Lonelyrockroll/qiansai/hardware/pcb/32键扩展说明.md

# Nos Pico 32 键 PCB 扩展说明

当前修正版：`ProPrj_nos_pico_32key_repaired_2026-09-24.epro2`，已在嘉立创 EDA 专业版 V4.1.60 中实际导入验证。

原交付路径 `ProPrj_nos_pico_32key_2026-09-24.epro2` 也已替换为相同的修正版内容。EDA 中的修正版工程名为 `nos_pico_32key_repaired`；此前打开的旧工程副本不会自动更新。

## 原理图修复

此前版本在生成工程包时混用了版本元数据和原理图坐标约定，导入后出现符号上下方向异常、引脚线段向元件外侧延伸，与元件边框之间产生间隙。先前仅报告 PCB DRC 通过，没有充分验证原理图显示。

修正版恢复了原 28 键工程的全部符号定义，以及原有 198 个原理图对象的位置和方向。新增四键重新使用原版符号、连续电源/地母线和电源符号绘制，并整理网络标签位置。

此次额外验证包括：

- 放大检查 EDA 中原有与新增灯光的 VDD/GND 引脚与元件边框连续相接。
- 对新增器件的 60 个引脚进行导线坐标相交检查，预期悬空的灯链末端除外。
- 从 EDA 实际导出原理图 `.enet`，验证全部 32 个霍尔的电源、地、信号网络和新增四路 ADG732 通道。
- 验证 64 颗琴键灯的数据串联关系，以及独立的 6 颗 Logo 灯链。
- 将实际原理图网表与交付 PCB 的 656 个焊盘网络逐项比较，0 项不一致。
- 在最终修正版工程中运行 PCB DRC，141 项检查，0 项错误。

## 已完成

- 在右侧增加 H29～H32 四颗 SS49E 霍尔传感器，保持原有 12.5 mm 键距。
- 板框向右延长 50 mm，EDA 显示外形尺寸为 412 × 64 mm。
- 原有 165 个 PCB 元件的位置和旋转角度均保持不变，扩展后共 185 个元件。
- 增加 D64～D71 共八颗琴键灯，接在原琴键灯 D56 之后；原 D57～D62 Logo 灯链保持原连接。
- 增加 C61～C64 四颗霍尔去耦电容、C65～C68 四颗灯光去耦电容，沿用原单元 0.1 µF 规格。
- 完成新增信号、供电、接地布线及双面铺铜重建。
- 新增独立原理图页 `32-key extension - H29-H32`；主原理图接出多路复用器剩余四路，并取消对应未连接标记。
- 原有 R3、R4 的原理图定义恢复为原 28 键版本，未再通过翻转符号规避坐标问题。

## 新增通道

| 琴键 | 网络 | ADG732 物理脚号 | 扫描地址（十进制） | A4～A0 |
| --- | --- | --- | --- | --- |
| H29 | S29 | 37 | 28 | 11100 |
| H30 | S30 | 38 | 29 | 11101 |
| H31 | S31 | 39 | 30 | 11110 |
| H32 | S32 | 40 | 31 | 11111 |

原 28 键的网络映射保持原样；原固件的扫描映射为 0～15、27～16，新增四键应在其后追加 28、29、30、31。

## 验证结果

- 嘉立创 EDA 实际完成 PCB DRC，检查项 141，结果 0 项错误。
- 原理图与 PCB 网表一致。
- 导出包 ZIP 完整性检查通过。
- 对导出文件独立核对：32 颗霍尔、8 颗新增 LED、8 颗新增电容、四路多路复用器脚号及网络、12.5 mm 键距、原有元件几何位置，均通过。
- 本次未制造 PCB，未进行实板电气或演奏测试。
- 原理图继承了原工程的离网格等警告；PCB DRC 的 0 错误不表示所有原理图警告均已消除。

## 后续配套修改

- FPGA 扫描、按键状态数组、校准数据应扩展为 32 键。
- 琴键灯数据长度由 56 颗扩展至 64 颗，Logo 灯仍为 6 颗。
- 若继续使用原 Pico 固件作测试，其 HID 报告中原先 28 琴键加 4 辅助键恰好占用 32 位；扩展后不能继续使用同一 32 位布局，需要同步修改报告结构和描述符。
- 外壳、支撑、转轴与键帽结构需适配新增四键和增加的 50 mm 板长。
- 本次工作范围为 28 键扩展至 32 键；此前讨论的 FPGA ADC 前端、电源跳线和标准 I2S 音频接口方案仍需另行落实。

## 备份与打开方式

扩展前当前 EDA 工程已备份为 `nos_pico_28key_before_expansion_20260924.epro2`，原始 `ProPrj_nos_pico_mini_2026-09-22.epro2` 未覆盖。

使用嘉立创 EDA 专业版的“文件 → 导入 → 嘉立创EDA（专业版）”导入交付文件即可。

`tmp/assessment/drafts` 中仅保存过程文件，不是交付版本。
