Lonelyrockroll/qiansai/MIDI-INPUT.md

# Keystation 61 MK3 五针 MIDI 输入

v33 在分级菜单版工程上增加 BMV51M001 输入。MIDI 数据由 FPGA 内的串口接收器、消息解析器、事件队列和声部分配逻辑处理，进入现有实时音源、效果器和 Loop。演奏输入在电脑、自制琴板和 MIDI 键盘之间切换，J18 的十二个打击垫可同时演奏。

本次交付码流为 `0x0000FAE1`，已于 2026 年 11 月 3 日临时下载到 Tang 并完成 JTAG 回读。本次实物 TX 丝印脚接 J8-5 的接法，已完成模块回环和 Keystation 独立供电的五针实板试弹。Keystation 的 USB 接充电器，演奏数据通过五针线进入模块及 FPGA；用户确认“能发声，松开也正常”。

## 接线与上电

使用 Tang Mega 60K、NEO Dock 31004 和明确包含 `midi_rx / AA19` 输入约束的 v33 码流。先在断电时接好模块供电、地和五针线，将模块实物 TX 数据线暂留空。上电后临时下载并核对 v33，保持该程序运行，再接这根 TX 数据线到 J8-5。

| 本次 BMV51M001 实物丝印 | Tang NEO 31004 |
| --- | --- |
| VDD | J8-1，3.3 V |
| GND | J8-3，GND |
| TX（模块逻辑输出） | J8-5，AA19 / PMOD1_IO6，FPGA 输入 |
| RX、NC | 演奏时留空 |

本次模块照片中，从 NC 起的丝印顺序为 **NC、RX、TX、VDD、GND**，与厂家接口表的 RX/TX 顺序相反。上表按这块实物的丝印和成功回环测量填写。正常演奏只接上述三根线；**只有独立模块回环诊断才把实物 RX 接 J8-6**，恢复演奏时将这根诊断线拔下。

J8 位于 KEY.0 与 POWER 之间，靠 HDMI 一侧。按板上 1 脚标记核对针号，插口正面与焊盘侧的方向互为镜像。J8-7/8 与蓝牙网络相连，J8-9～12 已承担音频和观测信号。

板子元件面朝上、正对 J8 插孔时，离 PCB 板面较高的一排是奇数排。沿插座从 POWER 端向 KEY.0 端依次是 1、3、5、7、9、11，较低的一排依次为 2、4、6、8、10、12。因此模块实物 TX 接较高排从 POWER 端数的第三个孔。官方 PCB 上的方形焊盘标记对应 1 脚。Tang 采用 DC 口供电时，引脚编号和模块使用的 3.3 V 接法相同。

五针线从 Keystation 的 MIDI OUT 接 BMV51M001 的 MIDI IN。Keystation 用自身 USB 供电。厂商资料将光耦后的逻辑输出称为 BMCOM RX，本次实物对应的是 **TX 丝印脚**。6N138 的输出上拉至模块 VDD，本接法使用 3.3 V。[BMV51M001 产品页](https://www.bestmodulescorp.com/tc/bmv51m001.html) · [原厂线路图](https://www.bestmodulescorp.com/en/amfile/file/download/file/2107/product/1316/)

Keystation 开机后，按 **Advanced**，再按琴键上方标有 **MIDI OUT** 的黑键。编辑模式退出后，琴键数据从五针口发送。该步骤见原厂手册的 MIDI Out 小节。[Keystation 61 MKIII 手册第 14 页](https://cdn.inmusicbrands.com/m-audio/maudio_documentation/Keystation%2061%20MKIII%20-%20User%20Guide%20-%20v1.6.pdf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)

实物照片确认 MIDI OUT 位于该区域两颗一组黑键的左颗，ENTER 为它左邻的白键。本机操作反馈为按过这颗黑键后仍须按 ENTER 才退出 Advanced，与上述手册的自动退出步骤不同。不要把 ENTER 灯灭单独作为五针输出已启用的证据，也不要连续盲目切换。

重新上电后的默认五针路由尚未单独验证，当次输出状态通过接收计数和实际发声确认。

SRAM 临时下载在断电后失效。下一次重新上电前先断开接 J8-5 的模块数据线（本次实物 TX），开机重载这份 v33 程序后，再恢复这根数据连接。历史 `control_pmod` 固件曾将 AA19 配成输出，其接线用途与本版不同。

## 使用

1. 在屏幕进入「设置」，选第一项输入来源，短按 B 在 PC、扫描、MIDI 之间轮换。切换会静音。已有 Loop 正在播放、录制或等待录制时，先结束该操作。
2. 选择「输入 MIDI」后，短按 A 回首页，短按 B 开始演奏并等待功放预热。
3. 按键发声，松键进入该音色的释放阶段。默认延音关闭，使用现有键盘即可测试。
4. 按住 B 并旋转调琴键音量。短按 A 或上位机「全部静音」停止演奏。音色、效果、鼓组和 Loop 的入口沿用分级菜单。

MIDI 模式下，音符在没有后续 MIDI 消息时继续保持。上位机断开或关闭页面后，FPGA 可独立演奏。切回 PC 输入时，电脑控制的心跳保护恢复生效。

屏幕设置页显示接收字节、支持的消息事件、异常累计和延音状态，三个数字显示各自计数器的低 16 位。上位机 MIDI 面板显示完整字节／事件计数、帧错误、队列溢出、按住音数、最近音符、力度、通道和满复音替换次数，并提供清计数按钮。

MIDI 按真实音高发声，包含黑键和 0～127 的音符编号。屏幕上方的 32 白键继续显示 C2～F6 范围内的白键反馈，最近音符编号可在上位机查看。

## 消息与声部

串口为 31,250 baud、8N1，输入经过两级同步。16 项事件 FIFO 缓冲音源背压。解析支持 Running Status、Note On 力度 0 作为 Note Off，以及穿插的实时消息。系统公共消息和 SysEx 会清除 Running Status。

| 消息 | 行为 |
| --- | --- |
| Note On / Note Off | 按通道和音符匹配，最多 32 个旋律声部。相同音符重弹会重新触发包络 |
| 力度 1～127 | 按当前琴键音量缩放，127 对应当前设定幅度 |
| CC64 | 每通道独立延音状态，值 ≥64 保持释放的音，值 <64 释放延音 |
| CC123～127 | 对应通道的 All Notes Off，遵循当前延音状态 |
| CC120 | 立即停止对应通道的音源声部，覆盖已进入释放段的声部 |
| CC121 | 复位该通道延音状态，并释放已经松开的延音声部 |
| System Reset | 清除 MIDI 声部与延音状态 |

所有通道使用屏幕当前选定音色。满复音时循环替换一个逻辑声部，原音符后到的 Note Off 会被识别为过期，避免关闭替换后的新音。FIFO 溢出或串口帧错误会请求明确静音并清理 MIDI 声部，随后可重新开始演奏。

Loop 记录已解析的演奏事件，包括力度与实际释放时刻。MIDI 的输入音高不套用自制琴板的白键交换表。共享效果器由现有效果设置控制，A 全部静音会同时结束效果尾音。

## 工程接口

- `fpga/midi_decoder.v` 负责消息边界和 Running Status。
- `fpga/midi_input.v` 负责接收、FIFO、通道／音符所有权、延音和统计。
- `fpga/performance_router.v` 为 MIDI 松键读取发声时保存的包络参数，立即停止事件使用零幅度。
- `fpga/display.cst` 将 AA19 固定为上拉的 3.3 V 输入。
- 输入模式 0 为 PC、1 为原单通道 ADC 测试、2 为自制 32 键扫描、3 为 MIDI。

冻结的 `display.cst` 注释与 `tests/midi/results/pin_audit.json` 仍保留当时引用的厂家信号名 `BMV51M001 RX`。FPGA 接点始终是 J8-5 / AA19；本次实物的接线以本页丝印表为准，码流和构建时源码哈希保持不变。

二进制 UART 命令 37 使用现有 28 字节帧。请求 payload 的首字节 0 查询，第二字节 0／1 选择普通／扩展统计。首字节 1 设置输入模式，第二字节为 0～3。首字节 2 清统计，首字节 3 全部静音。普通回应包含模式、RX 高低、会话、功放就绪、延音、异常、保持数、队列深度、字节数、事件数、帧错误、溢出和最近音符。扩展回应的 payload[1] 最高位为 1，包含力度、通道、延音通道掩码、过期松键、替换次数和 MIDI 持有声部数。固件版本为 33。

## 验证入口

```powershell
python tests/midi/run.py
python tests/midi/run.py --physical-baud
python tests/midi/run_controller.py
python tests/midi/run_audio.py
python tests/navigation/run.py
python tests/navigation/run_integration.py
```

真实键盘验收应观察收包计数增加，试听单音、黑键、和弦、轻重触键、重复击键和全部松开。验收时记录实际码流与下载结果，串口仿真结果和真实琴键验证分别保存。

本版完成 63 项串行／分配检查，分别使用缩短的串口分频和实际 50 MHz／31,250 baud 配置。完整音频仿真解码了 553 个 I²S 样本，普通松键与踏板释放均能归零。控制器回归验证 MIDI 不随 PC 看门狗超时停止，实板进一步验证了 3.5 秒无电脑消息时 MIDI 会话继续保持、PC 模式按时关闭。板上还复测了菜单与 32／31 峰数字音频。

布局使用 51,113 / 59,904 Logic、25,820 / 60,780 寄存器、117 / 118 BSRAM 和 60 / 118 DSP。主时钟 Fmax 为 50.001 MHz，像素时钟为 49.743 MHz，USB 为 69.255 MHz。四个时钟域的建立、保持违例均为零。主时钟接近 50 MHz 目标，后续改动应重新执行布局与时序核对。

## 2026-11-03 直连诊断记录

- 按用户提供的[倍创中国站资料](https://www.bestmodulescorp.com.cn/zh/bmv51m001.html)核对：BMCOM RX 接主控接收输入，供电 3.3 V 可用，UART 为 31,250 bps。Tang 官方 31004 原理图第 19、7 页确认 J8-5 → PMOD1_IO6 → AA19。
- 运行中的 MIDI 字节计数独立于演奏会话和静音开关。静音不导致接收统计被关闭。
- 同源独立 Gowin 布局后仿真验证 MIDI 与 PC 两个串口分频：19 个 MIDI 字节、4 个 PC 字节、6 个解析事件通过，包括 ±1% 位宽与坏停止位恢复。该结果来自独立测试工程，整机加密网表未作该项门级仿真。
- 临时被动诊断码流 `0xEFEB` 将 J8 的 8 个信号脚全部设为输入，连续统计双边沿、低电平周期、UART 字节和帧错误，另观察 AA19 的反相解码。诊断时关闭功放。
- 分别向 Keystation 两个 USB 输出端口发送 1,779 与 1,783 条 Note Off，八路输入均为高电平，边沿、字节、正常极性帧错误增量均为 0。
- 用户完成两组各三次实体按键，中间操作 Advanced / MIDI OUT / ENTER。记录的 625 个快照中，八路输入仍为高电平、累计边沿和正常极性接收字节均为 0。反相通道在持续低电平下的一次帧错误是预期，不能当作 MIDI 数据。
- 目前记录说明这些输入上没有检测到数字跳变，尚不足以区分键盘路由设置、实际接点或模块输入链路。未据此判定线缆或设备损坏。

后续将 Keystation 改用 USB 充电器独立供电，在初始状态及一次 MIDI OUT 切换后分别试弹，Tang 均未收到字节。电脑 USB 对标准设备身份查询能够回包，但本轮两颗指定琴键未在 USB 监听中出现；不能用身份查询代替演奏数据验证。

为进一步分离接收软件、插孔与模块路径，构建独立有界回环码流 `0x5A64`（SHA256 `910a56ad424488ac146d11a29c3e315911a92a631d99e835c4b9740627526947`）。J8-6 / AB20 平时高阻，仅收到显式测试命令后发送 64 个 `0x55` 字节，发送结束自动恢复高阻，另有 100 ms 关断计时器。J8-5 / AA19 及其他输入均被动观察，功放关闭。

| 实板连接 | AB20 发送脚回读 | AA19 接收脚 | 结论 |
| --- | --- | --- | --- |
| 首次按实物丝印：AB20 → 模块 TX；模块 MIDI OUT 经五针线接自身 MIDI IN；模块 RX → AA19 | 64 字节、640 边沿、0 错误 | 0 字节、0 边沿 | 此接法未返回数据 |
| 移开模块数据线，用杜邦线直接连接 J8-5 与 J8-6 | 64 字节、640 边沿、0 错误 | 64 字节、640 边沿、0 错误，全部为 `0x55` | 实际插孔、FPGA 输入及 31,250 baud 收发通过 |
| 按实物丝印交换：AB20 → 模块 RX；模块 MIDI OUT 经五针线接自身 MIDI IN；模块 TX → AA19；已拆除 J8-5/6 直连跳线 | 64 字节、640 边沿、0 错误 | 64 字节、640 边沿、0 错误，全部为 `0x55` | 模块收发及五针线回环通过 |

前两轮证据分别保存在 `module_loopback_session/physical_loopback_01.json` 与 `direct_j8_loopback_01.json`。直接跳线回环先确认了 FPGA 引脚与串口通路；随后对照模块照片，发现实物 RX/TX 丝印顺序与厂家接口表相反。

用户明确拆除了 J8-5/6 的直连跳线，再按实物 **TX→J8-5、RX→J8-6** 接入模块，五针线仅连接模块自身 MIDI OUT 与 MIDI IN。`module_loopback_session/physical_loopback_swapped_02.json` 记录了成功的完整模块回环：AA19 与 AB20 都为 64 字节、640 边沿，最近字节 `0x55`，帧错误与异常字节标志均为零，发送结束后恢复高阻。AA19 的低电平累计为 505,697 个时钟，AB20 为 512,000 个时钟。此结果确认模块及五针线的数据通路。

随后恢复演奏主程序 `0xFAE1`，拔除 J8-6 的模块 RX 诊断线。Keystation USB 保持连接充电器，五针 MIDI OUT 接模块 MIDI IN，模块只接实物 TX→J8-5、VDD→J8-1、GND→J8-3。电脑没有运行 MIDI 转发进程，只查询 Tang 的接收和音频状态。用户试弹后确认“能发声，松开也正常”。

`din_acceptance_summary.json` 汇总 1,185 个状态快照：累计 162 字节、54 个事件，帧错误和队列溢出均为 0；采样到非零 PCM，绝对值最大 879。用户松键、尚未执行软件静音时，held、gated、active 和 PCM 已全部归零；随后显式静音，功放静音状态为真。完整采集记录为 `din_acceptance.jsonl`，下载包收录汇总和操作者试听确认说明。此次实板验证范围为独立供电五针链路的试弹发声与正常松键。

复现资料位于工作目录 `tmp/midi_keystation_diag_20261103/`：`gate_audit/`、`j8_probe/`、`j8_probe_session/`、`module_loopback/`、`module_loopback_session/`。所有本轮下载均为 SRAM 临时下载，未改写 Flash。
