Lonelyrockroll/qiansai/VOLUME-RANGE.md

# 琴键音量 40% 版本

本版将实体琴键的数字幅度上限从 25% 调整为 40%，并将重新下载后的试听设置设为 32%。在峰值保护尚未介入时，同一音符由 25% 调到 32% 的幅度比例为 1.28，约增加 2.14 dB。40% 相对 25% 的幅度比例为 1.6，约增加 4.08 dB。

已临时下载的码流为 `0x00000239`，在 v32 FX2 基础上扩展音量范围。实板 1 kHz 单音在 25%、32%、40% 的峰值分别为 4096、5243、6554 码，32% 与 25% 的 RMS 比例为 1.280036。40% 下四音和弦，以及普通、高增益两档的 32 声部组合效果均通过检查，效果器削波和超时标志为零。多声部压力测试中峰值保护参与了输出调节。静音后抓取的 2048 点 PCM 全零，记录保存在 `tests/volume40/board/results.json`。

布局布线及引脚核验通过，物理 BSRAM 占用 117/118，DSP 占用 57/118。源码与时序报告在 `firmware/volume40-build.json`。

旋钮 B 按住并旋转、板载菜单、蓝牙加减命令和上位机使用相同琴键上限。鼓组的上限为 25%。音量值作用于随后触发的琴键，重新弹奏即可听到变化。

上位机从输出状态包读取 `keyboard_limit_percent` 和 `keyboard_limit`，据此配置实体琴键并处理音量加减。旧固件未报告上限时沿用 25%。琴键引擎和原有峰值保护继续负责多声部混合后的动态范围，实际压峰计数可以从上位机读取。

源码修改位于 `fpga/uart_control_display.v`、`fpga/native_usb_bridge.v` 和上位机的 `protocol.py`、`server.py`、`index.html`、`keypad.html`。`tests/volume40/test_volume.py` 检查协议兼容、琴键与鼓组边界以及原生旋钮逻辑，`tests/volume40/board_check.py` 通过实板验证参数范围和 PCM 幅度。
