Lonelyrockroll/qiansai/EFFECTS-ENHANCED.md

# v32 FX2 数字效果增强

本版统一板载第 9 项「切换效果」、手机 F 命令和上位机的预设。各入口依次选择原声、混响、延时、合唱、组合效果。旋钮 B 选到「开始演奏」并执行后，可用相同琴键与音量比较声音。

已临时下载的码流为 **0x000079A5**，UART 版本号 32，效果配置标记 `effect_profile=2`。实板通过两种预设入口的逐项回读。源文件、引脚、四个时钟域的 setup/hold 和码流散列均通过校验，详见 `firmware/effects-v32p2-build.json`。

| 预设 | 生效参数 |
|---|---|
| 混响 | 混合系数 128/256（50%），长尾空间；四路梳状反馈系数 248/256（96.875%） |
| 延时 | 混合系数 128/256（50%），约 320.02 ms，回声反馈 112/256（43.75%） |
| 合唱 | 混合系数 128/256（50%），约 0.8 Hz，中心延迟 10.49 ms，调制深度约 ±3.9 ms |
| 组合 | 混响和延时系数各 64/256（25%），合唱 112/256（43.75%），其余采用上述参数 |
| 钢琴轻空间 | 混响系数 64/256（25%），中等空间，反馈 240/256（93.75%），可在上位机单独选择 |

回声缓存沿用 8192×16 位，双样本平均后半速写入，湿声返回采用线性插值。四档回声间隔约为 80、160、240、320 ms。混响的三个空间档位对应 224/256、240/256、248/256 的梳状反馈。合唱中心延迟保持稳定，调制深度的四档约为 ±1.3、±2.6、±3.9、±5.2 ms。

切换预设时，当前湿声淡出，历史缓存失效，新参数生效。相应延迟历史建立后，湿声逐步淡入。这一处理覆盖持续按键时切入合唱的场景。全部静音通过原有淡出、功放关断和缓存清除流程停止效果尾音。

## 参数入口

在上位机选择「混响」「延迟」「合唱」可直接应用预设，也可调整各自滑条。混响与延时的系数之和上限为 128/256。效果状态包的保留位标记 FX2，上位机据此显示 320 ms 档位和扩大的混合量范围，并保留对旧固件的预设支持。核心音频仍为 48,828.125 帧/秒。

## 同一乐句对比

`output/effects-v32p2/` 中的文件由同一个 HDL 音源乐句生成，先演奏钢琴单音与和弦，再保持风琴和弦，最后保留尾音。效果输出采用与 RTL 逐样本对照的整数参考模型。所有文件使用同一试听增益 2.8598734453，WAV 文件头采样率为 48,828 Hz。

- `new_off.wav`、`new_reverb.wav`、`new_delay.wav`、`new_chorus.wav` 是本版的四种声音。
- `previous_*.wav` 使用旧版上位机预设和旧版效果算法。

统一乐句在 4.7 秒后的混响尾段 RMS 比旧版约增加 14.5 dB，延时尾段 RMS 约增加 13.6 dB。完整的峰值、原始采样数和文件散列在 `audition.json` 中。旧板载混响预设的混合量为 18.75%，旧上位机混响预设为 31.25%，本次对比采用后者。

## 复核入口

`tests/effects_enhanced/verify_fx.py` 对照整数参考与 RTL，覆盖旁路、回声、混响、合唱、组合效果和缓存清除。`transitions.v` 覆盖持续激励、同步清除与配置、反馈尾音归零和禁音。`switching.v` 用持续 333 Hz、12000 码正弦检查五次效果切换。`test_presets.py` 检查新旧固件能力标记、参数限制及静音保持。

已完成 227,051 个采样的逐值对照，测试中无数字削波和运算超时。持续正弦切换时，最大相邻样本变化为 649 码。单独的尾音回归覆盖 200,000 个静音输入帧。`board_check.py` 用正常板载菜单动作和上位机配置入口复核参数，并抓取板上最终 PCM。

FPGA 源码在 `fpga/audio_effects.v` 与 `fpga/uart_control_display.v`。上位机预设与能力适配在 `realtime_synth/host/fx_tools.py`、`protocol.py` 和 `index.html`。构建使用仅谱峰显示配置。

## 实板结果

- 回声脉冲的两组中心位于第 15626、31252 个采样点，对应间隔 320.02048 ms。两次峰值为 1687、738 码，第二次按约 43.75% 比例衰减。
- 0.3 秒测试音停止后，在距起音约 0.9 秒处抓取的混响尾段仍有信号，峰值 14 码，RMS 5.64 码。
- 输入同一个 1 kHz 正弦时，原声的分窗频率估计约 999.997～1000.006 Hz；合唱的局部相位斜率随调制变化，分窗估计约 995.44～1009.34 Hz。
- 组合效果下 32 声部持续发声通过。原有峰值保护参与了该压力测试，效果器和音源的削波、超时标志均为零。全部静音后的 4096 点最终 PCM 全零。

本轮实板采集点是最终数字 PCM，模拟监听在自动测试时关闭。统一乐句 WAV 用于同源、同增益试听；使用板载耳机或喇叭时，执行「开始演奏」再切换效果。

整机布局占用 46,948 / 59,904 Logic、25,051 / 60,780 寄存器、117 / 118 BSRAM、57 / 118 DSP。系统、像素和 USB 时钟的报告 Fmax 分别为 50.020、49.027、70.031 MHz，目标分别为 50、49、60 MHz。保留的 PR1014 时钟布线提示及完整时序结果在构建报告中。
