Lonelyrockroll/qiansai/延迟测试接线.md

# Tang Mega 60K NEO 演奏延迟测试接线

适用实物是 **NEO 31004 rev1.4 底板、Type-C 独立 5 V 供电的 32 键霍尔琴板**，以及带 `LAST I2S` 和 MARK 的演奏固件。最容易先做的是用一根探头测板内事件到 I²S 的时间；要回答真实琴键电信号到耳机出声用了多久，需要两通道同时采 H15 和 J25。

## 先认准测点

2026-11-02 还完成了固定 H15 的排针实测。CH1 取 U1 的 ADC_OUT，CH2 取喇叭功放一侧对公共地，两个 BNC 红黑夹线均设为 1×。使用敲击钢琴、25% 音量、功放预热。U1 松键／按住的校准读数约为 0.358／0.122 V，结合 ADC 码估计本次按下门限为 0.149914 V（下降）。每次均单独确认 H15 的 ON、OFF 和新计时各一次。声卡、PC 串口时标均未参与延迟相减。

| 有效实测 | U1 越阈 → 功放单端音符超过 10 mV | 同次 FPGA 数字段 |
|---|---:|---:|
| 1 | 1.2744 ms | 78 µs |
| 2 | 0.9112 ms | 73 µs |
| 3 | 1.1664 ms | 84 µs |

三次中位数为 **1.1664 ms**，最大值为 **1.2744 ms**。200,000 个同步样本、每点 0.8 µs；两路各作 51 点因果移动平均，每个交越至少持续 26 点。CH2 以每次记录开头的约 5 ms 作为静音基线。门限改变会改变读数，例如把 CH2 门限从 10 mV 提高到 15 mV，第二次变为 2.3640 ms；把静音基线延长至约 20 ms，第一击的 10 mV 结果变为 0.8064 ms。这些是固定单通道的电气响应。普通 32 键扫描、喇叭两端差分电压和声学起音需各自验证。[真机时间差与判据](output/latency/acquisitions/U1_speaker_20261102104604/speaker_summary.json) · [查看三份波形](http://127.0.0.1:8769/latency-monitor?segment=fixed-adc-speaker-leg)

2026-11-02 在精简版 `0x00005463` 完成了一次 H15 单键实测。TBS2202B 的 CH1 接 J8-10，使用 1.52 V 门限量得 **82.64 µs**，板内同次 LAST I2S 为 **82 µs**（序号 360）。单次按下、松开及有效测量各增加一次。采集 20,000 点，12.5 MS/s，每点 0.08 µs。按相邻采样点给出的门限脉宽区间为 82.56–82.72 µs，这只是采样分辨区间。CH1 高平台碰到量程上沿，因此这次只报告脉宽，不报告 MARK 高电平的真实幅值。该记录未接耳机模拟通道。[原始数据与板内对照](output/latency/acquisitions/20261102_180817_443523/agreement.json)

| 测点 | 探头尖端／信号线 | 参考点 | 该点代表什么 |
|---|---|---|---|
| H15 原始霍尔 | **琴板 H15 的 2 脚 OUT**，网络 `S15` | 琴板 `U1.3` 或 `U5.3` GND | 第 15 个物理白键（从零编号 14，默认 C4）在复用之前的连续模拟电压 |
| MARK | **Tang J8-10**，FPGA `AB22`，3.3 V 逻辑 | J8-3 或 J8-4 GND | LIVE 页一次孤立起音的板内计时标记 |
| 标准 I²S | J8-11 `Y21` 为 BCLK，J8-12 `Y22` 为 LRCLK，J8-9 `AB21` 为 DATA | J8-3 或 J8-4 GND | 数字左／右声道字。静音时两根时钟仍运行 |
| J25 耳机左声道 | **J25 插头 tip（最尖端）**，右声道可用 ring1 | **ring2（靠近套筒的第二个环）**，GNDA | 经过板载 PT8211、模拟放大及耦合后的实际电气输出 |

**H15 焊盘位置已经由 PCB 数据核对。** 这一版工程的 H15 是 `SS49E_SOT23`，1 脚为 +5 V，2 脚为 OUT，3 脚为 GND。元件在顶面。按 H14 → H15 → H16 的实物排列定位，H15 有两脚的那一侧，**靠 H16 的脚是 2 脚**，靠 H14 的脚是 1 脚；另一侧孤脚是 3 脚。导出的网表与 PCB 焊盘均把 `S15` 连到 **U2.46**（ADG732 的 S15 输入）。断电时可以测 H15.2 ↔ U2.46 的连通性，用来确认板型和方向。实测优先用 H15.2，必要时断电焊一根短测量线并固定，避免用探头在密集的 U2 管脚间滑动。[键盘 PCB 工程](hardware/pcb/ProPrj_nos_pico_32key_TypeC5V_1LED_ADC_2026-09-26.epro2)

**固定 H15 记录的黄线从哪里开始计时。** 板内松键校准基线 4508 码，配置的按下偏差 256 码，本次为下降方向，所以目标是 4252 码。同步标定松键和按住两个状态，中位数分别为 4498 码／0.358 V 和 4219 码／0.122 V，由这两点插值得到约 0.150 V。这条黄线位于此次电压变化约 88% 处；电压变化比例不能当作键程比例。判据文件保存时间为 18:51，三份有效波形从 18:58 起采集。记录和 CSV 可在任意电脑上复算，这些时间戳没有第三方签名。[校准原始码](output/latency/acquisitions/U1_speaker_20261102104604/cal_points.json) · [采集前判据](output/latency/acquisitions/U1_speaker_20261102104604/criteria.json)

保持音频 10 mV 门限和分析窗口，若将起点改在此电压摆幅的一半（0.240 V），三次算得 7.8880、4.3464、4.5456 ms；这是判据敏感性复算，不是固件的按下门限。0.140 V 和 0.160 V 的试算也在汇总中保留；首次击键在这两种替代门限上存在多次交越，按正式规则标为无效。前两次尝试没有采到同一次有效按键，各自门控增量均为零，不能用于数值统计。[逐次复算和全部替代门限](output/latency/acquisitions/U1_speaker_20261102104604/speaker_summary.json)

H15 对应扫描地址 14（A4…A0 为 `01110`），U2 的通道名为 S15。键盘 U2.43 是**所有键共用的复用器输出**。再经 R1=10 kΩ、R2=2 kΩ 分压，才到 U1.11/U1.12 和 Tang J11-2。测单键的连续电压应探 H15.2；保留既有 J13/J11 接线，H15.2 不要另接到 Tang 的 ADC 输入，也不要在仍由霍尔驱动的节点并入信号源。若实物版号、封装或丝印与此版本不符，以断电核实的 `S15` 连通关系定位。

J8 是 KEY.0 与 POWER 之间的 PMOD 插座，J9 在 KEY.1 与 KEY.0 之间。按实物 1 脚标志数脚，J8-1/2 是 +3.3 V，地是 J8-3/4。J25 用 CTIA 四极分线器最好辨认，从尖端到套筒依次为 L、R、GND、MIC；本实验让 MIC 空着。31004 图纸第 10 页标明 R213（0 Ω）连接 GNDA 与 GND。断电确认实际装配导通、琴板与底板共地后，普通台式示波器的两通道共用一个已确认的地参考，探头尖端分别接信号。地夹不能接到 J27/J28 桥接扬声器的任一输出。端口映射可复核[工程约束](fpga/display.cst)和 [Sipeed 底板资料](https://dl.sipeed.com/shareURL/TANG/Mega_138K_60K)中 31004 原理图第 7、10、19 页。

## 四种测法

**测喇叭两端。** 31004 Rev 1.4 原理图第 10 页显示，J27 是左声道，1 脚为 VOLN，2 脚为 VOLP。J28 是右声道，1 脚为 VORN，2 脚为 VORP。两脚均为 NS4263 功放输出。用两根普通 10× 探头测 J27 时，两根探头的地夹只接同一板卡 GND（如 J8-3），CH1 尖端接 J27-2，CH2 尖端接 J27-1，设相同倍率、耦合和量程，选数学运算 CH1−CH2。右声道在 J28 同样接。断电接线、保留喇叭负载，J25 拔掉耳机或转接头以启用喇叭。只有一根普通探头时不能取得喇叭两端差分波形。若要同次测 MARK 或霍尔到喇叭端电气起音，可用一只合适的差分探头跨接该声道的 2、1 脚接 CH2，普通 CH1 接触发点。真实空气中的发声起点另由麦克风测量。[底板原理图](https://dl.sipeed.com/shareURL/TANG/Mega_138K_60K) · [泰克普通探头的接地方式](https://www.tek.com/en/support/faqs/does-the-tbs2000b-have-isolated-inputs)

第一次可以只用 CH1。若是原 10× 探头加双头鳄鱼夹延长，仪器和探头保持 10×；若是直接从 BNC 到红黑双夹的无衰减线，通道选 1×，红夹接 J8-10，黑夹接 GND。在 J8 先插两根绝缘杜邦线，再夹分开的线端。示波器 BNC 外壳接保护地，黑夹只夹确认的 GND。[泰克接地说明](https://www.tek.com/en/support/faqs/does-the-tbs2000b-have-isolated-inputs)

| 目标 | 示波器 CH1 | 示波器 CH2 | 读数与边界 |
|---|---|---|---|
| FPGA 数字段 | J8-10 MARK | 可空 | 单次采集的高脉宽。上升沿表示 FPGA 接受孤立 Note On；下降沿是首个非零标准 I²S 左字收完整后，计数逻辑在下一系统时钟采认该字。与真正的字结束点相差约 20 ns |
| 霍尔到扫描确认 | H15.2 | J8-10 MARK | CH1 首次越过**实际按下阈值**到 CH2 上升沿，包含等候轮询、ADC、迟滞识别和事件握手 |
| 扫描确认到模拟输出 | J8-10 MARK | J25 tip 相对 ring2 | CH1 上升沿到 CH2 满足模拟起音判据，包含 FPGA、板载 DAC 和模拟后端 |
| 霍尔到模拟输出 | H15.2 | J25 tip 相对 ring2 | **首选整段电气测试。** 同一次采集内以霍尔跨阈值为起点、耳机口模拟起音为终点；机械键程前段、扬声器和传播距离另计 |

若有四路逻辑分析仪，可在一次采集中接 MARK、BCLK、LRCLK、DATA 和公共地。按 BCLK 上升沿采样，标准 I²S 的 MSB 在 LRCLK 边沿后一位，取首个非零左声道 16 位字的末位。设计 BCLK 约 3.125 MHz、LRCLK 每帧约 20.48 µs。测整帧周期即可复核采样率；核对 MARK 和数据字末端约 20 ns 的差异要有足够快的采样和已知的探头时延。两通道示波器可直接做表中的每一行，无法一次采齐四根数字线。J8 引出的标准 I²S 与板载 PT8211 的串行格式并行输出同一音乐样本；单独测 DAC 自身延迟时，起点应取 PT8211 的实际样本锁存时刻。[串行输出 RTL](fpga/audio_tx.v)

## 实操顺序

**只用排针测 H15 的办法。** U1-11 和 U1-12 均为分压后的 ADC_OUT。维持原有 ADC 连线，CH1 尖端接这两脚中空闲的一脚，地夹接已共地的 U1-13。上位机选“单路 ADC 信号源”，测试键填 14，松开所有键、应用并校准。该模式将复用器地址固定在 H15，不用外接信号源，CH1 可以连续观察 H15 经分压后的变化。按 ADC_OUT 所在节点重新确定触发门限，记录为“固定 H15 单通道 · ADC_OUT 越阈到功放单端起音”。切回“ADG732 · 32 键扫描”后需重新松键校准。正常轮询时 U1-11/12 分时连接各键，其波形不能标定 H15 在任意时刻的原始越阈时间。U5 没有引出霍尔模拟输出。

要用两根普通探头看真实琴键到喇叭功放一侧的电气响应，可将 CH1 接 H15.2、CH2 接当前喇叭的 J27-2（左）或 J28-2（右），两个黑夹同接已确认的公共 GND。先根据 H15 松键和按压时的电压、板内 ADC 码及当前 press 门限确定 CH1 的按下方向和触发电平。两路在同一次单次采样中，以 CH1 越阈为 t₀，以 CH2 预热安静基线后出现并持续超过固定门限的音符为 t₁，电子链路延迟为 t₁−t₀。若单侧波形被开关载波或共模跳变淹没，不将其第一条边沿判为音频起点。导入展示页时选“霍尔越阈 → 喇叭功放单端起音”，在条件里注明具体管脚、音色、音量、预热状态和是否滤波。此段已包含 FPGA 数字处理，不能再加一次 MARK 脉宽。

1. 断电接好地参考、探头与耳机分线器，确认探头倍率与示波器设置一致。使用高阻输入和 DC 耦合，先用宽量程找静态电平，再调小量程分辨变化。不要将 J25 左右声道短接。
2. 上电开启 32 键扫描，全部松开再校准。如果手机交换过键位，恢复默认布局或记下 H15 的当前音高。固定音色、音量和效果，结束 Loop，关闭混响等效果并等待尾音结束。执行“开始演奏”并预热，保持能听见单音且输出未削波。需要测 MARK 时选第 13 项“声谱观察”，短按 B **一次**进入 LIVE，保持此状态。其他页面以及 32/31 音测试状态的 J8-10 会输出采样节拍。
3. 若以 Hall 为起点，先定 CH1 的阈值。对 H15 读取稳定松键的 `baseline` 与 H15.2 电压 V₀，再慢慢按到阈值附近、稳定保持，记录同键的另一组原始码和电压。用相邻两点估计每伏对应的码数，或在按下阈值两侧插值。固件判定 `abs(raw − baseline) ≥ press`，默认 `press=256`，现场以当前配置为准。CH1 的阈值是相对 V₀ 的电压变化，并按这块板的实测极性选上升或下降。不要直接把 256 码写成固定伏数，也不要把 ADC 分压后的电压作为 H15.2 的探头阈值。[扫描与阈值逻辑](fpga/keyboard_input.v)
4. 示波器选单次采集。MARK 可先用 1 V/div、上升触发约 1.65 V；仅量 MARK 时用约 50 µs/div，再按实际脉宽细调。测 Hall 或 J25 时可先用 1 ms/div，并保留约 20%～40% 静止预触发区。模拟两路宜至少 1 MS/s，并在导出时确认实际采样间隔。CH2 从静音噪声测出合适的幅值阈值与连续点数，随后保持同一判据。
5. 每次只按 H15 一个键，保持片刻后松开。看 `LAST I2S` 键号对应 H15，完成次数确实比按下前增加 1，物理 ON/OFF 差值最终各为 1。有和弦、既有尾音或中途取消时，屏上会保留最近成功值；当前这次的高脉冲只有在完成次数更新时才作有效测量。分别记录预热状态和从静音同时启动的状态。[计时 RTL](fpga/onset_meter.v)
6. 各次把两条**同一次采集的波形**导出到同一个 CSV，保留时间列、各通道实际单位、阈值、音色、音量和探测位置。按文件逐次计算最小、中位、最大和峰峰值。不同按键的两次记录、PC 串口时间戳和独立声卡的起始时间不能直接相减。

以下命令是“MARK → J25”示例，假定 CSV 的时间列单位是秒，−2 ms 至 −0.2 ms 是安静基线区。10 mV 只是示例的模拟幅值判据，实际应根据此次空闲噪声选定。换成“Hall → J25”时将 CH1 阈值和方向替换成第 3 步的实测值。

```powershell
python tools/analyze_onset_csv.py take01.csv take02.csv `
  --time-column TIME --trigger-column CH1 --audio-column CH2 --time-unit s `
  --baseline -0.002 -0.0002 --trigger-threshold-v 1.65 --direction rising `
  --audio-threshold-v 0.010 --audio-points 3 --output onset.json
```

## 用 Ampero II Stomp 同时录音

Ampero 这一路适合保存 J25 的实际声音、波形和频谱。使用 **6.35 mm 立体声 TRS** 插进 Ampero 的 **STEREO FX LOOP RETURN**。J25 的 L → RETURN tip，R → ring，GNDA → sleeve。可用 J25 的 CTIA 耳机分线端再接立体声转接线，先用断电导通档确认 L/R/GND 三路一一对应。若只接左声道，使用正确的分线线缆将 L 和 GNDA 送入 RETURN 左路，避免让未用的右声道输出短接到地。

Ampero 用 USB 接电脑，在 GLOBAL → USB Audio 确认 `REC LEVEL (5/6)` 未静音，可先设 0 dB；电脑选择 HOTONE ASIO 录音输入 **5（左）和 6（右）**，实际有信号后调整电平以免削波。RETURN 两路直接送到 USB Input 5/6，不依赖当前预设效果链。[Hotone 官方手册，Panel 与 USB Audio](https://res.hotoneaudio.com/prod/support/Ampero%20II%20Stomp_Online%20Manual_EN_Firmware%20V2.3.1.1742958961280.pdf) · [本项目既有录回记录](OUTPUT-CALIBRATION.md)

要边录音边测延迟，可在分线器上把 J25 左路同时送到 Ampero 和高阻 CH2，CH1 按上表选 MARK 或 Hall。**延迟从示波器 CH1/CH2 算，音频档案从 Ampero 录。** 常规 RETURN 的 5/6 是同一音频的左右声道，没有动作参考。不要把霍尔 5 V 供电节点、未经转换的 MARK 或 I²S 数字线直接接入 RETURN，也不要用 Ampero 波形和另一次示波器记录的电脑时间戳组成延迟。

## 对照第 115 条

在本工作站，可以在网页点“读取板内最近一次”，或将导出的 CSV 导入网页。选择“仅 CH1 · MARK 高脉宽”时，时间列选示波器时间列，电压列选 CH1，逻辑门限可用 1.5 V。CH1 与 CH2 同测时，按实际接点选“霍尔 → 耳机”或“MARK → 耳机”，并记录两个阈值和静止基线区间。[打开延迟测量台](http://127.0.0.1:8769/latency-monitor)

本机还可以在已经校准、预热并进入 LIVE 后，用下列命令采下一次按键。先把 TBS2000B 设成 CH1 上升沿、Normal 触发、1.5 V 门限，约 100 µs/div、20,000 点，探头倍数应与通道设置一致。运行后等单次采集就绪，只按 H15 并松开。脚本会核对琴板 ON/OFF 与新计时都各增加一次，并比较同一次的示波器脉宽与 LAST I2S，符合条件才在网页发布为同次对照。此命令需要本机的 TBS2000B 控制技能、Gowin Programmer 和已经接好的 Tang。

```powershell
python -B -X utf8 tools/measure_live_mark.py --seconds 150
```

答疑优先要求 FPGA 本身满足对应延迟指标，外设和后端目前没有统一确认的计时口径。报告分别填“接受事件 → 标准 I²S”“Hall 越阈值 → J25”“机械动作参考 → 固定距离麦克风”。最后一项需要把动作参考与麦克风放进同一时基采集。将同一端点的结果分别与基础 10 ms、拓展 5 ms 比较，注明采样分辨率和动作相位散布。`LAST I2S` 的单次数字读数只填第一栏。[第 115 条与验收测量说明](赛题二问答与验收测量.md) · [波形分析工具说明](tests/contest_latency/README.md)
