Lonelyrockroll/qiansai/延迟展示包使用说明.md

# Tang 演奏延迟展示包

在 Windows 上把整个 ZIP 解压到可写目录。安装可从命令行执行的 Python 3.10 或更新版本，然后双击 `启动延迟实测.cmd`。默认页面为 `http://127.0.0.1:8769/latency-monitor`。离线浏览、播放包内 WAV 和导入 CSV 只使用 Python 标准库，不需要插开发板、声卡或示波器。网页在当前电脑保存导入的原始 CSV 和结果。

端口 8769 已被占用时，可在解压后的目录打开终端，执行：

```powershell
python -B -X utf8 realtime_synth/host/server.py --port 8770 --latency-page
```

## 包内可以复核的记录

- 板内计时记录来自 FPGA。读数对应按键事件被接受至首个有效 I²S 字，测量端点和单位见页面的记录来源。
- Ampero 的历史 C4 来自 2026 年 10 月 9 日的 v8 实录，保留了原始 WAV、设备元数据和采样表。录音启动前已经发出了音符，没有动作参考。界面提供波形和声音，不会从这段档案算按键延迟。
- 完整示例 CSV 位于 `tests/contest_latency/csv_examples/`。文件名带 `synthetic`，用于在无仪器时熟悉导入步骤，不是开发板的实测成绩。使用 `synthetic_rise.csv` 检查两通道导入时，时间列选 `TIME_US`、单位选 µs，两条信号列选 `HALL_V` 和 `OUT_V`。取基线 −30 至 0 µs，动作阈值 0.15 V、音频阈值 0.10 V、上升沿，结果应为 0.030 ms。导入演示样例时在名称中标注“合成样例”。

## 接上实际设备

测量接线请看[延迟测试接线](延迟测试接线.md)。读取板卡实时计时需要相应固件和 USB 下载器，独立声卡录音需要 Ampero、Hotone ASIO 驱动以及 Python 的 `numpy`、`sounddevice`。具体命令见 [Ampero 触键录音](AMPERO-LATENCY.md)。本包主要用于测量和展示，完整工程含 FPGA 工程和硬件源文件。
