Lonelyrockroll/qiansai/PC-AUDIO.md

# 电脑音频观察

**现场看声卡**时双击 `启动电脑声卡观察.cmd`，用浏览器打开本地页面。启动器只需要 Python 3，不连接板卡串口。完整工程中，也可从已经运行的上位机打开 `/audio-monitor`。

1. 如果要观察 Tang 的模拟输出，把耳机输出通过音频线接到声卡的合适输入，在 Windows 中确认该录音设备有电平。
2. 点“授权并列出输入”。这一步会临时申请系统默认输入以读取设备名称，并随即停止。再明确选择声卡对应的录音设备，点“开始实时观察”。选内置麦克风时会听到环境声音。
3. 页面连续显示最近 4096 点的波形、全带宽频谱、低频细看和单声道延时 XY。点“停止”会释放输入音轨，保留最后一帧。音频在浏览器本地分析，无扬声器返送。
4. 不接声卡时，可展开“用已有录音检查观察器”，选择 32 音、去第 16 音或去第 17 音的已采实板档案，也可选本地 WAV。这时页面标为“文件循环回放”，不会启动输入设备。

实时页标出所选设备、浏览器分析采样率及可读取到的输入轨采样率。WAV 回放还显示文件头采样率和浏览器解码后的采样率。Windows 混音与浏览器解码都可能重采样。频谱采用减均值的 Hann 窗，显示单边峰值幅度 dBFS，FFT 频点间隔为 `浏览器 Fs / 4096`。圆点是超过指定相对阈值和绝对阈值的局部极大值。XY 横轴取当前单声道样本，纵轴取 16 个样本前的同一路信号。例如浏览器以 48,000 Hz 分析时，延时是 0.3333 ms。电脑声卡画面与下面的 FPGA PCM 快照有不同采集来源，两者都是电脑分析，不作为 FPGA 屏幕硬件实时可视化项目计分。

## 核对 FPGA 数字输出

双击 `电脑音频分析.cmd` 可分析已采集的 32 音示范并打开本地 HTML 报告。将 `.pcm` 文件拖到此启动器上可分析自己的抓取。离线生成新图需要 NumPy 和 Pillow，脚本会在工程的 `.pc-analysis-env` 中检查这两个库，缺失时安装。实时页面以及包内已经生成的报告不需要这些库。

在上位机已经连接板卡时，可沿用“准备抓取 → 校验并导出 WAV → 下载分析用 PCM”。导出成功后可“释放已导出的缓存”。若要由命令行直接访问板卡，UART B 要可用。不要为了腾出串口中断正在演奏的会话。命令如下，在工具包或工程根目录运行：

```
电脑音频分析.cmd example off16 --open
电脑音频分析.cmd file "D:\captures\take.pcm" --fs 48828.125 --open
电脑音频分析.cmd status --device com:COM6
电脑音频分析.cmd capture --device com:COM6 --samples 4096 --trigger immediate --open
电脑音频分析.cmd ready --device com:COM6 --open
电脑音频分析.cmd release --device com:COM6 --capture-id 7
```

`capture` 读取当时经过 FPGA 混音和效果器的最终 16 位 PCM，采集点在 PT8211 专用偏置之前。可在演奏或板端测试音已经启动后运行。`immediate` 从当前输出开始，`nonzero` 等待非零样本，默认超时 12 秒。一次最多 32768 点，以板端报告的 48828.125 Hz 计算，最长约 0.671 秒。每次是冻结后校验 CRC32 的单次快照，不是连续直播。

新抓取遇到 PDF 占用、已有冻结结果、抓取正在等待/录入或 Loop 正在录制/待录，会保留现有状态并拒绝覆盖。播放中的 Loop 可被动取样；此入口只读状态和操作工程 PCM 缓存，不发 Loop、蓝牙录音、音量或功放控制命令。手机蓝牙演奏录音有独立缓冲。`capture` 在确认 CRC 且保存原始数据后释放它自己创建的临时抓取；若读取损坏则保留冻结结果。`ready` 仅读回当前已完成的块。要释放已有结果，请先用 `status` 核对编号，再用 `release --capture-id`。

每次输出到 `output/pc-audio/` 下的独立目录，含 `input.pcm`、`analysis.html`、`analysis.png`、`peaks.csv`、`spectrum.csv` 和 `analysis.json`。CSV 给出 FFT bin、频率、PCM 峰值幅度和 dBFS；图上显示下限 −120 dBFS。离线峰检默认查找距最大非直流峰 40 dB 内且幅度至少 1 PCM 码的局部峰。峰数受音色、噪声、窗和阈值影响，独立振荡器数量还须结合硬件声部和选择性关音验证。

## 现成的实板示例

三份原始数据分别为 4096 点，时长 83.886 ms，FFT 间隔 11.9209 Hz，XY 延时 0.32768 ms。按配套板测记录核对 CRC32 和 SHA256 后，电脑检测到 32、31、31 个过阈值局部峰，每个 FFT bin 都与对应的板测记录一致。关闭第 16 音缺失第 124 bin，关闭第 17 音缺失第 132 bin。可直接打开 [32 音报告](tests/pc_analysis/results/all32/analysis.html)、[关闭第 16 音](tests/pc_analysis/results/off16/analysis.html) 或 [关闭第 17 音](tests/pc_analysis/results/off17/analysis.html)。报告的“参数与来源”保留采集编号、首帧和文件路径。

实时软件路径已用 Chromium 的已知 32 音虚拟录音设备及上述三个已采文件验证。未在这项验证中接入实体外部声卡，不将浏览器结果标作 FPGA 数字 PCM 或模拟口实测。
