Lonelyrockroll/qiansai/SCREEN-NAVIGATION.md

# 屏幕界面与分级菜单

v33 在「设置」页将第一项扩展为「输入来源」，可轮换 PC、自制琴板扫描和 MIDI。MIDI 接线、无踏板用法与接收诊断见 [MIDI-INPUT.md](MIDI-INPUT.md)。下方 `0x000090FB` 的验证记录对应最初分级菜单版。

新版保留 1024×600 屏幕上方完整一行 32 个白键（C2–F6），把常用操作分为演奏首页、音色、效果、循环录制、曲目指引、设置六页。指引目标、下一组预告和实际按键反馈持续显示，进入设置时仍可观察演奏状态。

## 旋钮操作

以下为控制小键盘插在 Tang J18、USBA-Switch 拨到 FPGA 时的操作：

| 操作 | 功能 |
| --- | --- |
| 旋转 B | 移动菜单选择 |
| 短按 B | 执行选项或进入子菜单 |
| 子菜单选择“返回”再按 B | 返回首页，保留原来的分类位置 |
| 按住 B 并旋转 | 调整当前音量目标；在设置中选择琴键或打击垫 |
| 短按 A | 静音并回首页 |
| 旋转 A | 滑音，沿用原有音色适用逻辑 |
| 按住 A 并旋转 | 调整颤音 |
| K01–K12 | 固定十二种鼓声，与菜单页无关 |

琴键音量上限仍为 40%，打击垫为 25%。PC 接收窗口的旧快捷键映射独立保留，不等同于 J18 的按住旋钮手势。

## 页面内容

| 页面 | 操作 |
| --- | --- |
| 演奏首页 | 开始／停止演奏，以及五个分类入口 |
| 音色 | 敲击钢琴、纯净正弦、风琴、柔和音色、弦乐，直接选择 |
| 效果 | 干声、混响、延迟、合唱、组合，直接选择，沿用 FX2 参数 |
| 循环录制 | 录制／结束、播放／停止、撤销末层、最长 2／4／8 秒、清空 |
| 曲目指引 | 播放／暂停、返回开头并停止、速度、显示已接收的 PDF 曲谱 |
| 设置 | 琴键扫描、松键校准、音量目标、声谱观察、屏幕检测 |

清空 Loop 需要在同一选项再按一次 B；旋转离开会取消确认。首次录制仍可提前结束，此次实际长度作为后续各层的循环长度。

声谱观察与 PDF 使用全屏显示：声谱页维持 LIVE、32 峰、31 峰及缺口移动操作；PDF 页短按 B 退出。A 静音返回也会退出屏幕检测。未收到曲谱时，界面提示先从手机发送。

## 显示与交互原则

- 顶部键盘始终服务于曲目指引和实际按键反馈；下方左侧显示当前页状态，右侧最多六个选项。
- 深色背景、浅色文字、青绿色选择和琥珀色预告形成固定层级；已采用的音色／效果与光标位置分别表示。
- 音量目标、演奏／静音状态和效果不会因为进入另一页而被隐藏或改写。
- 新触屏转发按当前页点击对应菜单；与实体旋钮交叉操作时，过期的触摸命令会被拒绝，避免覆盖刚发生的静音或选择。

设计参考了 [Ableton Push 的设置与导航](https://www.ableton.com/en/push/manual/)、[Maschine+ 的分类浏览](https://docs.native-instruments.com/ni-tech-manuals/maschine-plus-manual/en/using-the-browser)、[Circuit Tracks 的混音和演奏视图](https://userguides.novationmusic.com/hc/en-gb/articles/26207162799506-Mixing-and-performing-on-your-Circuit-Tracks) 及 [OP-1 的模式组织](https://teenage.engineering/guides/op-1/original/main-modes)。本实现采用适合两只旋钮与 7 英寸屏幕的简短分类，未增加触屏硬件要求。

## 工程与验证入口

- `tools/generate_guide_panel.py`：生成屏幕 RTL、字形和字符串。
- `fpga/uart_control_display.v`：页面、选择、确认和兼容旧协议的控制器。
- `fpga/synth_display_top.v`：在帧边界同步菜单状态与其他显示数据。
- `tests/navigation/run.py`：真实控制器与 UART 输出的导航回归。
- `tests/guide_ui/run.py`：真实 RTL 图像和像素检查。
- `realtime_synth/host/test_navigation.py`：上位机协议、触摸命中与兼容性测试。
- `tools/check_hierarchical_ui.py`：新码流下载后的实板菜单回读；调用时需提供此前配置的原始包络和单通道选择，避免根据不完整状态猜测恢复值。

界面仍以流水线像素逻辑生成，字体使用三块 BSRAM，不使用整屏帧缓冲。构建、时序与实际资源以本版实现报告为准；仿真图像不等同于实屏拍照。

## 已验证版本

2026 年 11 月 3 日，Tang Mega 60K NEO 通过 JTAG 临时加载 `0x000090FB`，下载后读回同一 User Code。仅谱峰配置使用 47,305 / 59,904 Logic、25,075 / 60,780 寄存器、117 / 118 BSRAM 和 58.5 / 118 DSP。布局报告的系统 Fmax 为 50.012 MHz，像素为 51.456 MHz，USB 为 76.379 MHz，四个约束时钟域的建立与保持违例均为零。系统时钟目标为 50 MHz，后续修改需以新布局报告重新核验。

实板回读验证了五个分类的进入和返回、五种音色、五种效果、Loop 清空确认后的取消、四档指引速度、彩条退出以及声谱页进入和返回。上位机也通过真实串口从首页进入音色页，再静音返回。测试结束时，显示时钟锁定，J18 键盘在线，琴键扫描已校准，首页静音，风琴音色，琴键音量 32%。

七种屏幕状态在 RTL 仿真中各比较了 614,400 个像素，合计 4,300,800 像素一致。可查看[首页](tests/guide_ui/results/hierarchical/home.png)、[设置页](tests/guide_ui/results/hierarchical/settings.png)与[清空确认](tests/guide_ui/results/hierarchical/loop_confirm.png)。

原始 UART 的平面菜单命令仍可使用；新客户端通过 opcode 36 查询导航能力与页面，支持带操作序号的选择／执行校验，协议详见 `tests/navigation/README.md`。
