Lonelyrockroll/qiansai/现场验收.md

# v32 台上操作与赛题对照

用 Tang、HDMI 屏、实体琴板和插在 J18 的小键盘即可演示实时合成、表情效果和独立谱峰。手机只参与蓝牙扩展。准备阶段用 Gowin Programmer 对 SRAM 临时下载；板卡断电后需要重载。

## 三分钟脱机演示

以下入口对应当前分级菜单版 `0x000090FB`。旋转 B 选择，短按 B 确认，按住 B 旋转调音量。声谱观察位于「设置」中。[分级菜单说明](SCREEN-NAVIGATION.md)

1. 在「设置」中确认琴键扫描开启，全部松开琴键并选择「松键校准」，返回首页选择「开始演奏」。同音量轻、重弹 C4，再弹 C4/E4/G4 和弦。保持 C4 弹奏风琴，用 A 转动滑音、按住 A 转动调颤音。钢琴保留自然音高。效果菜单可切到混响、延迟或合唱。
2. 用 B 进入「设置 → 声谱观察」，短按进入 LIVE，再弹琴。当前仅谱峰配置保留板上频谱和起音计时，详细波形与 XY 图可在电脑上查看。孤立触键时，`LAST I2S` 显示 FPGA 接受该键事件至 I²S 完整首个非零左字的微秒数。结合物理键号和测量次数判断是否为本次触键的新读数。历史完整版的相图以同一单声道的当前样本和 16 个采样之前的样本为两轴。
3. 在观察页短按 B。若正在录或播放 Loop，屏幕会提示先停止 Loop；普通琴键留下的尾音由板卡淡出并清理，再开始测试。板卡自行配置 32 个独立正弦声部。64 个频点间距约 47.684 Hz，奇数频点发声，间隔的偶数频点留出谷。看屏上的 **PEAKS 32**；再短按 B 关闭一路，看到 **PEAKS 31**。转 B 移动缺峰，旧峰恢复、新位置变空。短按 A 静音退出。板上 KEY.1 可向前选择，KEY.0 可执行，长按 KEY.0 静音。
4. 演示屏幕节奏指引时，用内置短句即可脱离手机。手机扩展可演示 HTTPS 下载 MIDI/PDF、蓝牙上传、白键音高交换和录音回传。默认 H1～H32 仍为 C2～F6；交换的是物理键的两个音高，调好后可以断开手机演奏。

观察页会自动调整显示增益。比较轻重触键的绝对幅度时，使用同一面板音量下的 J9 电平条或固定量程的 PCM／模拟输出。观察页适用于上述 32 音验收和演奏反馈。64 个频点覆盖约 48～3052 Hz，峰高采用相对刻度，普通乐音的谐波和窗泄漏也会形成峰。C4 钢琴高次分量超过这一频段，单音 32 分量应查原先更宽带的逐峰测量。

## 逐项对照

| 赛题项 | 已有与新增 | 如何验收／边界 |
|---|---|---|
| 基础 1，多维交互 | 自研 32 键霍尔扫描采选音、触发和相对击键速度。已修正低音量下的速度过早饱和以及 H15 长按重复发出起音的问题，后者已通过布局后仿真 | 固定 C4 改变击键速度，再改弹不同白键和和弦。长按 H15 时同时检查物理门控计数，见下方复测步骤。力度是相对起音速度 |
| 基础 2，纯硬件合成与 10 ms | HDL 按样本生成音频，标准 I²S 在 J8，板载 PT8211 接收同一音乐样本的另一串行格式。新增板内事件至 I²S 计时与 MARK | 预热数字段、冷功放、机械动作分别记录。模拟与声学全链路仍需同步实测。参见[分段测量方案](赛题二问答与验收测量.md) |
| 基础 3，至少四复音、合规发声 | 32 旋律声部，独立音高、包络和混音；钢琴为实时加法合成，鼓组实时生成，Loop 重放事件 | 现场听四音和弦并查路由、相位、包络和输出 RTL。PCM 采集、蓝牙录音属于由板到手机的输出路径 |
| 拓展 1，并行吞吐 | 可用 32 声部路线，也有钢琴单音 32 分量路线 | 32 音模式逐路关峰。32 × 48,828.125 = 1,562,500 声部采样/秒。实际 LRCLK 可另用仪器测，四子帧不倍增吞吐量 |
| 拓展 2，表情与效果 | 力度、滑音、颤音，五种旋律音色，HDL 混响/延迟/合唱 | 保持音色分别操作三个维度。ADSR 参数在 HDL 可调，已有参数通路；脱机菜单主要使用音色预设，没有四个独立 ADSR 旋钮 |
| 拓展 3，5 ms 与视听反馈 | 本地真实 PCM 波形、窄带频谱、延时相图、音频电平条、ONSET 时间 | 数字段分工况对照 5 ms。异步琴键输入存在扫描相位差，整机零抖动和手指到声学起音 ≤5 ms 未作认定 |
| 拓展 4，手机与脱机指引 | 屏幕 32 白键跟拍；App 支持在线曲谱下载、MIDI、PDF、录音和白键互换 | 已按项目约定使用屏幕琴键，实体 32 颗导引灯未验收。机内缓存一页 PDF，换页仍需连接手机；v31 示例页实测约 46～47 秒 |
| 核心评分，数量与样本率 | 测试音全部经同一真实声部引擎，逐路频率可控，走一个输出；可对比 FPGA 频谱与读回 PCM 的独立 FFT | 峰数不是普通波表的谐波计数，不把结构上限或静音声部计为同时可闻。资料与证据分开标注 RTL、仿真、实板数字读回和现场听感 |

主要证据入口：[延迟与力度](tests/contest_latency/README.md)、[板屏分析器](tests/monitor/README.md)、[键位协议](tests/contest_keys/results/validation.json)、[安卓下载与兼容性](realtime_synth/android_recorder/contest_validation.json)、[钢琴实测 32 分量](realtime_synth/throughput_eval/experiments/modal32/musical/README.md)。

## 整机与实板结果

最终完整版 `0x0000365B` 已通过 SRAM 下载和 JTAG 回读。在预热、其他琴键松开的条件下，实物单按 H15 / C4 并松开一次，物理计数增加 **1 次 ON、1 次 OFF**，测量计数增加 1，恢复清理增加 0 次。`LAST I2S` 保留 **88 µs**。这一次覆盖 FPGA 接受琴键事件到标准 I²S 首个完整非零左声道字；霍尔至 J25、动作至麦克风仍需同步测量。[实板记录](tests/contest_board/onset_board.json)

同一码流以最终 PCM 依次测得 32 峰、31 峰和移动缺口后的 31 峰。在 4,096 点独立 FFT 中，第 16、17 音分别衰减 71.4 dB、81.0 dB，各试验仍保留的目标峰幅度变化小于 0.04%。这三个片段及原始频点表可直接用于现场对照。[实板数字频谱](tests/contest_board/spectrum.json) · [FFT 表](tests/contest_board/fft.csv)

初版 F939 在连续约 5 秒的 74 次读取中，琴键掩码均为零，但路由仍有 3 个现场保持声部。观察页短按 B 受此状态阻挡。旧计时寄存器保存了 107 µs，但有效标志已清，不能归到某次具体的 C4 动作。[初版空闲记录](tests/contest_board/intermediate-F939/idle_probe.json)

中间版 **C69B** 记录了 H15（默认 C4）的一次有效孤立起音。FPGA 接受物理 Note On 到完整首个非零标准 I²S 左字为 **93 µs**，测量次数为 1，读数随后保留。另一个计数器在一次约 0.9 秒的长按及松开过程中累计了 **962 个 ON、1 个 OFF**。前者证明该次 FPGA 数字段延迟，后者揭示长按重复触发，两项应分开报告。[C69B 实板读数与端点](tests/contest_board/intermediate-C69B/onset_board.json) · [门控时间记录](tests/contest_board/intermediate-C69B/local_controls.json)

在同工具、同器件的独立扫描器工程中，给 H15 单次稳定输入并保持 32 轮扫描。原写法在行为 RTL 得到 1 ON / 1 OFF，布局后的 `.vo` 得到 16 ON / 0 OFF，H15 已按位有 16 轮错误清零。修复后按握手更新整个 32 位按键掩码，RTL 和 `.vo` 均为 **1 ON / 1 OFF**，H15 的按下位在 32 轮中均为 1。该结果在独立扫描器门级复现了同类重复触发。上文记录了最终码流在实物 H15 上的单次复测。[H15 门级对照](tests/contest_latency/results/gate_hold/validation.json)

**现场复测 H15。** 进入 LIVE，松键校准并预热，等待无尾音，记下物理 ON/OFF 和 `LAST I2S` 完成次数的起始值。只按住 H15 约一秒，预期 ON 增加 1、OFF 不变；松开后 OFF 增加 1，按键和现场持有声部最终归零。孤立起音应留下物理 H15 和一次新的完成记录。按和弦时保留最近的孤立读数，不把保留值当作和弦的新测量。

恢复机制覆盖两个完整的全松扫描后，在路由可接收时只清理现场残留。仿真注入 3 个残留，只触发 1 次恢复，持续的 Loop 音保留，回放继续处理 154 个事件；696 个实体门控在非恒等音高映射和背压下逐一匹配。切入 32 音可处理已有尾音，仍应先结束正在录制、待录或播放的 Loop。[恢复回归](tests/contest_latency/results/recovery.json)

## 还有哪些值得补

优先补实物证据。用同一时基测霍尔越阈值到 J25 模拟起音，另测动作参考到麦克风，再按相位和力度统计分布。板内时标与 RTL 仿真无法代替这一组实验。需要实际 LRCLK 频率时，在 J8-12 量完整周期。

软件后续可分别扩展观察页的频带、脱机单独设置 ADSR 四个数值，以及给蓝牙 PDF 传页采用更大的数据块。现有窄带观察页适配 32 路现场谱峰试验，原来的 C4 高次分量证据用较宽带 PCM 分析；PDF 换页速度仍是已有验收速度。若要进一步减小扫描与音频帧之间的相位漂移，可试验整帧同步的扫描周期，并同时比较跨阈值的最大等待时间。物理实体键的 LED 指引按之前约定未安排，需要将其与已完成的屏幕指引分开申报。
