Lonelyrockroll/qiansai/资源与电脑分析.md

# 板屏和电脑观察工具怎样选

完整版在 FPGA 屏上同时显示实时波形、64 频点频谱和单声道延时 XY。仅谱峰版把整个屏幕留给真实的频谱柱、峰数和 LAST I2S 计时，详细波形与 XY 可用电脑观察。两种配置均能脱离电脑完成 32 音、关一路、移动缺峰的现场演示。

## 当前整机布局

两份 v32 报告基于同一个修复后的琴键扫描器，67 个实际构建输入只差 `audio_monitor.v`，器件、引脚与时钟约束一致。完整版采用布局选项 2，仅谱峰版采用选项 1。下表比较已经通过完整时序与引脚校验的两个实际码流。

| 布局指标 | v31 基线（0x000063B5） | v32 完整版（0x0000365B） | v32 仅谱峰版（0x00005463） |
|---|---:|---:|---:|
| Logic / 59,904 | 43,538 | 49,259 | 47,038 |
| 寄存器 / 60,780 | 22,669 | 26,014 | 24,986 |
| 物理 BSRAM / 118 | 116 | 118 | 117 |
| DSP / 118 | 54.5 | 57 | 57 |
| 系统 Fmax（目标 50 MHz） | 50.014 MHz | 50.006 MHz | 50.068 MHz |
| 像素 Fmax（目标 49 MHz） | 58.580 MHz | 49.788 MHz | 49.745 MHz |
| USB Fmax（目标 60 MHz） | 80.289 MHz | 60.105 MHz | 74.008 MHz |

仅谱峰版净省 2,221 个物理 Logic、1,028 个寄存器和 1 块物理 BSRAM。全芯片 Logic 用量从 82.23% 变为 78.52%，相差 3.71 个百分点。两份的 DSP 用量均为 57。这个净差额包含不同布局选项的映射结果，各模块自身的综合规模另列在下一表。全部约束时钟域的 setup/hold 均通过。两者仍保留 PR1014 时钟布线提示，系统时钟裕量较小。

希望三种图都在板上展示时，选完整版。确实需要多一块片上 RAM，或现场主要演示 32/31 峰时，可以选仅谱峰版。两版使用相同的音源和采样时钟配置。完整版已实测采样帧计数。把细图移到电脑可以释放显示资源，音源吞吐量保持相同的设计值。

## 模块综合明细

以下是相同整机综合层级的 LUT / FF / 逻辑 BSRAM。观察模块合计包含其 DFT、渲染器和直接逻辑等子项，这些行不能再叠加。综合 LUT 与全机物理 Logic 采用不同统计口径。

| 层级 | 完整版 | 仅谱峰版 |
|---|---:|---:|
| 观察模块合计 | 2,944 / 2,780 / 1 | 1,375 / 1,753 / 0 |
| 子项 · 64 频点 DFT | 408 / 871 / 0 | 393 / 870 / 0 |
| 子项 · 像素与文字渲染 | 1,054 / 159 / 0 | 878 / 148 / 0 |
| 子项 · 采样、量程、图形存储等直接逻辑 | 1,482 / 1,750 / 1 | 101 / 29 / 0 |
| 子项 · 仅谱峰版的帧快照 | 无此层级 | 3 / 706 / 0 |
| 独立 I2S 起音计时器 | 41 / 89 / 0 | 37 / 89 / 0 |
| 32 路测试音调度器 | 111 / 104 / 0 | 111 / 104 / 0 |
| 工程 PCM / PDF 共享采集模块 | 323 / 203 / 32 | 308 / 203 / 32 |

两版 DFT 都使用 56 个分布式 RAM 原语和 1 个 MULT12X12；渲染层另使用 2 个 MULT12X12。64 个频点是对实际 PCM 的测量，不能计入独立发声振荡器数量。完整版观察图使用一段 512×16 位双银行显示 RAM，占观察模块中 1 个逻辑 BSRAM；仅谱峰版通过 350 位状态快照更新，不分配该显示 RAM。

原有 PDF 与工程 PCM 抓取共用 32768×16 位（64 KiB）缓存，两种配置都保留这 32 个逻辑 BSRAM。Bluetooth 演奏录音有独立缓存。仅谱峰版释放的块数不足以再放一页 64 KiB 曲谱。

## 电脑入口

在 `realtime_synth/host` 启动 `python server.py --port 8767`，浏览器打开 `http://127.0.0.1:8767/audio-monitor`。

- **电脑音频输入**需要先选择设备并主动开始。例如用声卡接板卡耳机输出，再在网页选声卡输入。电脑按自己的实际采样率实时显示波形、频谱和延时 XY。
- **文件或板测示例**用于分析已录到的数据。例如 C4 的第 32 分量约 8.37 kHz，超过板上频谱约 3.05 kHz 的上限，可用全带宽 PCM 频谱查看。
- **工程数字 PCM 抓取**在板内截取一段最终样本，读回后可以查峰表、CRC 和全带宽频谱。这些是快照，和连续声卡监听分别标注。

电脑的分析图是独立验证材料。现场要证明 FPGA 自己生成了谱峰或图形，使用对应板上模式和 RTL。LAST I2S 记录 FPGA 接受孤立琴键事件至移出首个非零 I2S 左声道字的时间。要包含传感扫描或模拟输出，请另外做同步测量。频谱窗和电脑声卡缓冲影响图像更新时间。

## 历史与证据

上表 v32 使用修复按住 H15 重复触发后的扫描器。旧的 `0x0000F939` 是双银行观察页首版；`0x0000C69B` 与 `0x00005A96` 是本次扫描修复前的一对完整/仅谱峰候选，不能代替上表当前两份码流的指标。v31 基线来自当时的曲谱整机布局。
观察页的实际 RGB 仿真、分频点测试和 PC 工具复现步骤见工程测试目录。实板试听、谱峰及起音证据应按所运行的具体固件记录。
