Lonelyrockroll/qiansai/赛题二问答与验收测量.md

# 选题二现场验收与测量

核对的是 2026-11-02 更新的 `技术问题.xlsx`，以 Sheet1 的 A 列编号为准。**第 115 条在第 71 行，问题为 B71，回答为 C71。** 赛题截图给出基础 ≤10 ms、拓展 ≤5 ms。答疑要求先做好 FPGA 内部处理，对外设和音频后端尚没有可确认的统一计时口径。答复建议分段测量，没有指定必须使用某一种仪器，也没有承诺外部延迟可以排除在外。

第 115 条引用的 TTP229 约 16 ms、有效按键到 I²S 约 3.4 ms 都是提问者举的例子。本机用霍尔琴键、模拟多路选择器和 ADC，应测自己的数据。第 95、103 条早先也谈到全链路和示波器/高速相机，第 119 条第一问直接指回 115。第 103 条所举往届 384 kHz 测量经历同样不是本机采样率。

## 延迟怎样测

本机的信号顺序如下。标准 I²S 引出与板载 PT8211 收到的是同一音乐样本的两路并行串行输出。

```text
手指/键程 → 霍尔电压越阈值 → 多路扫描与 ADC → FPGA 接受 note-on → 最终 PCM
                                                           ├→ 标准 I²S 排针
                                                           └→ PT8211 → 模拟音频 → 扬声器
```

建议记录以下时刻。每一对端点要在同一时基上采集；没有共同标记的两次实验不能作为同一次触键的精确总延迟。

| 区段 | 起点 → 终点 | 怎么取证 | 它回答什么问题 |
|---|---|---|---|
| 机械动作和前端 | 约定键程位置的光电标记或可见动作 → 指定霍尔键的模拟输出越过校准后的按下阈值 | 示波器同时采两路，或用有明确帧率、同画面带参考灯的慢动作相机 | 传感器前端和机构响应。只拍到手指接触时，要说明接触与磁铁到达触发位置的差异 |
| 采集与识别 | 同一霍尔键越阈值 → FPGA 接受该键 note-on 事件 | 示波器 CH1 探测**该键自身**相对键盘 GND 的霍尔输出，CH2 接事件标记；可另用逻辑分析仪观察地址、转换、事件。轮询后的复用器输出不能直接代替某一键连续的原始电压 | 包括等待轮到该键、转换、阈值判断和事件握手。运动是异步的，扫过该键之前与之后起音会不同 |
| FPGA 数字处理 | 接受有效 note-on → 标准 I²S 首个非零左声道 PCM 字的最后一位被采样 | 板内计数显示；独立核验可用逻辑分析仪采事件标记、BCLK、LRCLK、DATA，按标准 I²S 的一位延迟解码。BCLK 和 LRCLK 在静音时也会跳，不能用“第一次出现时钟”作为起音 | 可与 5/10 ms 分项比较。首个非零字与明显可听的起音是两种端点 |
| 电气输出 | 霍尔越阈值 → DAC/功放的模拟音频开始 | 示波器同一次触发采 CH1 霍尔信号和 CH2 模拟输出。取已确认共地的耳机/线路输出的一侧与地；若测差分/桥接扬声器端，使用合适的差分测量，不将任一扬声器端当作地 | 给出“传感器电信号到模拟输出”的全段结果 |
| 实际发声 | 同一机械参考标记 → 固定位置麦克风信号起音 | 同步采机械标记与麦克风输出，记录麦克风距离及采集设备。慢动作视频可辅助展示手感；240 fps 的单帧已约 4.17 ms，不适合单独证明 5 ms | 包含 DAC、功放、扬声器、声传播及拾音，判读时说明这些因素 |

**建议实验条件。** 固定音色、音量、音高和阈值，从空闲且无尾音状态弹单音。预先“开始演奏”的热机状态与从硬件静音唤醒分开记录。关闭效果先测干声，再按需测演奏预设。给模拟起音规定高于静音噪声的阈值并注明连续满足多久，保持每次标准相同。每种状态建议多次（例如 30 次）记录最小、中位、最大以及最大减最小；这是本项目的实验方法，不是题目规定的次数或合格容差。原始波形、采样率、探头位置和起音阈值一起保存。固定的采样周期不等于任意时刻触键到声音的延迟没有变化。

用信号源阶跃代替琴键时，应记录实际输入电压跨阈值的时刻，并把结果标为“替代电信号至输出”。这项实验不含机械键程和真实霍尔响应，不要把信号源直接并到仍在驱动该节点的传感器输出。

## 这块 NEO 31004 的测点

J8 是 KEY.0 与 POWER 之间的 PMOD 插座；旁边 KEY.1 与 KEY.0 之间的 J9 是八灯板所用插座。以下针号按板上 1 脚方向数，取自 31004 rev1.4 底板原理图第 7 页和第 19 页。探测 J8 时保留 J9 灯板接线。逻辑分析仪按 3.3 V 逻辑采集。

| J8 脚 | FPGA 管脚 | 信号／用途 |
|---|---|---|
| 11 | Y21 | 标准 I²S BCLK |
| 12 | Y22 | 标准 I²S LRCLK，取完整左右帧的周期 |
| 9 | AB21 | 标准 I²S DATA |
| 10 | AB22 | v32 在实时声谱观察页的 LIVE 状态输出 MARK，上升沿是接收孤立琴键事件，下降沿是解码到首个非零左字完成后的下一拍；显示值以微秒取整。只有完成有效测量并更新次数时，才将这个脉冲当作有效样本。其他页面及 32/31 音测试状态仍输出采样节拍 |
| 3 或 4 | GND | 数字测量参考地 |

测 FPGA 段最简方法是在 LIVE 页预热后弹一个单音，用示波器量 J8-10 高脉宽。要独立复核其终点，用逻辑分析仪同时采 J8-10/11/12/9，解码第一个有效非零左字并与标记末沿比较。测从数字事件到真实模拟输出则用 CH1=J8-10 上升沿、CH2=耳机左声道；这一次包括后端输出延迟，但起点仍在 FPGA 内。

若要单独量板载 DAC/功放的延迟，取 PT8211 实际锁存相应样本的时刻和 J25 模拟起音为端点。J8 的标准 I²S 与板载 PT8211 使用不同引脚和帧格式。

底板原理图第 10 页的 J25 是 CTIA 耳机口。用分线器取 tip（左）或 ring1（右），以 ring2（GNDA）为参考。J27/J28 扬声器端是桥接输出，两根线都是功放输出，不能按耳机的接法把其中一根接示波器地。标准 I²S 的采样边沿和一位延迟见 [NXP UM11732](https://www.nxp.com/docs/en/user-manual/UM11732.pdf)。

115 没有确认基础和拓展采用不同的计时边界。本项目用相同端点列出与 10 ms、5 ms 的比较，避免因改变端点得到两个看似矛盾的结论。

## 哪些项目需要仪器

| 验收项目 | 首选现场展示 | 仪器或补充材料 |
|---|---|---|
| 4 路／32 路独立发声、吞吐量 | 板屏看实际输出的谱峰；单独释放一路，确认对应峰消失且其他峰仍在 | 选用频谱仪、示波器 FFT 或多通道声卡作独立复核。谱峰数本身不能区分独立发声与一个波形的谐波，要配合独立相位、频率、包络、单路操作的 RTL 和对照实验 |
| 实际采样率、I²S | 展示标准 I²S 引出和实时生成通路 | 示波器/逻辑分析仪测标准 I²S LRCLK 的完整周期，每周期一个立体声帧；再核对 BCLK 和 DATA。设计值 50 MHz/1024 = 48,828.125 帧/秒。板载 PT8211 走自己的串行格式，两路取相同的音乐样本。PT 四子帧、左右声道、ADC 轮询和频谱窗口数都不叠加计分 |
| 力度、滑音、颤音、多音色、ADSR、混音与效果 | 同音量轻弹/重弹，同一持续音转旋钮，切音色和效果，听并看实测波形/频谱 | 可用 PCM、模拟输出或频谱复核强弱、频率摆幅和衰减。霍尔位移变化估计的是相对触键速度；不把它标成标定过的力值 |
| 脱机节奏指引、蓝牙传谱、键位设置、录音 | 实体键、板屏、手机直接操作 | 无需示波器。按现有产品约定只做屏幕 32 白键指引；明确标作屏幕演示，不能写成实体琴键 LED 灯链已通过 |
| 纯 FPGA 合成、真实并行 | 指认扫描、路由、逐声部相位/包络、混音、I²S 代码，并展示采样期限和有源声部数 | 声音示波图不能单独证明没有预录 PCM。查看源代码和录音回传方向；波表和振荡器系数用于实时计算 |

观察页的频谱窗为 1024 个音乐样本（约 20.97 ms），随后还要等 HDMI 刷新。不能拿“看见谱柱出现的时间”去判定 5/10 ms 音频指标；ONSET 数值来自独立事件计数器。已有声部发声时，混音本来就非零，测某个新音符要另选可区分的内部事件或声部输出。

板屏使用自动显示增益，适合判断频率和形状。力度大小可看 J9 随最终 PCM 变化的电平条，或比较同一量程的输出。数字采集先解码 DATA 得到 PCM 再做频谱分析。

若用独立仪器复核谱峰，可以把示波器 FFT 输入接 J25 的一个耳机声道对 GNDA。保持测试音稳定，取例如 100 ms 的记录（频率栅格约 10 Hz），观察约 0～3.1 kHz。32 路正弦的目标频率为 (2k+1) × 47.6837 Hz，k=0～31。关掉第 16 路时约 1.478 kHz 处应下降，再移到第 17 路时约 1.574 kHz 处应下降。峰位与其他峰的稳定性一起看。

按 32 个实际同时发声的独立正弦声部和设计帧率计算，吞吐量是 **1,562,500 声部采样/秒**。帧率要用 LRCLK 对应实测补证。钢琴单音 32 分量是另一项已有证据，不能据 32×32 的结构上限直接申报 1024 个同时活跃可闻的单元。

## 新增答疑对项目的影响

| 编号（行） | 回答与项目决定 |
|---|---|
| 108、109（64、65） | 108 的回答带“我记得应该”限定，提到振荡器数量或 32 声部；109 与 101、102 一致，认可同一音频采样周期内的时分复用。比赛展示分别报告真实声部、加法分量及采样率。89 的 FM 调制器问题在新版仍空白。 |
| 110、122（66、78） | 一个输出通道可以展示多路频率，不要求多路 I²S。建议板载发声并引出标准 I²S；对引出后接 MAX98357 的问法答复为可以。87、100 也建议保留 I²S。 |
| 111、113、114（67、69、70） | 允许带 HDMI 驱动板的显示屏，138K Pro Dock 可选，拨弦在答复中倾向解释为触发声音。本项目仍使用 Tang Mega 60K NEO。 |
| 115、119（71、75） | 分段记录延迟；119 对 MIDI 键盘自带力度能否作为维度回答“算”。97 亦表示独立可控维度不要求不同传感原理。 |
| 116、117、118（72～74） | 116 建议以实际能否听出音色选外接音响，117 允许外接琴键。118 关于成品采集方案没有填写回答，不能从中推出所有成品工作量都可计分。 |
| 124、126、129、130（80、82、85、86） | 手机通信不限蓝牙；本项目保留已经验收的蓝牙。126 没有提供消除 PR1014 的通用修复办法，仍需核对本机 STA 和实板。129 允许电脑 USB 供电，这与是否依赖电脑参与演奏是两件事。130 对延迟不敏感的配置和切换，答复认为可用触屏或电脑配置。 |

本表整理的是项目实际采用的证据口径。新增答复优先补充旧整理中仍待确认的内容，不把个人建议写成赛事统一认证标准。

## 实物波形的离线整理工具

示波器将同一次动作的两路电压导出到同一 CSV 后，可用 [analyze_onset_csv.py](tools/analyze_onset_csv.py) 批量计算，具体命令见[测量说明](tests/contest_latency/README.md)。明确指定时间单位、预触发基线、霍尔信号的方向和电压阈值、模拟输出阈值及连续确认点数。一份 CSV 对应一次按键，报告逐次起止、采样量化区间和有效组的最小、中位、最大、峰峰值。未触发、缺列或背景音先起等失败会保留原因，不会作为零延迟计入。项目附带 CSV 仅是分析工具的合成自测，不能作为乐器的实测结果。

## 当前工程的数字证据

对正式 RTL 的 18 组预热工况，SAR 的转换以 20 个时钟的行为模型代替。电子信号过按下阈值至完整首个非零 I²S 字最长 0.668730 ms；至首个幅值至少 16 码的完整字最长 0.975930 ms。C4 在不同扫描相位的首字结果为 0.085350～0.562130 ms，重复同相位可再现。另一次校准完成后同时启动功放和 C4 阶跃，首个非零字在 3.049810 ms，达到 16 码在 3.950930 ms。最慢的测试斜坡从“开始移动”计至达到 16 码为 7.127110 ms。起点改变会改变判定，这些数字不能填到“手指到实际扬声器”的实测栏。

v32 显示 LAST I2S，表示最近一次已完成的孤立起音。后续和弦不会擦除这个值；工程读回包含物理键号和测量次数。记录时核对次数确有增加。

19 个仿真工况中，板内 MARK 与独立串行解码器找到同一有效左字，标记末沿晚一个 50 MHz 时钟（20 ns），屏幕取整误差最大 0.940 µs。7% 音量下轻/中/重 C4 正弦的 I²S 峰值分别为 170/334/678 数字码，在 25% 下为 606/1192/2421 数字码。复现方法、输入设定及原始工况见项目的 tests/contest_latency/。

## H15 的门控与计时要分别验收

中间版 C69B 的 `LAST I2S` 在 H15（默认 C4）上记录 **93 µs**，物理键号为 14（从零计），完成次数为 1。这是 FPGA 接受 Note On 到标准 I²S 完整首个非零左字的板内测量。动作到霍尔越阈值、等候扫描，以及 DAC/功放到实际发声的时间需分别测量。同一次约 0.9 秒的长按及松开过程中，物理门控累计 **962 ON / 1 OFF**。完成次数统计能够归属到单一按键的起音，ON/OFF 差值用于检查长按期间有无重复触发。[C69B 历史实板记录](tests/contest_board/intermediate-C69B/onset_board.json) · [逐次读取](tests/contest_board/intermediate-C69B/local_controls.json)

门级对照固定 50 MHz、原扫描参数和完整的 16 轮校准。ADC 行为模型对 H15 只施加一次 4000→4720→4000 码的变化，在 4720 码保持 32 个完整扫描（15.38048 ms）。原 RTL 为 1 ON / 1 OFF；同一原扫描器经 Gowin Education 1.9.11.03 独立布局后的 `.vo` 为 16 ON / 0 OFF。查表可见，在 H15 已按、位移仍为 720 码时，原触发器在判定状态会写入零。修复后的已按掩码只在事件握手时按 one-hot 选择整字置位或清位，感知掩码单独维护迟滞。修复后的 RTL 与 `.vo` 均为 **1 ON / 1 OFF**，持键 32 轮没有错误清位。[独立工程门级记录](tests/contest_latency/results/gate_hold/validation.json)

最终完整版 `0x0000365B` 已通过 SRAM 下载和 JTAG 回读。在预热、其他琴键松开的条件下，实物单按 H15 / C4 并松开一次，物理计数增加 **1 次 ON、1 次 OFF**，测量计数增加 1，恢复清理增加 0 次。`LAST I2S` 保留 **88 µs**。这一次覆盖 FPGA 接受琴键事件到标准 I²S 首个完整非零左声道字；霍尔至 J25、动作至麦克风仍需同步测量。[本次实板起音和计数](tests/contest_board/onset_board.json)

## 原表索引和原答

含直接相关题目以及板卡、通用规则的补充条目。来源工作簿 SHA256 为 `daf7ec76eef2d75ae481c93ebfc9171cf7ee59e106c1f98c03dbd6907b528fbb`。空白回答保持空白状态。

### A1（Sheet1!B28:C28）

只能用对应赛题的推荐板卡吗？

> 推荐板卡只是技术上的推荐， 实际上你可以使用任意的、高云FPGA为主芯片的板卡参赛（sipeed,小梅哥,易思达,嘉立创等都可以）。并且不会影响评分。该条目适用于选题包括选题一的所有选题； 同理，选题三的“边缘计算平台”，佬们也可以自己选择自己的板子， 树莓派、rk3588、3568，jetson，甚至你直接插一块5090说不定都行。

### A2（Sheet1!B29:C29）

关于在作品/成品模块中的MCU、软核

> 1. 使用MCU的部分可能不会计入你的工作量，无论是成品还是自制的部分。
> 2. 只要不是绝大部分功能都采用软核、MCU，就不会导致棋赛。
> 3. 选题二的音频、视觉效果部分根据要求绝对不要用软核/MCU。否则可能不会计入工作量。
> 5. 此处“不能用软核”的软核指的是通用的CPU/MCU软核如M1软核（俗话说是跑C语言的那种。）根据具体算法需求专门设计的状态机或者串行架构的算法加速器不是软核。这体现了FPGA的不可替代性。当然你用那种内置的Risc-V CPU硬核的情况也比较类似于软核。
> 6. “可能不会计入工作量”： ① 不会因为你的某个功能模块MCU了就直接给你整个模块不计入工作量，比如你的某个模块使用MCU进行1%的功能，那么不会影响剩余99%部分的工作量计算。 ②如果评委认为你的这部分MCU/软核应用的比较合理， 可能根据实际情况打折或正常计入你的工作量。 ③ 不计入工作量指的不是从总分扣分，应该理解为对这部分功能的设计和实现的分数造成的间接性影响。
> 7. 考虑对于实时性的影响。今年三道题对于实时性都有比较高的要求。

### 76（Sheet1!B33:C33）

赛题二 音频包络必须为ADSR包络吗

> 命题相对灵活，应该不是定死的

### 80（Sheet1!B34:C34）

如果成功到申请选题2的推荐板卡，是否会包含配套TANG MEGA NEO底板，以及供电和下载调试所需配件，甚至是音频输出与传感器扩展接口。还是就单单一张核心板

> 至少底板肯定会有，音频输出应该有板载的。 外设和传感器得你自己准备了。

### 84（Sheet1!B40:C40）

赛题二我用DDS IP 生成四个通道正弦波算不算独立

> 无法具体断定， 建议详细阅读赛题并且根据自己实际设计确定。最终应该还是比较注重于整体效果；是否合规应该是说得通即可，但是评分肯定得看效果了。

### 86（Sheet1!B42:C42）

mega60k的官方pinout和资料里提供的dock原理图是不是有冲突？dock里面写r17是属于bank8，pinout里写的是bank6，以哪个为准

> （等我回去看看）， 实际上你可以让AI帮你看看高云的资料， 应该按照官方资料为准。

### 87（Sheet1!B43:C43）

Sipeed的Mega底板集成了I2S功放功能，赛题2是否强制要求FPGA向外输出I2S流？如果自制底板，是否允许FPGA以其他协议向外输出音频流？

> 用I2S不好嘛？ 实际上你来问问题的时间你已经把向外输出I2S的功能用AI或手动实现了。 我的建议是最好留一个。

### 89（Sheet1!B45:C45）

赛题2的FM 合成中，调制器是否同时计入同时活跃可闻独立振荡器总数

原表未填写回答。

### 90（Sheet1!B46:C46）

赛题二 使用IP核算不算基于 HDL 实现。哪些可用、哪些不可用。

> 看 “关于在作品/成品模块中的MCU、软核”。此处不能用软核指的是禁止使用软件通用CPU核心进行处理，而不是不让用IP核。

### 91（Sheet1!B47:C47）

选题2 可以通过串口屏进行参数调节和模式选择吗，不在音频和视觉方面使用mcu，会不会算用了mcu扣分

> 我觉得这点理论上是没问题的， 往届国赛也有很多串口屏被应用。佬们可以根据自己的工程设计决定。 当然如果你发现了不使用串口屏而是纯FPGA进行的参数设置和模式调节的方案那就更好了。

### 92（Sheet1!B48:C48）

mega60k 我搞了测试程序有时候同时按下key0 1 2核心板会断电有时候不会断电是为啥是程序问题还是推荐换一下供电方式

> 这种问题可能比较具体、复杂，建议查看大猪蹄子技术博客或者在群里找在线佬实时交流

### 95（Sheet1!B51:C51）

选题2中控制信号到音频输出总延迟小于10ms，这里延迟是否包含除FPGA外的电路，比如电容检测芯片

> 很可能是包含的，理论上应该是全链路的延迟。不过实际执行的时候有可能会有所宽限。 当然如果光是FPGA里面的延迟都比这个大就等着棋赛吧。

### 97（Sheet1!B53:C53）

机械琴键开关负责选音/触发，独立 FSR 压力垫实时控制已发声部的力度，这是否算两个独立可控演奏维度？是否要求两种不同的传感器原理？

> 算的，不要求必须使用不同的传感器原理。

### 98（Sheet1!B54:C54）

赛题二，可不可以一部分功能用stm32实现，一部分功能用fpga的20k板子实现，或者说，信号先经过stm32进行处理，再输入fpga完成后续处理

> 简单的功能也能用FPGA简单的实现，特别是简单的功能你哪怕是让AI给你实现也比用MCU强。 如果是性能不足那最好增加配置。 如果是钱包不允许那就做优化仙人或者按你说的用MCU，到时候印象分不佳或者延迟做不好高云变成高ping战士就棋赛了

### 100（Sheet1!B56:C56）

赛题二最后一步FPGA输出音频直接用60k的板载PT8211模块可以吗？算不算违反标准i²s输出再外接DAC模块这个赛题要求

> 应该是不违规的， 但是最好在用GPIO引出一个I2S可能更安全一些，反正就是一句话交给AI的事

### 101（Sheet1!B57:C57）

选题二，在一个音频采样周期（如48kHz，20.8μs）内，通过高速时钟轮询完成128个算子的计算并累加混音输出，是否算“128个振荡器同时活跃”？还是要求物理电路完全并行？

> 这样是可以的，这体现你的仙人级别优化水平；FPGA的运行频率显然远高于音频的采样率。按照音频的采样率跑FPGA这是把FPGA当红石电路耍。

### 102（Sheet1!B58:C58）

选题二，在Tang Nano 20K/Primer 25K等资源有限的板卡上，全并行无法综合。是否允许采用“分组并行+组内分时复用”方案达成拓展要求？

> 复用！狠狠复用！ 复用是正确的，这体现你的仙人级别优化水平

### 103（Sheet1!B59:C59）

选题2，请问这个时间延迟到时候是有什么具体的测量方法吗，自己如果要验证延迟时间的话有什么方法

> 规则没说就是不明确：我也不知道。 说实话这个标准我也觉得有些迷。最终很可能就会不会测，或者说如果你能够证明出来的话应该分数会更高一些。 比如你可以使用高速相机、示波器+传感器等方式进行证明。
> 我给大家举个例子。 我前年参加高云杯做音频题当时扩展部分要求采样率最高1536K或768K更h好。我使用示波器采集LRCK和模拟输出，通过体现能够处理384K左右的正弦音频证明采样率的指标。 虽然这还是不够直观，但是显然比单纯念指标好得多。 也就是说，低延迟的体现方式甚至也可以是创新的一部分。

### 104（Sheet1!B60:C60）

选题2，题目中评分标准对过采样的定义是什么？对波表实时插值属于过采样吗？

> 这种实时插值的情况可能处于算和不算之间，如果你的算法优化的很精妙可能反而加分；除此之外这个竞赛还是更加倾向于实际效果， 到时候评分还是按照具体效果为准

### 106（Sheet1!B62:C62）

想问一下Tang Mega60K开发板上面的40个排针，除了5V和GND以外的38个，是不是都可以当做一样的普通I/O拓展用，都能用来做SPI通信吗？然后它的那个cst文件上面一堆在板子上找不到的引脚，是因为复用了吗？

> 你自己看原理图啊， 他芯片上有引脚不等于有给你引出到核心板； 你核心板上有引出引脚不等于有引出到排针； 用于SPI通讯的引脚应该注意bank电压匹配即可， 优先选用电压匹配的引脚，否则需要使用驱动/缓冲器或者电平移位器（双向引脚）

### 108（Sheet1!B64:C64）

选题2，基础要求写「支持四路及以上独立声部同时并发发声」，而统计规则写「FM 按调制运算器统计」。 那么：4 个声部 × 每声部 4 算子 = 16 个振荡器，还是算 4 声部？「复音数 ≥32」指的是声部数还是振荡器数？

> 我记得应该是按照振荡器数量是可以的， 或者你做了32个声部也可以，两种都是合规的。

### 109（Sheet1!B65:C65）

选题2，系统吞吐量指标：以「同时活跃可闻独立振荡器总数 × 实际音频输出采样率」为核心评分依据，过采样不叠加加分。 同时是指一个音频采样周期还是说必须并行？

> 你把一套硬件通过时分复用在同一个采样周期里面运行多次，作为多个独立振荡器来使用，这样正常情况下也是能被视作并行的。

### 110（Sheet1!B66:C66）

赛题二，现场验证要求：支持测试模式下输出多路不同频率音频，频谱可观测对应数量独立谱峰。多路是要输出多路iis吗

> 一个输出通道就符合要求。 如果你弄多个输出通道的话这可能属于创新设计。 一般建议直接板载音频输出+一个I2S引出， 其两者输出的是相同的音频通道，相当于只需要把板载DAC的I2S额外引出一份到排针。

### 111（Sheet1!B67:C67）

赛题二 如果要使用可以触屏的HDMI 显示屏 对于显示屏来说 是否带HDMI的驱动板

> 可以的， 这不是安路赛道

### 112（Sheet1!B68:C68）

赛题是否对Verilog语言的具体标准有做要求？比如Verilog-2001或者SystemVerilog之类的？线下测验考察时是否也有类似的要求？

> 赛题没有要求， 理论上上你用VHDL都行。
> 线下测试是很简单的题型，只需要会verilog即可， 不过需要配置仿真环境。 你可以看看1群里面有的前几年的线下综测题。

### 113（Sheet1!B69:C69）

赛题二 开发版可以用tang mega 138k pro dock吗

> 可以的

### 114（Sheet1!B70:C70）

赛题二，拨弦是指动作还是声音呢

> 应该是指声音播放的触发

### 115（Sheet1!B71:C71）

赛题二中，基础要求“控制信号到音频输出总延迟≤10ms”和拓展要求“演奏延迟≤5ms”，请问具体的计时起点和终点如何定义？
例如，我们使用TTP229电容触摸按键，其芯片内部典型响应时间约16ms，但FPGA首次完整接收到有效按键数据后，到I2S输出有效音频数据的实测延迟约3.4ms。
1. 计时起点**是手指实际接触按键、传感器输出有效电信号，还是FPGA读取并确认有效控制事件？
2. 计时终点**是FPGA通过I2S输出有效PCM数据，还是DAC/功放输出模拟音频，或扬声器实际发声？
3. 传感器内部扫描、接口通信、FPGA消抖等时间是否全部计入？基础10ms和拓展5ms是否采用相同测量口径？
4. 是否有官方认可的延迟测量方法或判定标准？
我们希望在最终硬件选型前明确要求，以避免因为传感器内部响应时间而无法满足赛题指标。谢谢！

> 首先，FPGA 本身的信号处理延迟一定要满足赛题对应的要求，这是需要先做好的部分。至于外部传感器的响应、扫描、通信，以及后端音频设备的延迟，目前这里还没有能够确认的统一计时口径，实际评审未必会逐段严格计入，但也不能直接保证这些时间一律不算。
> 我的建议：在 FPGA 延迟满足要求的基础上，优先把整体效果做好。如果一种输入方式虽然交互延迟稍大（如15ms交互+3ms信号）但更方便、更人性化、更有表现力，演奏和展示效果也更好，那么从综合评价来看，这种方案往往分数更高。没必要为了压低几毫秒的延迟削足适履，把原本有意思、好用的交互砍成几个机械按键。低延迟是作品的优点，但不是唯一的评价依据。
> 当然，这也不意味着外部延迟可以随便大。整体操作延迟本身就是“操作手感”的一部分，操作和声音之间的滞后越不明显越好。如果已经明显影响跟手程度和演奏体验，那同样会影响作品的整体效果。
> 具体到 TTP229 的例子，可以明确说明“传感器典型响应约 16ms，FPGA 完整接收到有效按键数据后至 I2S 输出有效音频实测约 3.4ms”。这能够展示 FPGA 部分的处理性能，但单凭后面的 3.4ms，还不能直接认定整条链路已经满足 5ms 或 10ms 的要求。
> 关于自行验证，建议把外设响应、FPGA 处理和最终音频输出分段测量，说明每项测量的起点和终点。有条件可以用示波器、逻辑分析仪、相机慢放等方式记录控制信号与音频输出的时间关系，再结合实际演奏展示操作手感。能够把延迟测清楚、把效果展示出来，比单纯报一个数字更有说服力。
> 我们这个高云杯一直更加注重整体工程设计和效果， 对于绝对的纸面数据指标实际上没那么注重。你想象自己正在设计一个产品而不是应试做题

### 116（Sheet1!B72:C72）

赛题二可以使用有源音箱吗？不确定小喇叭是否能满足需求或者音箱是否能提高音质上限？

> 你的作品如果用小喇叭听不出不同的音色， 用音响可以的话， 那么还是单独弄一台音响， 因为这已经影响你的作品展示效果了；  实际上某宝上的小型有源音响已经就能达到不错的音质

### 117（Sheet1!B73:C73）

赛题二可以使用外接的琴键去采集信息吗

> 可以的

### 118（Sheet1!B74:C74）

赛题二采集的外设必须纯手搓吗可以用成品方案吗

原表未填写回答。

### 119（Sheet1!B75:C75）

赛题二能否给出统一的延迟测量标准和方法？此外，赛题二中使用midi键盘，midi键盘已经自带力度感应是否能算入多维度控制？

> ① 看问115； ② 算

### 122（Sheet1!B78:C78）

赛题二，可以将i2s引出后接max98357模块吗，这算不算违反i2s接口输出音频信号至DAC解码发声

> 可以，我记得这个就是I2S+DAC+功放， 是个好东西， 好用！

### 124（Sheet1!B80:C80）

赛题二和手机的通信必须是蓝牙吗 可以用wifi模块吗

> 这个选题指南只是给你启发， 你可以用wifi模块， 也可以用红外遥控， 也可以用NFC， 也可以用KFC， 也可以用TYPE-C， 总之能连接手机就彳亍

### 126（Sheet1!B82:C82）

赛题二 老师您好，我们使用Tang Mega 60K Console 32001C底板，FPGA为GW5AT-LV60PG484AC1/I0、器件版本B，开发工具是Gowin IDE V1.9.12.04。板载50 MHz时钟从V22输入，通过PLLA生成24.6 MHz音频时钟。目前出现PR1014，提示clk_50m_d将使用通用布线资源，可能导致较大延迟或偏斜；综合阶段还出现两条CK3000，提示无法计算clk_50m与PLLA输出自动生成时钟之间的关系。完整工程可以生成bitstream，最终STA的Setup/Hold违例均为0。缩减为小工程后PR1014仍存在，尝试不同BUFG位置和布线选项也未消除；小工程改成25 MHz整数PLL后CK3000消失，但PR1014仍在。请问在不飞线、不增加晶振、保留V22输入和24.6 MHz音频时钟的情况下，是否有官方推荐的RTL、时钟原语、约束或工具版本能够规范解决？如果属于已知告警，应检查哪些指标来确认可靠性？我们希望解决实际问题，而非仅屏蔽告警，可以提供最小复现工程和完整日志。

> 应该是没有的， 建议在竞赛时间非常有现代情况下还是更关注实际效果， 如果效果影响较大， 再针对性的修改优化

### 128（Sheet1!B84:C84）

我使用的是 Sipeed Tang Mega 60K Dock 开发板，板上有一颗顶标为 BL616C50 的无线 SoC。手机的 BLE 扫描器找不到这块板。请按这款板卡说明：BL616C50 出厂运行什么固件、默认是否开启 BLE 广播？若开启，能不能提供设备名、GATT 服务/特征 UUID 和连接要求并说明它与 FPGA 的 UART 引脚、串口参数及数据透传方式？若需配置或更新固件，请问能不能提供官方支持的方法？

> 这种建议去sipeed的技术文档或者询问sipeed相关客服，或者在群里问问大佬，sipeed如果没能提供某些资料我这也没有诶

### 129（Sheet1!B85:C85）

赛题二最终成品可以连接电脑USB端口进行供电吗？没有独立的电源模块。

> 肯定可以的， 也没让你电源必须独立弄

### 130（Sheet1!B86:C86）

问题：上述效果（混响、延迟、合唱、滑音、颤音、包络等等）是必须实体按键控制，还是可以app/触摸屏/电脑软件控制

> 修改配置、切换模式之类的复杂的、延迟不敏感的操作， 我觉得是可以使用触摸屏控制的， 使用电脑上位机配置应该也可。
