Lonelyrockroll/qiansai/FULLSCREEN-SCORE.md

# v31 · PDF 曲谱全屏显示

手机选择 PDF，Tang 的 7 英寸 HDMI 屏全屏显示所选页。手机负责翻页。当前页传好后，即使断开手机，也可以继续看这一页。

## 验收演示

1. 在手机覆盖安装 `realtime_synth/android_recorder/dist/TangRecorder-1.2.apk`。先断开其他蓝牙串口 App，再在演奏助手中连接 `=BTNU1`，等待“曲谱显示已就绪”。
2. 在 **PDF 曲谱**卡片点 **示例 PDF**，再点 **发送本页并显示**。屏幕应显示《小星星》、`1/2` 和第 1～6 小节。
3. 点 **下一页并发送**。传完后应显示 `2/2` 和第 7～12 小节。点 **上一页并发送**可以翻回去。翻页过程中会暂时看到演奏界面。
4. 正在看谱时短按旋钮 B（或板上 KEY.0），可返回演奏界面。在手机点 **显示已传页面**，可以重新打开刚才的页，无需重传。

只展示曲谱可以保持静音。要边看边弹，先在原菜单执行 **开始演奏**，再全屏显示曲谱。

若要演示从手机选文件，把 `output/pdf/score-demo.pdf` 存进手机下载目录，点 **选择 PDF**，选它后执行同样的步骤。该文件已排成适合横屏的两页大字白键简谱，App 内置示例和提供的 PDF 完全相同。工程也保留了两页的预处理位图、压缩数据和预览，在 `output/pdf/score-demo/`；手机正常演示只需 PDF 或内置按钮。

## 支持范围

- 手机可选择本地或系统文件选择器能访问的 PDF，支持 1～200 页、最多 20 MB。加密 PDF 需先在手机另存为无密码版本。
- 每次传一页。手机保留原文件，切换页时需要保持蓝牙连接。板卡不会存整本 PDF，不做乐谱识别或自动演奏。
- 原页按宽高比例适配 1024×600 全屏，以黑白显示。为节省内存，板内存 1024×512 像素，再扩展到 600 行。竖版整页也可显示，但密集小字在横屏上会偏小。
- 新页会替换上一页的缓存。分包和解压后的整页都校验通过才显示；传输中断时可重新发送当前页。
- 曲谱、MIDI 和录音可以分别使用，手机不会在录音传输中同时上传曲谱。看谱时仍可正常演奏。
- PDF 缓存与工程用 PCM 抓取功能共用同一块 RAM。只返回演奏界面会保留曲谱；需要工程抓取时，在手机点 **清除板上曲谱**释放缓存。原蓝牙演奏录音使用独立缓存。
- SRAM 临时下载不写 Flash。断电后需重新下载 v31，并重发要看的 PDF 页。

## 实现与验证

`fpga/synth_display.gprj` 是整机工程。安卓用系统 [PdfRenderer](https://developer.android.com/reference/android/graphics/pdf/PdfRenderer.Page) 渲染所选页，RLE 压缩后通过经典蓝牙串口传输。FPGA 检查每包 CRC16、解压后 65536 字节和整页 CRC32，再在视频帧边界切换画面。

BRAM 的系统时钟端口用于导入曲谱或进行原来的 PCM 采集，像素时钟端口独立读取图像。缓存让出时会等待屏幕退出整页显示，避免边读旧页边写新页。独立布局已验证这块 32768×16 RAM 使用 32 个物理 BSRAM，与原采集缓存容量相同。

实际临时下载版本为 v31，JTAG 回读 User Code `0x000063B5`。整机使用 116 / 118 块 BSRAM、43,538 / 59,904 个逻辑单元；系统时钟目标 50 MHz，报告 Fmax 50.014 MHz，全部约束时钟 setup/hold 检查通过。保留既有 PR1014 时钟布线警告，系统时序裕量较小。实板 HDMI 已锁定，32 键已校准，静音采集的 128 个 PCM 数据字与板端 CRC 一致。

安卓 1.2 与 Tang 的实物验收通过。手机发来的第一页压缩后 13,492 字节，第二页 13,538 字节，板端分别恢复为 65,536 字节并在 HDMI 上全屏显示。用户确认“两页都能全屏显示，翻页正常”。从首次观测到接收，到板端进入显示状态，分别约 45.6 秒和 46.6 秒；时间主要花在逐包蓝牙确认上，验收时可提前载入第一页。原始记录在 `tests/score_fpga/board_20261102/`。

第二页的 65,536 字节已从实板完整读回，CRC32 为 `B2AA6355`。[实板缓存还原图](tests/score_fpga/board_20261102/phone-page-02.png)上可见 `2/2`、第 7～12 小节与终止线。Android 和离线 PDF 渲染器的字形边缘略有不同；验收使用手机实际传入的数据。曲谱占用期间，PC 工程采集申请被正确拒绝，未改动屏幕页面。

复现入口：

- `python tests/score_fpga/run.py`：真实 Android 上传数据、CRC、重传、序号回绕、RLE 边界、完整 64 KiB 双时钟读回、与原 MIDI 共存。
- `python tests/score_controller/run.py`：PC 状态、工程读回、按键退出、PCM 互斥。
- `tests/score_video/README.md`：整帧像素对照，以及换页与采集交界时的所有权测试。
- `realtime_synth/android_recorder/README.md`：Android 安装、构建和协议测试。
- `tools/score_board.py`：实板状态、PCM 兼容性和曲谱像素读回。
