Lonelyrockroll/qiansai/fpga/ORIGIN.md

USB HID 主机基于 [m1nl/usb_hid_host](https://github.com/m1nl/usb_hid_host)，提交 `5d2bf72472bddc6da71134fa7d29d42a99a02f0a`。修改后的 RTL 及许可证随附。
