Lonelyrockroll/qiansai/output/pdf/score-demo.pdf

小星星 | 32白键 / 大字简谱 | 1 / 2
1 = C 4/4拍 数字一拍，横线延长一拍 | 第 1-6 小节

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
G4 | 延长

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
C4 | 延长

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
D4 | 延长
音名对应：1=C4 2=D4 3=E4 4=F4 5=G4 6=A4 | 手机翻页 · 点按 B 返回
传统旋律《小星星》 / 本项目重新排版，无需黑键。 | 接下一页

小星星 | 32白键 / 大字简谱 | 2 / 2
1 = C 4/4拍 数字一拍，横线延长一拍 | 第 7-12 小节

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
D4 | 延长

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
G4 | 延长

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
C4 | 延长
音名对应：1=C4 2=D4 3=E4 4=F4 5=G4 6=A4 | 手机翻页 · 点按 B 返回
传统旋律《小星星》 / 本项目重新排版，无需黑键。 | 全曲结束
