Lonelyrockroll/qiansai/realtime_synth/throughput_eval/experiments/modal32/board_C4_20261101/c4_spectra.csv

hz | silence | c4 | c4_repeat
0.000000000000000000e+00 | 0.000000000000000000e+00 | 1.282806593803660911e-01 | 1.282806593803660911e-01
1.192092895507812500e+01 | 0.000000000000000000e+00 | 6.000993511844925771e-02 | 6.000993511844925771e-02
2.384185791015625000e+01 | 0.000000000000000000e+00 | 1.121091360632055743e-02 | 1.121091360632055743e-02
3.576278686523437500e+01 | 0.000000000000000000e+00 | 7.744425740333184607e-03 | 7.744425740333184607e-03
4.768371582031250000e+01 | 0.000000000000000000e+00 | 1.455719065555098612e-02 | 1.455719065555098612e-02
5.960464477539062500e+01 | 0.000000000000000000e+00 | 6.449526866375239476e-03 | 6.449526866375239476e-03
7.152557373046875000e+01 | 0.000000000000000000e+00 | 9.799723668235624588e-03 | 9.799723668235624588e-03
8.344650268554687500e+01 | 0.000000000000000000e+00 | 2.136596747305916436e-02 | 2.136596747305916436e-02
9.536743164062500000e+01 | 0.000000000000000000e+00 | 1.984598895803797725e-02 | 1.984598895803797725e-02
1.072883605957031250e+02 | 0.000000000000000000e+00 | 2.229006939885835349e-03 | 2.229006939885835349e-03
1.192092895507812500e+02 | 0.000000000000000000e+00 | 9.410073646526392888e-03 | 9.410073646526392888e-03
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
