Lonelyrockroll/qiansai/realtime_synth/throughput_eval/experiments/modal32/musical/board_C4_20261101/c4_spectra.csv

hz | silence | c4 | c4_repeat
0.000000000000000000e+00 | 0.000000000000000000e+00 | 2.960724107269140593e+00 | 2.960724107269140593e+00
1.192092895507812500e+01 | 0.000000000000000000e+00 | 1.472467816562021969e+00 | 1.472467816562021969e+00
2.384185791015625000e+01 | 0.000000000000000000e+00 | 1.520730415561539345e-02 | 1.520730415561539345e-02
3.576278686523437500e+01 | 0.000000000000000000e+00 | 8.621076027211634074e-03 | 8.621076027211634074e-03
4.768371582031250000e+01 | 0.000000000000000000e+00 | 2.345468604054654418e-02 | 2.345468604054654418e-02
5.960464477539062500e+01 | 0.000000000000000000e+00 | 1.175681389441471034e-02 | 1.175681389441471034e-02
7.152557373046875000e+01 | 0.000000000000000000e+00 | 1.890496091812996979e-02 | 1.890496091812996979e-02
8.344650268554687500e+01 | 0.000000000000000000e+00 | 9.106784819690811467e-03 | 9.106784819690811467e-03
9.536743164062500000e+01 | 0.000000000000000000e+00 | 2.004738244770315134e-02 | 2.004738244770315134e-02
1.072883605957031250e+02 | 0.000000000000000000e+00 | 1.479096497737391117e-02 | 1.479096497737391117e-02
1.192092895507812500e+02 | 0.000000000000000000e+00 | 2.992472387566553690e-02 | 2.992472387566553690e-02
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
