Lonelyrockroll/qiansai/output/pdf/score-demo/page-01-mono-512.png

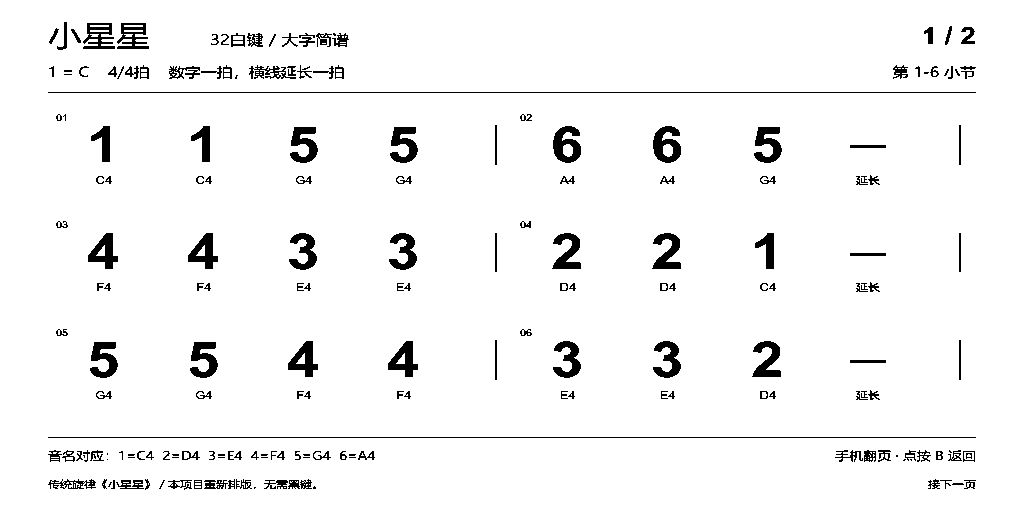
output/pdf/score-demo/page-01-mono-512.png
