Lonelyrockroll/qiansai/output/pdf/score-demo/page-01-storage.png

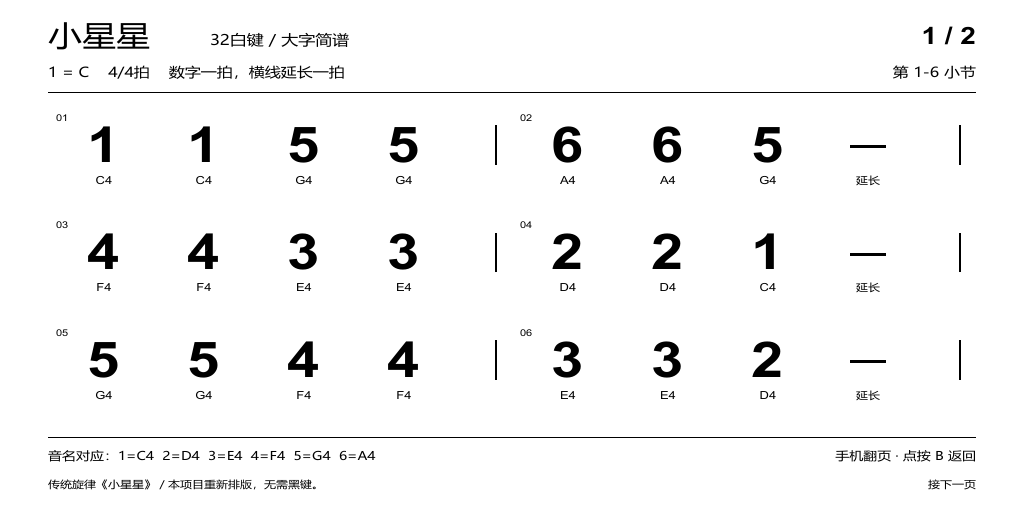
output/pdf/score-demo/page-01-storage.png
