Lonelyrockroll/qiansai/output/pdf/score-demo/page-02-original.png

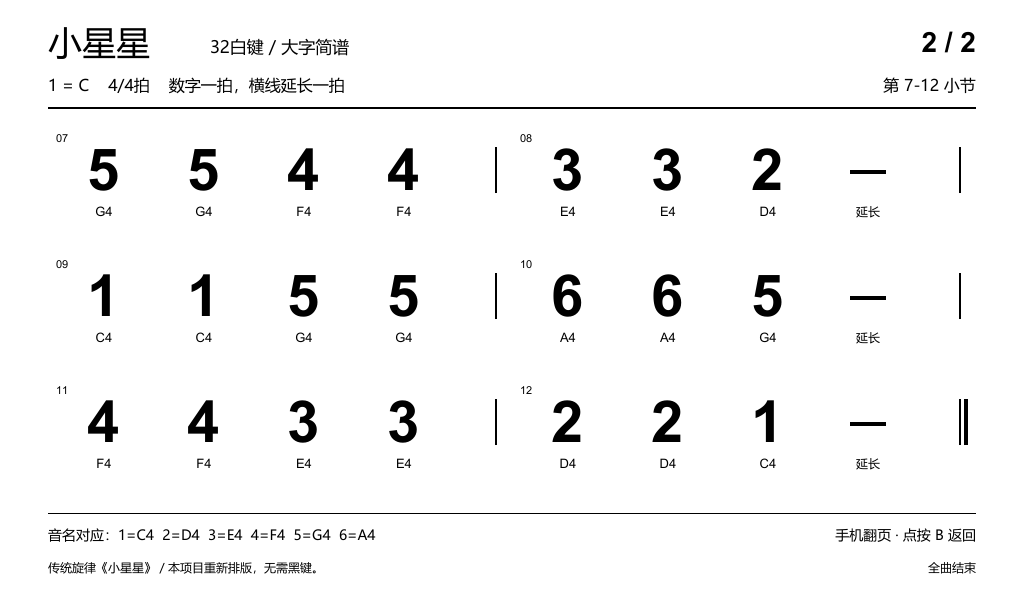
output/pdf/score-demo/page-02-original.png
