Lonelyrockroll/qiansai/SCREEN-GUIDE.md

# v30 · 屏幕演奏指引

本版把 C2～F6 的 32 个白键铺满屏幕上部的一行。按实际音高顺序显示，与实体 32 键一致。曲目只控制屏幕目标，不自动发声；实际琴键、12 键鼓组、Loop 和原有音频输出继续工作。

按本次约定，指引不连接或改动琴键上的实体 LED。屏幕指引可以演示曲目跟奏，但不能据此声称已通过实体 LED 灯的验收。

## 屏幕怎么看

- 整块彩色琴键：此刻应按住的音。刚起音更亮，延音颜色变浅。
- 琴键上方的金色短条：下一时间组即将开始的音。
- 绿色边框：实际按下的琴键；当前有目标音时，按到目标以外的键显示珊瑚色边框。
- 音轨决定目标颜色，保持 MIDI 的 TrackIndex；不按音高猜左右手。
- 同时开始的和弦一起亮；播放结束清空目标、停止计时并回到 0。暂停保留当前目标，可以停下来练习。

指引按曲目的时间运行，当前不根据弹奏正确与否自动等待或评分。

## 不接手机也能演示

v30 每次加载时内置一段 16 秒、56 事件的白键短句。旋钮 B 转动选择菜单，短按执行：

| 菜单 | 操作 |
|---|---|
| 指引播放 / 暂停 | 启动或暂停指引计时 |
| 下一组音 | 暂停并跳至下一组起音 |
| 指引回到开头 | 回到 0，保持暂停 |

原来的“开始演奏”控制音频功放，与指引播放分别操作。要跟奏出声，先开始演奏，再启动指引。旋钮 B 按住旋转仍调音量，旋钮 A 的滑音、颤音和静音手势保持不变。菜单共 12 项，分两列显示。

## 手机传 MIDI

安装 `realtime_synth/android_recorder/dist/TangRecorder-1.1.apk`，可覆盖原录音 App。先断开蓝牙调试宝，在新 App 连接已配对的 `=BTNU1`（地址尾号 7BB6），等待“屏幕指引已就绪”。

1. 首次可选“示例 MIDI”，它是 24 秒的白键旋律。
2. 或点“选择 MIDI”，选择 `.mid` / `.midi` 文件，再选择一条旋律音轨。
3. 查看预览后点“发送曲目到板卡”。有黑键、超出 C2～F6 或打击乐音符时，会明确提示略过的数量；不自动移调。
4. 等“已传入曲目”后播放。手机也可以暂停、回到开头、前后步进、调速度或切回板载示范曲。
5. 发送完成后断开手机，板卡仍独立计时。本次程序仅临时写入 SRAM；断电后需要先重新临时下载 v30，默认出现内置短句，再从手机重传导入曲目。

首版每次导入一条音轨，支持 SMF 0/1 和 PPQN 时间制。最多 512 个按下/松开事件，通常约 256 个完整音符；最长 655.35 秒，时间分辨率 10 ms。过大的文件请先截取短段或导出单条旋律。延音踏板、重叠同音和速度变化由手机转换。速度可选 0.5、0.75、1、1.25 倍。

上传和录音共用蓝牙链路，App 会阻止两者同时传输。上传采用分包 CRC16、整曲 CRC32、确认与重传；新曲完整校验成功才替换旧曲。传完后仍可使用原来的蓝牙录音功能。

## 工程与验证入口

- v30 已临时下载到 Tang Mega 60K NEO，JTAG 回读 `0x0000BB8F`。固件包：`firmware/screen-guide.zip`。仅 SRAM 临时下载，未写 Flash。
- 实板检查通过：示范曲实测 16.062 秒结束，播放/暂停/继续、前后步进、四档速度、结束清屏归零均正常；32 键重新校准后无误触发。用户已确认“32 键、跟奏变色和实按边框都正常”。
- 安卓实物验收通过：用户用 1.1 App 通过蓝牙传入示例 MIDI，确认“上传成功，断开手机后仍继续指引”。随后板卡实际回读为外部上传曲目、84 个事件、24 秒；演示结束后时间和目标掩码归零。记录在 `tests/guide_fpga/board_20261102/`。
- 整机布局使用 116 / 118 块 BSRAM，逻辑 42,886 / 59,904；50 MHz 系统时钟报告 Fmax 50.056 MHz，所有约束时钟 setup/hold 检查通过。保留既有 PR1014 时钟通用布线警告，系统时序裕量仍小。报告见 `firmware/screen-guide-build.json`。
- Gowin 工程：`fpga/synth_display.gprj`；构建：在 `fpga` 下运行 `gw_sh.exe build.tcl`。
- 指引协议和时序回归：`python tests/guide_fpga/run.py`。
- Android 工程、协议说明和测试：`realtime_synth/android_recorder/README.md`。
- UI 生成器：`tools/generate_guide_panel.py`。字库移除全空白的第 16 行，分为三组同步 ROM；画面保持不变。
- 实板回归：`python tools/check_guide_board.py <记录目录>`，仅用于已载入内置曲目、无演奏和 Loop 的板卡；会保持音频静音。

## v30 时的 PDF 曲谱方案

以下是 v30 阶段的容量评估。后续 v31 已完成 PDF 全屏显示和手机翻页，使用方法见 [曲谱验收步骤](FULLSCREEN-SCORE.md)。

推荐手机负责下载/打开 PDF，并用 Android 的 [PdfRenderer](https://developer.android.com/reference/android/graphics/pdf/PdfRenderer) 把所选页转为黑白位图，再通过蓝牙传到 FPGA 全屏显示。FPGA 接收图片，不承担 PDF 字体和页面解析。手机保留原文件，按页发送；来源可以是浏览器下载后在 App 中选文件。

现有片上存储空间紧张。一个 1024×600、1 位黑白页面需要 75 KiB，不能直接再增加这么大的独立帧缓存。可复用现有工程 PCM 抓取缓存，保存 1024×512、1 位图像，大小 64 KiB，再按屏幕高度重复部分扫描行。手机预先处理纵向比例，可以保持谱页比例；显示 PDF 时暂时不能进行工程 PCM 抓取。蓝牙录音有独立缓冲，但复用方案仍需完成仲裁与回归才能确认两者并行。

115200 波特率、8N1 下，64 KiB 仅原始数据就至少需 5.69 秒；加分包校验和重试会更久，适合先传好一页再看，不适合实时连续翻滚。竖版整张 A4 在这块横屏上会显得较窄，建议提供“整页”和“裁切半页”两种视图。

实现时还需要处理系统时钟写入、像素时钟读取的双时钟 RAM，以及页面提交后的帧边界切换。本次先交付 MIDI 屏幕指引，PDF 尚未加入 App 或固件。
