Lonelyrockroll/qiansai/realtime_synth/throughput_eval/experiments/modal32/musical/README.md

# 32 分量演奏钢琴

本版保留「敲击钢琴」原来的选择位置。32 个带有独立相位和衰减状态的分量在同一键内相加。正弦、风琴、柔和复合和弦乐锯齿沿用各自的波表，鼓组沿用独立打击乐引擎。前一版偏亮的演示音色保存在[原演示目录](../README.md)。

## 听感改动

沿用原 v26 钢琴前 12 阶琴弦的音高。原琴 4 条近频伴弦的起音能量、相位和部分尾音并入前四阶，新模型不能完全复现它们的慢拍频。新增的 13～32 阶在重击时更明显，随后快速淡出。C4 的第 12 阶衰减时间常数从演示版 1.342 s 回到原琴的 0.112 s。第 32 阶也从 0.895 s 缩短到 0.112 s。内核与采样率保持一致，改的是三十二行音色参数。[系数说明和检查](coefficient_report.json)

在同一琴键、力度和试听增益下，C4 起音的频谱重心由演示版 1,361 Hz 回到 495 Hz，原琴为 490 Hz。该指标描述声音的明亮程度，音色是否合适由实际试听判断。[三版 C4](audition/C4_compare.wav) · [三版乐句](audition/phrase_compare.wav) · [单独听新版](audition/musical32_phrase.wav) · [试听参数与结果](audition/README.md)

在限带计算中，前 23 个白键 C2～D5 可同时使用 32 个分量，E5 为 31 个，F6 为 14 个。[各键分量数](coefficient_report.json)

使用本次系数和整机音频链计算全部 32 个白键，在 25% 力度、正常增益下连续检查 512 帧，每帧用 577 / 1,024 拍，最终数字峰值 13,069，零限幅、零硬削波、零超时。高音限带后，931 个内部状态产生了非零贡献。最大力度和最高增益的压力测试会触发已有的限幅器。[整机音频仿真报告](stress_validation.json)

## 实板演奏版

2026-11-01 临时下载到 Tang Mega 60K NEO 的 SRAM，JTAG 实际回读 `0x0000D27F`。完整工程通过时序和引脚检查，系统时钟 Fmax 50.246 MHz，目标 50 MHz，BSRAM 115 / 118。[码流和校验报告](musical32_piano.zip) · [JTAG 回读](board_C4_20261101/candidate_jtag.log)

串口两次触发与实体第 15 个白键对应的 C4，每次均只打开一个音符。测试输入力度为 25%，输出增益为正常档 1。在送往音频输出的最终数字 PCM 上，两次起音采集各 4,096 点，都测到 32 / 32 个预期峰并通过板端 CRC 校验。相同力度下另抓一遍持续按键，从起音后 5.24 ms 和 221.18 ms 分别截取同长的窗。后一窗的 4 kHz 以上能量降低 10.83 dB，频谱重心从 491 Hz 降到 450 Hz。[实板频谱](board_C4_20261101/c4_peaks.png) · [逐峰数据](board_C4_20261101/c4_peaks.csv) · [起音与尾音对比](board_C4_20261101/strike_decay.json)

测试结束后已恢复实体琴键扫描、校准和原来的琴键及鼓组音量，并选中「敲击钢琴」用于试听。下载前停止的一层约 0.71 秒 Loop 已按用户确认清除。[采集与恢复记录](board_C4_20261101/capture.json)

## 复现

在上一级目录运行 `python route_candidate.py prepare 2 --compact-font --musical`，在打印的临时目录运行 `gw_sh.exe build.tcl`，再从上一级目录运行 `python route_candidate.py validate 2 --compact-font --musical`。位置选项 1 同理。音乐版与演示版的系数、编译输出、板测记录分别保存。
