Lonelyrockroll/qiansai/tests/contest_board/intermediate-C69B/fft.csv

bin | frequency_hz | all32 | off16 | off17
0 | 0.0 | 0.0 | 0.0 | 0.0
1 | 11.920928955078125 | 0.0 | 0.0 | 0.0
2 | 23.84185791015625 | 0.0 | 0.0 | 0.0
3 | 35.762786865234375 | 0.0 | 0.0 | 0.0
4 | 47.6837158203125 | 191.96673879235516 | 191.97585906192097 | 191.98211393206796
5 | 59.604644775390625 | 0.0 | 0.0 | 0.0
6 | 71.52557373046875 | 0.0 | 0.0 | 0.0
7 | 83.44650268554688 | 0.0 | 0.0 | 0.0
8 | 95.367431640625 | 0.051618413241727 | 0.050232420452486166 | 0.02897647644520635
9 | 107.28836059570312 | 0.0 | 0.0 | 0.0
10 | 119.20928955078125 | 0.0 | 0.0 | 0.0
11 | 131.13021850585938 | 0.0 | 0.0 | 0.0
12 | 143.0511474609375 | 192.006860105843 | 191.99444751197834 | 191.97465631319653
13 | 154.97207641601562 | 0.0 | 0.0 | 0.0
14 | 166.89300537109375 | 0.0 | 0.0 | 0.0
15 | 178.81393432617188 | 0.0 | 0.0 | 0.0
16 | 190.73486328125 | 0.020962526219813607 | 0.02436240998039065 | 0.01350150339957904
17 | 202.65579223632812 | 0.0 | 0.0 | 0.0
18 | 214.57672119140625 | 0.0 | 0.0 | 0.0
19 | 226.49765014648438 | 0.0 | 0.0 | 0.0
20 | 238.4185791015625 | 191.9058524193089 | 191.9461753040934 | 191.9275224385979
21 | 250.33950805664062 | 0.0 | 0.0 | 0.0
22 | 262.26043701171875 | 0.0 | 0.0 | 0.0
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
