Lonelyrockroll/qiansai/tests/contest_latency/csv_examples/synthetic_fall.csv

Model | synthetic fixture only
TIME_US | HALL_V | OUT_V
-30 | 1.00 | 0.10
-20 | 1.00 | 0.10
-10 | 1.00 | 0.10
0 | 1.00 | 0.10
10 | 1.00 | 0.10
20 | 0.60 | 0.10
30 | 0.60 | 0.10
40 | 0.60 | 0.10
50 | 0.60 | 0.10
60 | 0.60 | -0.10
70 | 0.60 | -0.12
80 | 0.60 | -0.09
90 | 1.00 | 0.10
