Lonelyrockroll/qiansai/tests/contest_latency/csv_examples/synthetic_rise.csv

Model | synthetic fixture only
TIME_US | HALL_V | OUT_V
-30 | 1.00 | 0.10
-20 | 1.00 | 0.10
-10 | 1.00 | 0.10
0 | 1.00 | 0.10
10 | 1.40 | 0.10
20 | 1.40 | 0.30
30 | 1.40 | 0.10
40 | 1.40 | 0.25
50 | 1.40 | 0.26
60 | 1.40 | 0.24
70 | 1.40 | 0.10
80 | 1.00 | 0.10
90 | 1.00 | 0.10
