Lonelyrockroll/qiansai/realtime_synth/throughput_eval/experiments/modal32/board_C4_20261101/c4_peaks.csv

take | partial | expected_hz | stretch_vs_integer_harmonic_hz | fft_bin | fitted_hz | error_hz | amplitude_pcm | silent_peak_pcm | local_sideband_max_pcm | contrast_db | passed
c4.pcm | 1 | 261.62556423514616 | 0.0 | 22 | 261.5728719967437 | -0.0526922384024715 | 73.87324386216922 | 0.0 | 0.08119473390082238 | 43.39034330983821 | True
c4.pcm | 2 | 523.2591092863004 | 0.007980816008057445 | 44 | 523.1580244710702 | -0.10108481523013779 | 58.6779220462126 | 0.0 | 0.10205303390599246 | 41.39009442984617 | True
c4.pcm | 3 | 784.9126177461585 | 0.035925040720030665 | 66 | 784.7765938467904 | -0.13602389936806958 | 48.25706034770319 | 0.0 | 0.13300197509775488 | 39.69181716665965 | True
c4.pcm | 4 | 1046.5980608387326 | 0.09580389814800583 | 88 | 1046.4312868803306 | -0.16677395840201825 | 41.04623533337183 | 0.0 | 0.15349796613193883 | 38.2860665290302 | True
c4.pcm | 5 | 1308.3154385640228 | 0.18761738829198293 | 110 | 1308.1304962258112 | -0.18494233821161288 | 35.41917440889425 | 0.0 | 0.15452988998724834 | 37.00536859195292 | True
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
