Lonelyrockroll/qiansai/realtime_synth/throughput_eval/experiments/modal32/musical/board_C4_20261101/c4_peaks.csv

take | partial | expected_hz | stretch_vs_integer_harmonic_hz | fft_bin | fitted_hz | error_hz | amplitude_pcm | silent_peak_pcm | local_sideband_max_pcm | contrast_db | passed
c4.pcm | 1 | 261.62556423514616 | 0.0 | 22 | 261.5741362455696 | -0.05142798957655259 | 733.1230753147219 | 0.0 | 0.7303591558864229 | 60.03280822568747 | True
c4.pcm | 2 | 523.3309593677404 | 0.07983089744811878 | 44 | 523.2370911250159 | -0.09386824272451122 | 578.149528767427 | 0.0 | 1.0520525806996115 | 54.800054599338175 | True
c4.pcm | 3 | 785.1920599932782 | 0.31536728783976287 | 66 | 785.0706411490697 | -0.12141884420850602 | 430.18309188923854 | 0.0 | 1.0530561114406018 | 52.224036475330664 | True
c4.pcm | 4 | 1047.2886970092077 | 0.786440068623051 | 88 | 1047.1569365352334 | -0.13176047397428192 | 240.961126388712 | 0.0 | 0.6535535678837315 | 51.333315895251 | True
c4.pcm | 5 | 1309.6967109049729 | 1.5688897292420734 | 110 | 1309.5737397293112 | -0.12297117566163251 | 116.80428125059781 | 0.0 | 0.3110870068818315 | 47.369775140285796 | True
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
