Lonelyrockroll/qiansai/tests/contest_latency/results/measurements.csv

case | key | timbre | max_level | scan_phase_clocks | ramp_codes_per_scan | motion_to_threshold_ns | kept_aperture_ns | scanner_handshake_ns | engine_handshake_ns | pcm_ns | pt_word_ns | i2s_word_ns | i2s_abs16_ns | velocity_code | event_level | serial_peak
0 | 14 | 4 | 4588 | 1 | 0 | 0 | 480170 | 481190 | 481890 | 537290 | 559330 | 562130 | 644050 | 1024 | 4588 | 39
1 | 14 | 4 | 4588 | 0 | 0 | 0 | 10 | 570 | 1390 | 60510 | 82550 | 85350 | 167270 | 512 | 4588 | 39
2 | 14 | 4 | 4588 | 3000 | 0 | 0 | 420190 | 421210 | 421910 | 475390 | 497430 | 500230 | 582150 | 1024 | 4588 | 39
3 | 14 | 4 | 4588 | 6000 | 0 | 0 | 360190 | 361210 | 361910 | 409630 | 431670 | 434470 | 516390 | 1024 | 4588 | 39
4 | 14 | 4 | 4588 | 9000 | 0 | 0 | 300190 | 301210 | 301910 | 343870 | 365910 | 368710 | 450630 | 1024 | 4588 | 39
5 | 14 | 4 | 4588 | 12000 | 0 | 0 | 240190 | 241210 | 241910 | 298590 | 320630 | 323430 | 405350 | 1024 | 4588 | 39
6 | 14 | 4 | 4588 | 15000 | 0 | 0 | 180190 | 181210 | 181910 | 232830 | 254870 | 257670 | 339590 | 1024 | 4588 | 39
7 | 14 | 4 | 4588 | 18000 | 0 | 0 | 120190 | 121210 | 121910 | 167070 | 189110 | 191910 | 273830 | 1024 | 4588 | 39
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
