Lonelyrockroll/qiansai/tests/pc_analysis/results/all32/peaks.csv

fft_bin | frequency_hz | peak_pcm | peak_dbfs
4 | 47.68371582 | 191.966739 | -44.6445
12 | 143.05114746 | 192.008347 | -44.6426
20 | 238.41857910 | 191.907706 | -44.6472
28 | 333.78601074 | 191.962104 | -44.6447
36 | 429.15344238 | 191.898879 | -44.6475
44 | 524.52087402 | 191.971728 | -44.6443
52 | 619.88830566 | 191.950269 | -44.6452
60 | 715.25573730 | 191.897028 | -44.6476
68 | 810.62316895 | 192.037867 | -44.6413
76 | 905.99060059 | 191.947640 | -44.6453
84 | 1001.35803223 | 191.987837 | -44.6435
92 | 1096.72546387 | 192.059980 | -44.6403
100 | 1192.09289551 | 191.958541 | -44.6448
108 | 1287.46032715 | 191.888044 | -44.6480
116 | 1382.82775879 | 192.109154 | -44.6380
124 | 1478.19519043 | 192.047016 | -44.6408
132 | 1573.56262207 | 191.997258 | -44.6431
140 | 1668.93005371 | 192.056678 | -44.6404
148 | 1764.29748535 | 192.012570 | -44.6424
156 | 1859.66491699 | 192.034458 | -44.6414
164 | 1955.03234863 | 191.863215 | -44.6492
172 | 2050.39978027 | 192.019785 | -44.6421
180 | 2145.76721191 | 191.899133 | -44.6475
188 | 2241.13464355 | 192.038217 | -44.6412
196 | 2336.50207520 | 192.034598 | -44.6414
204 | 2431.86950684 | 192.059198 | -44.6403
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
