Lonelyrockroll/qiansai/tests/pc_analysis/results/off16/peaks.csv

fft_bin | frequency_hz | peak_pcm | peak_dbfs
4 | 47.68371582 | 191.975861 | -44.6441
12 | 143.05114746 | 191.995564 | -44.6432
20 | 238.41857910 | 191.947333 | -44.6454
28 | 333.78601074 | 191.972810 | -44.6442
36 | 429.15344238 | 191.872907 | -44.6487
44 | 524.52087402 | 191.957679 | -44.6449
52 | 619.88830566 | 191.924814 | -44.6464
60 | 715.25573730 | 191.880614 | -44.6484
68 | 810.62316895 | 192.041790 | -44.6411
76 | 905.99060059 | 191.928357 | -44.6462
84 | 1001.35803223 | 191.989855 | -44.6434
92 | 1096.72546387 | 192.031736 | -44.6415
100 | 1192.09289551 | 191.984024 | -44.6437
108 | 1287.46032715 | 191.898058 | -44.6476
116 | 1382.82775879 | 192.096130 | -44.6386
132 | 1573.56262207 | 192.002853 | -44.6428
140 | 1668.93005371 | 192.021444 | -44.6420
148 | 1764.29748535 | 191.983651 | -44.6437
156 | 1859.66491699 | 192.033904 | -44.6414
164 | 1955.03234863 | 191.856939 | -44.6494
172 | 2050.39978027 | 191.996257 | -44.6431
180 | 2145.76721191 | 191.919762 | -44.6466
188 | 2241.13464355 | 192.022619 | -44.6420
196 | 2336.50207520 | 192.002567 | -44.6429
204 | 2431.86950684 | 192.045182 | -44.6409
212 | 2527.23693848 | 191.973268 | -44.6442
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
