Lonelyrockroll/qiansai/tests/pc_analysis/results/off17/peaks.csv

fft_bin | frequency_hz | peak_pcm | peak_dbfs
4 | 47.68371582 | 191.980794 | -44.6438
12 | 143.05114746 | 191.978103 | -44.6440
20 | 238.41857910 | 191.923890 | -44.6464
28 | 333.78601074 | 191.973051 | -44.6442
36 | 429.15344238 | 191.877598 | -44.6485
44 | 524.52087402 | 191.988868 | -44.6435
52 | 619.88830566 | 191.913251 | -44.6469
60 | 715.25573730 | 191.914673 | -44.6468
68 | 810.62316895 | 192.041086 | -44.6411
76 | 905.99060059 | 191.936921 | -44.6458
84 | 1001.35803223 | 191.980332 | -44.6439
92 | 1096.72546387 | 192.017416 | -44.6422
100 | 1192.09289551 | 191.971191 | -44.6443
108 | 1287.46032715 | 191.904973 | -44.6473
116 | 1382.82775879 | 192.112989 | -44.6379
124 | 1478.19519043 | 191.990978 | -44.6434
140 | 1668.93005371 | 192.057685 | -44.6404
148 | 1764.29748535 | 191.957852 | -44.6449
156 | 1859.66491699 | 192.025250 | -44.6418
164 | 1955.03234863 | 191.864289 | -44.6491
172 | 2050.39978027 | 192.007553 | -44.6426
180 | 2145.76721191 | 191.922879 | -44.6465
188 | 2241.13464355 | 192.024929 | -44.6418
196 | 2336.50207520 | 192.009744 | -44.6425
204 | 2431.86950684 | 192.021484 | -44.6420
212 | 2527.23693848 | 191.938667 | -44.6457
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
