Lonelyrockroll/qiansai/profiles/spectrum-only/tests/monitor/results/test31.png

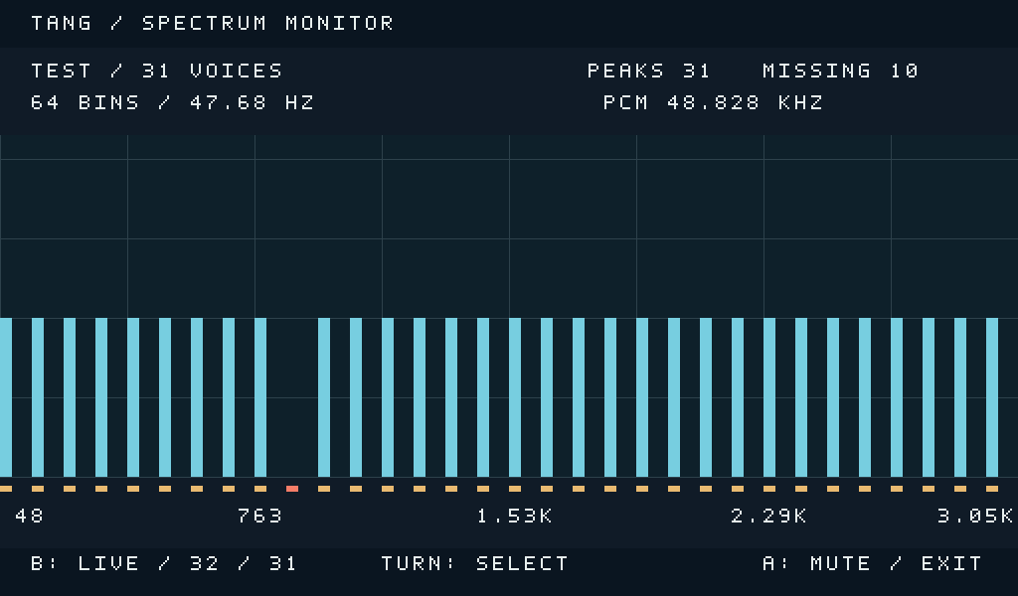
profiles/spectrum-only/tests/monitor/results/test31.png
