Lonelyrockroll/qiansai/profiles/spectrum-only/tests/monitor/results/test32.png

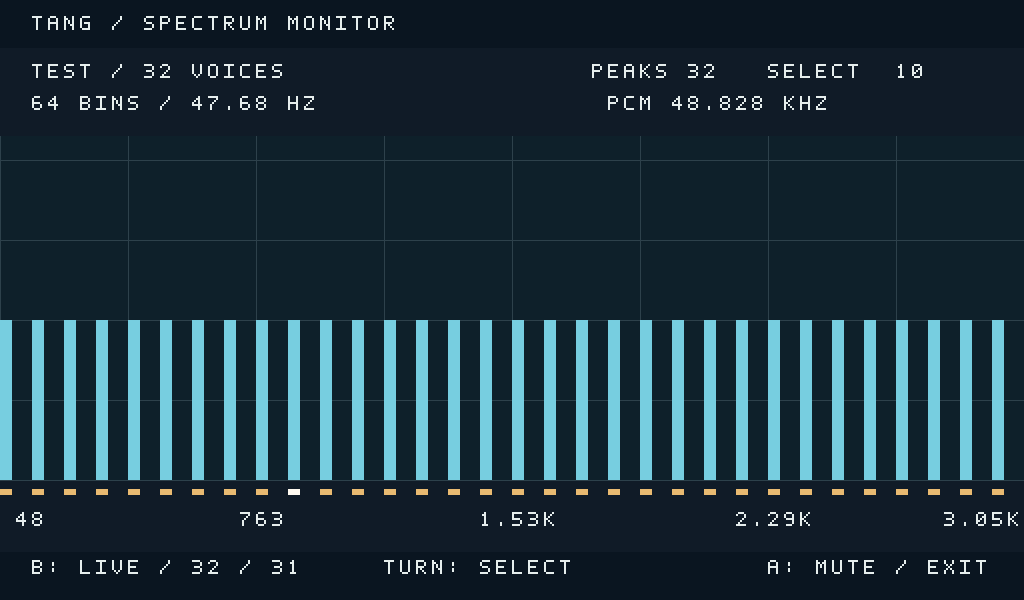
profiles/spectrum-only/tests/monitor/results/test32.png
