Lonelyrockroll/qiansai/profiles/spectrum-only/tests/monitor/results/tone.png

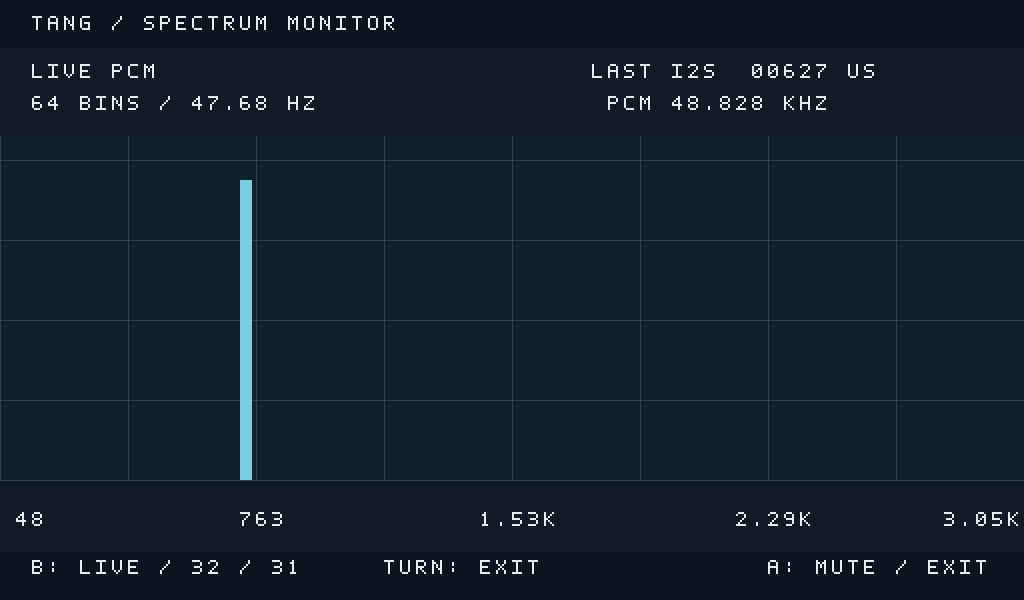
profiles/spectrum-only/tests/monitor/results/tone.png
