Lonelyrockroll/qiansai/realtime_synth/android_recorder/tests/evidence/online-midi-android35.png

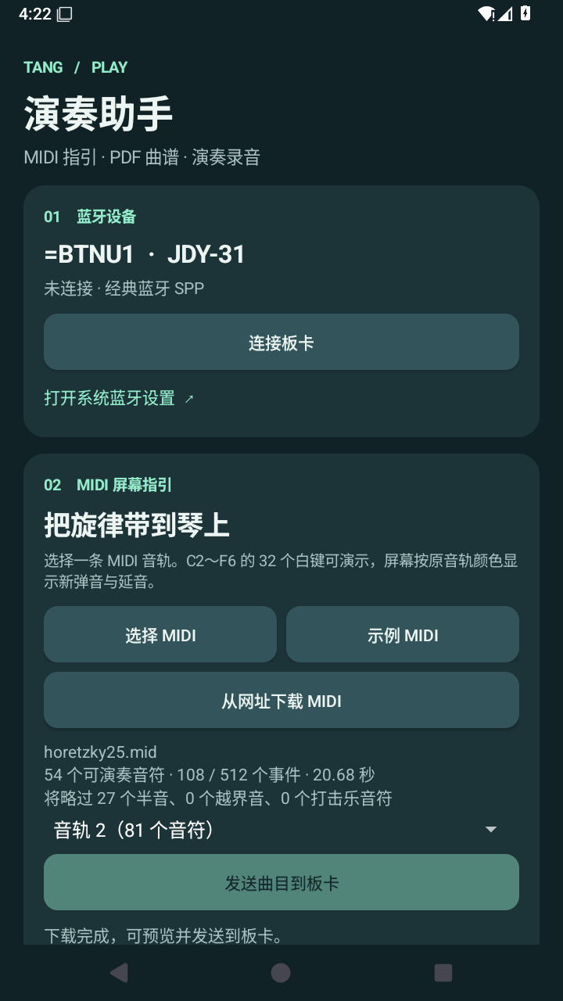
realtime_synth/android_recorder/tests/evidence/online-midi-android35.png
