Lonelyrockroll/qiansai/realtime_synth/android_recorder/tests/evidence/online-pdf-android35.png

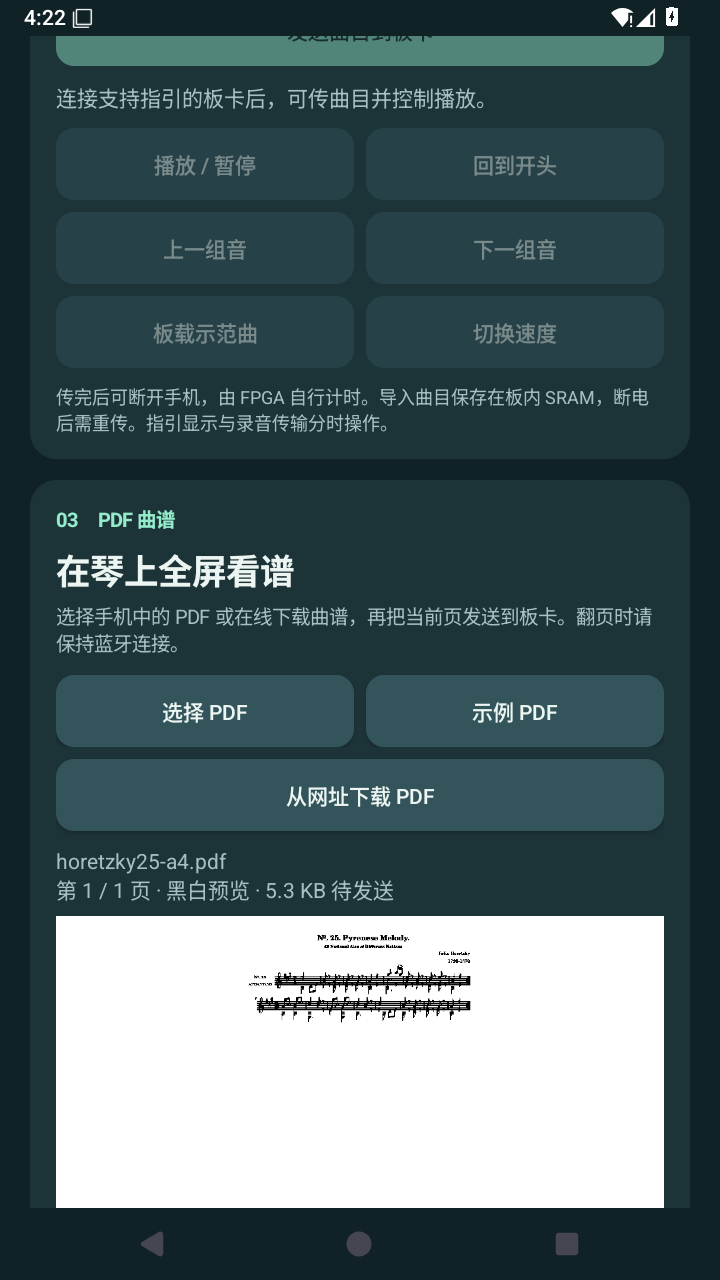
realtime_synth/android_recorder/tests/evidence/online-pdf-android35.png
