Lonelyrockroll/qiansai/realtime_synth/throughput_eval/experiments/modal32/board_C4_20261101/c4_peaks.png

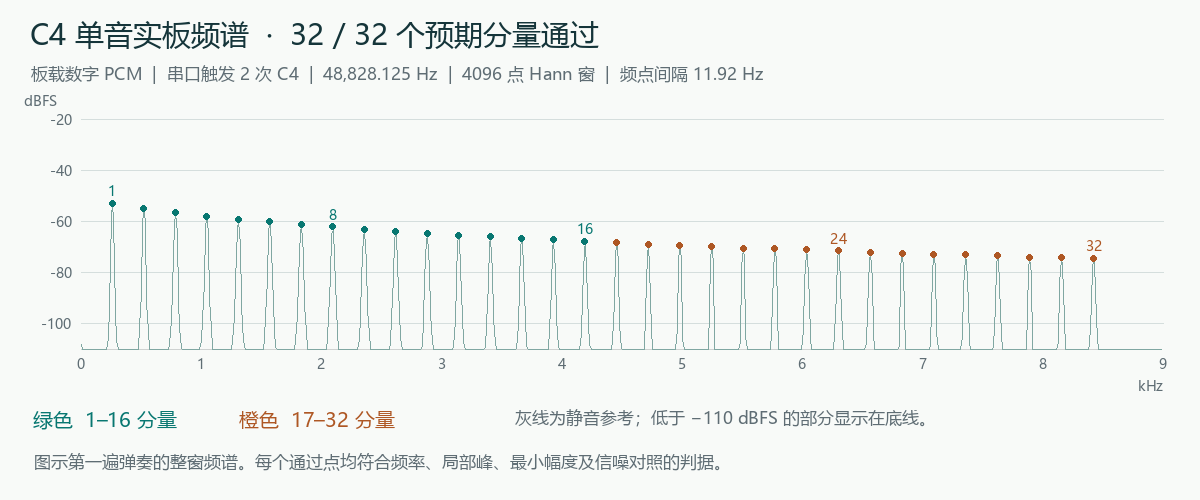
realtime_synth/throughput_eval/experiments/modal32/board_C4_20261101/c4_peaks.png
