Lonelyrockroll/qiansai/tests/expression/results/panel.png

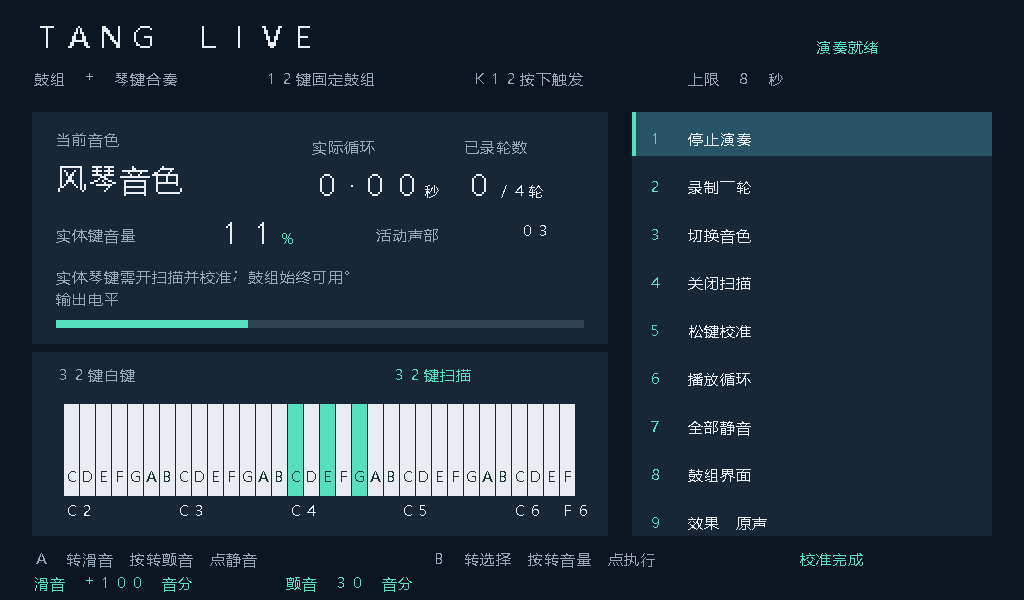
tests/expression/results/panel.png
