Lonelyrockroll/qiansai/tests/guide_ui/results/hierarchical/drums.png

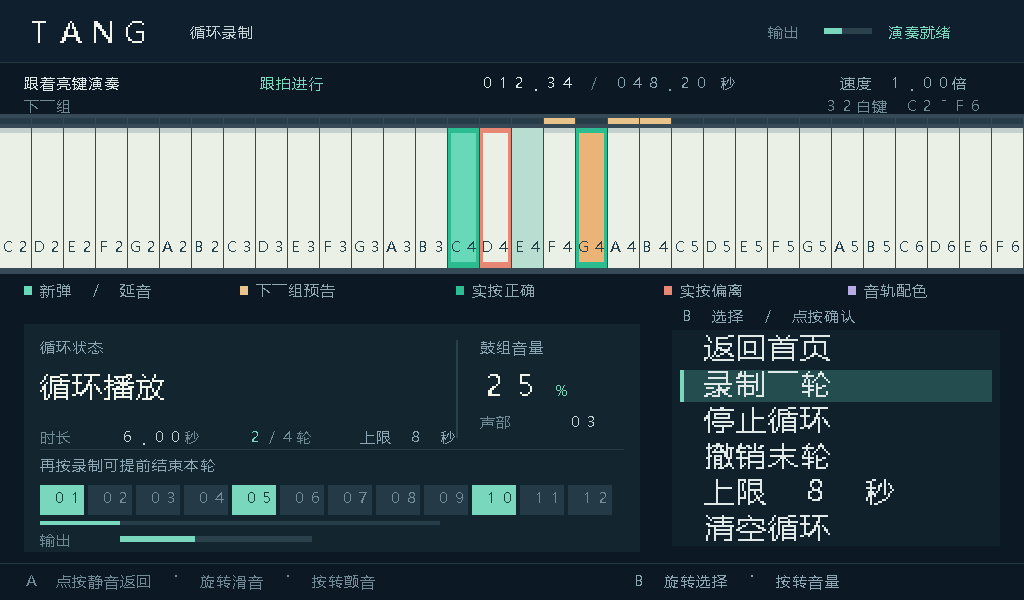
tests/guide_ui/results/hierarchical/drums.png
