Lonelyrockroll/qiansai/tests/guide_ui/results/hierarchical/loop_confirm.png

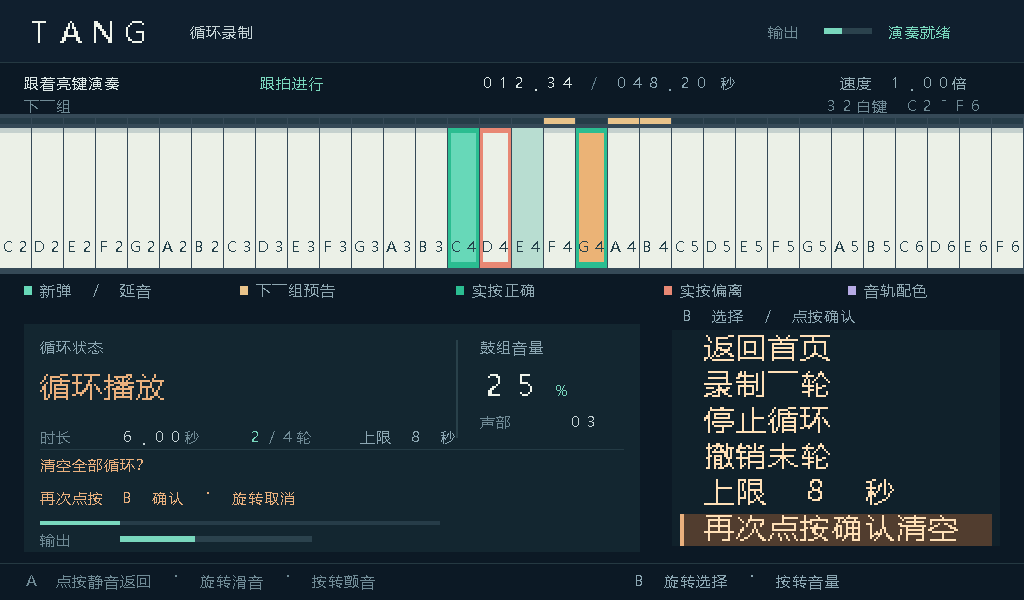
tests/guide_ui/results/hierarchical/loop_confirm.png
