Lonelyrockroll/qiansai/tests/latency_ui/results/live-digital.png

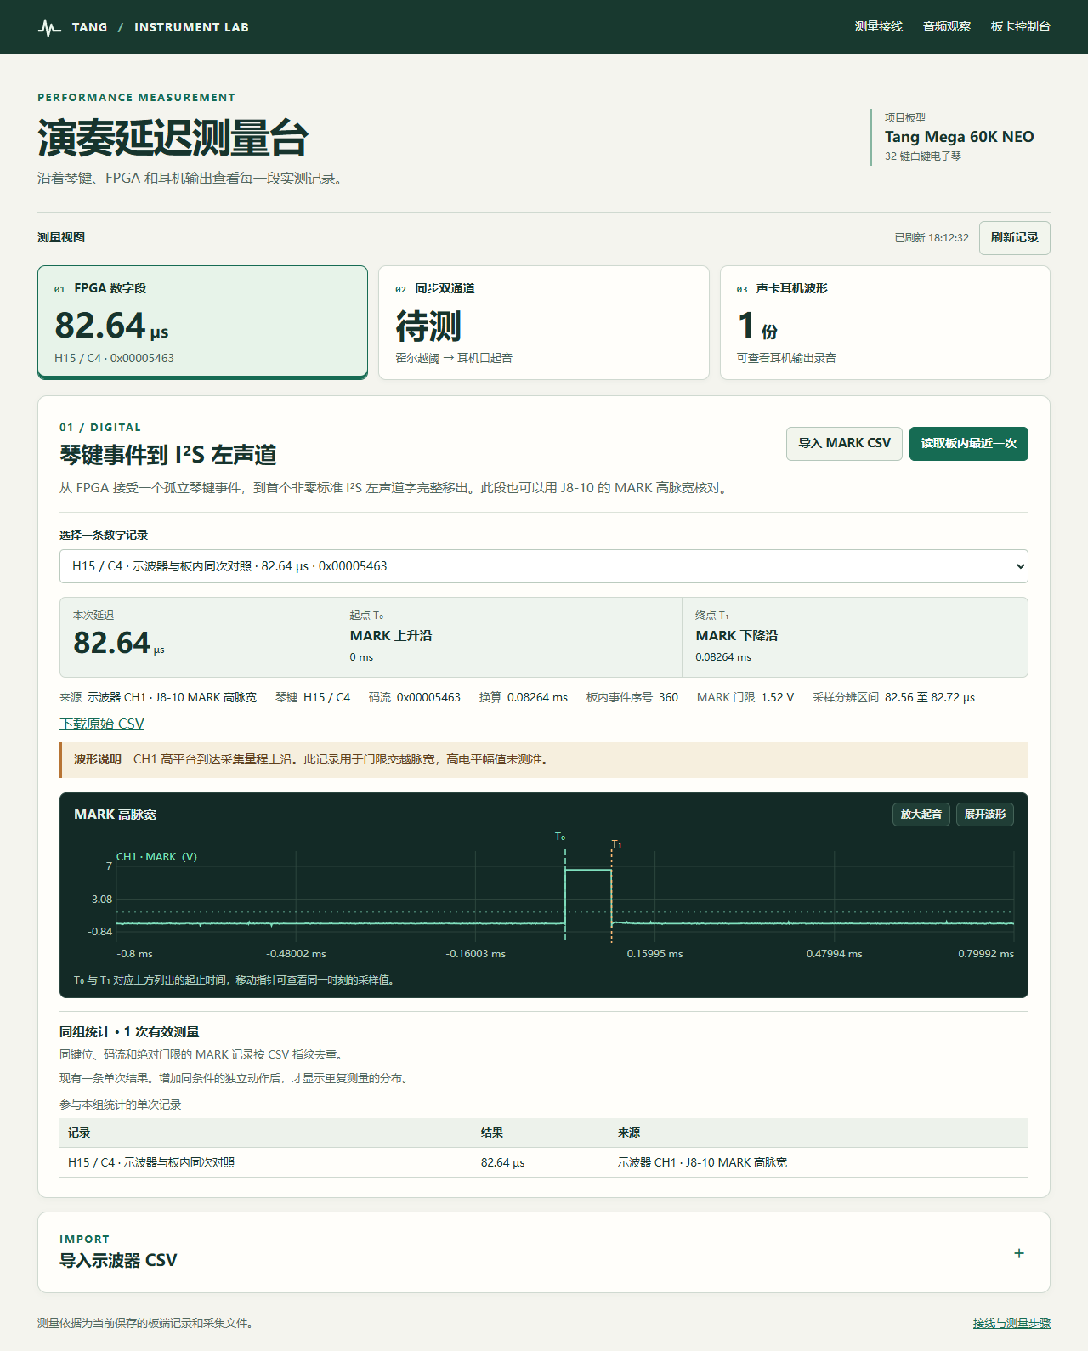
tests/latency_ui/results/live-digital.png
