Lonelyrockroll/qiansai/tests/latency_ui/results/live-mark-focus.png

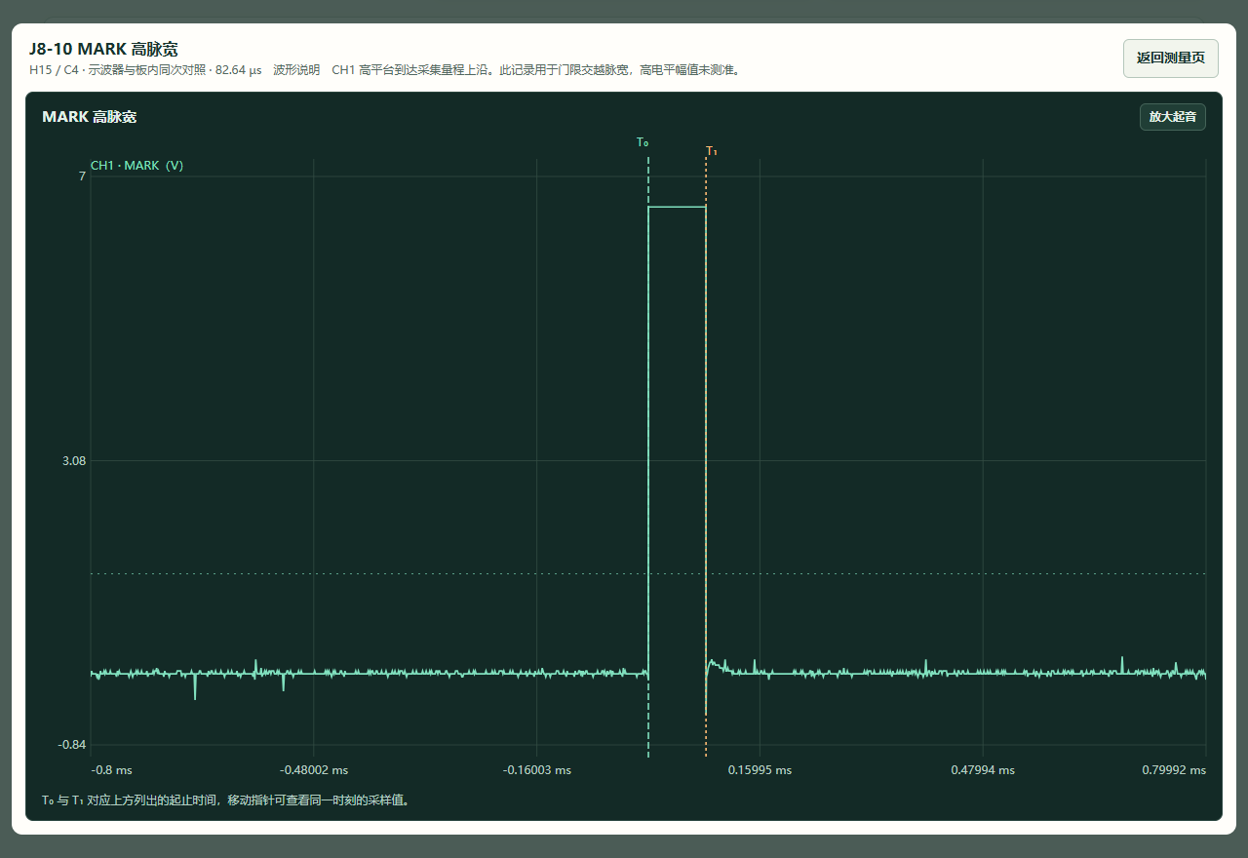
tests/latency_ui/results/live-mark-focus.png
