Lonelyrockroll/qiansai/tests/latency_ui/results/mobile-fixture.png

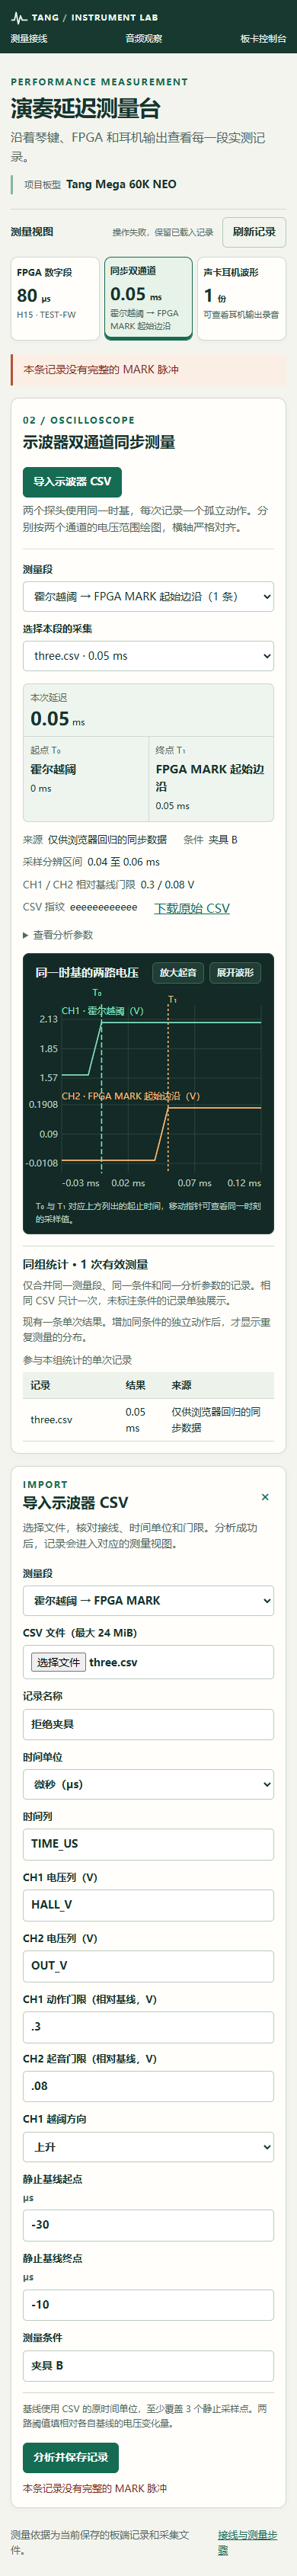
tests/latency_ui/results/mobile-fixture.png
