Lonelyrockroll/qiansai/tests/latency_ui/results/scope-fixture.png

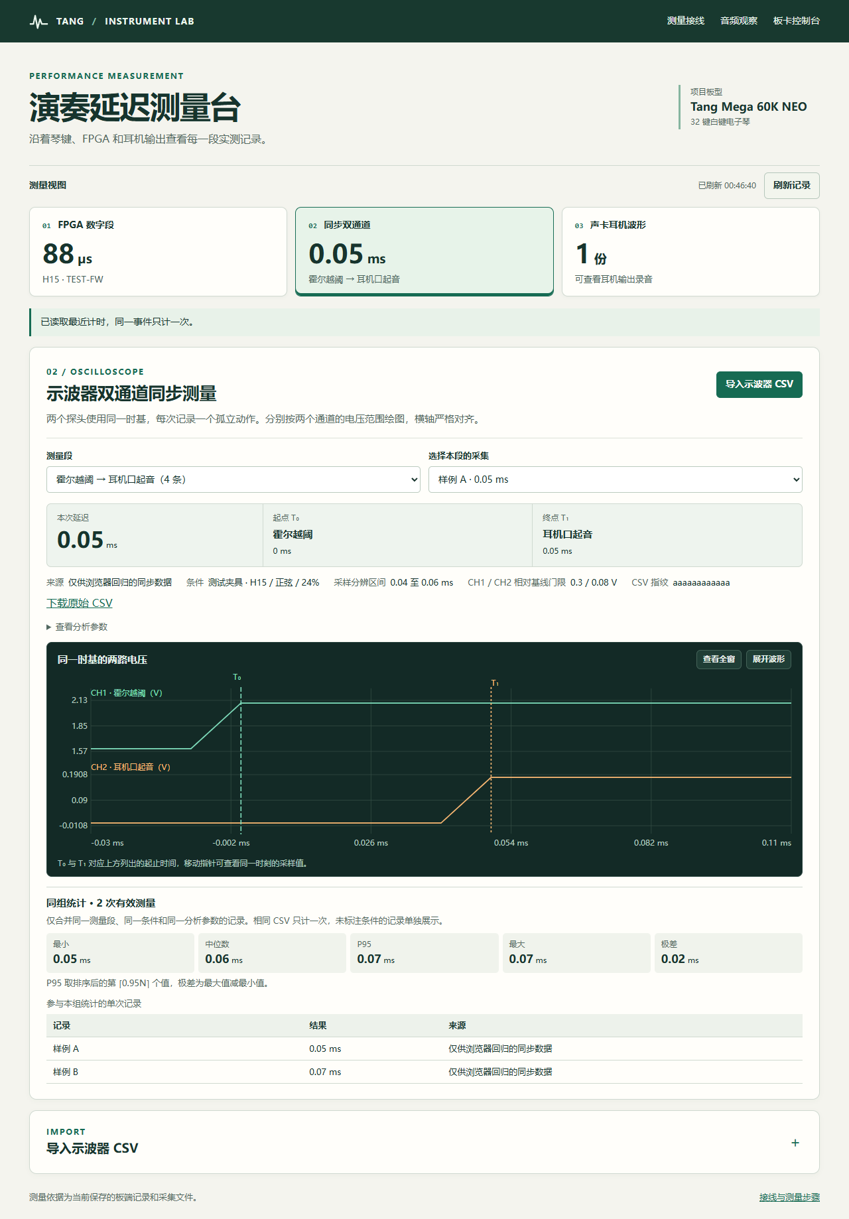
tests/latency_ui/results/scope-fixture.png
