Lonelyrockroll/qiansai/tests/monitor/results/test31.png

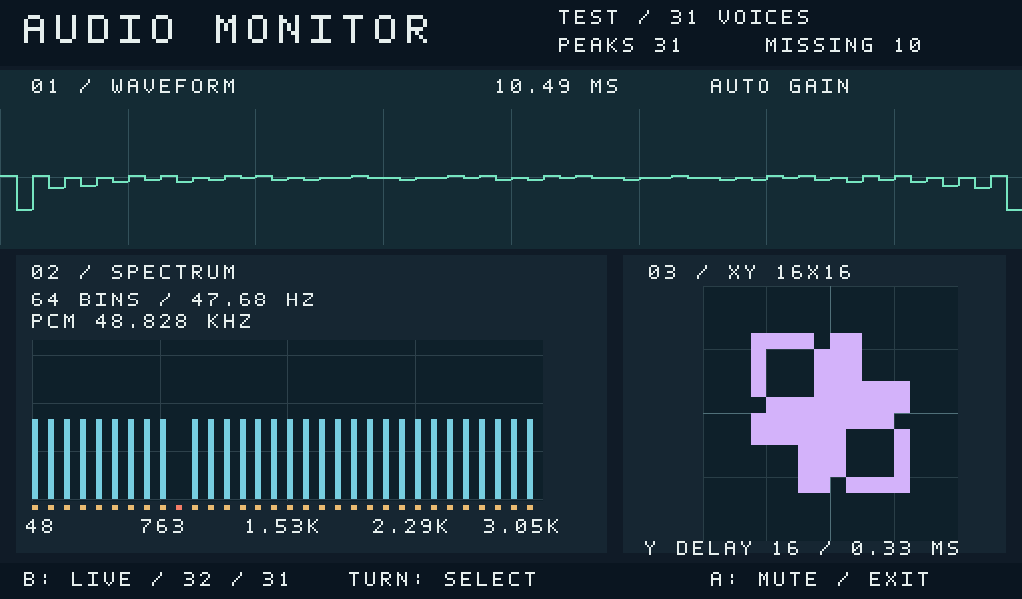
tests/monitor/results/test31.png
