Lonelyrockroll/qiansai/tests/monitor/results/tone.png

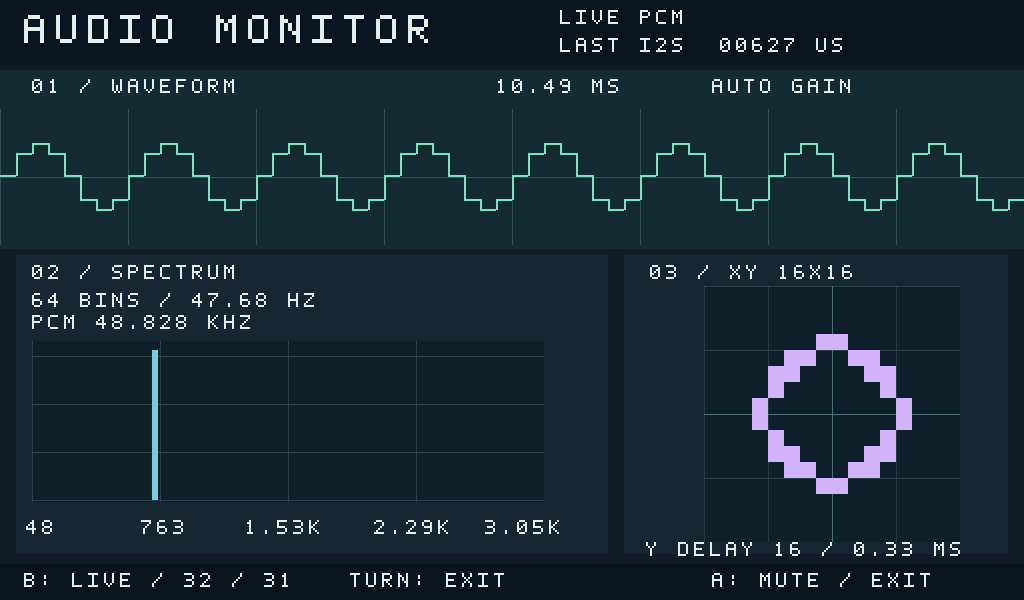
tests/monitor/results/tone.png
