Lonelyrockroll/qiansai/tests/output_trim/results/harmonics.png

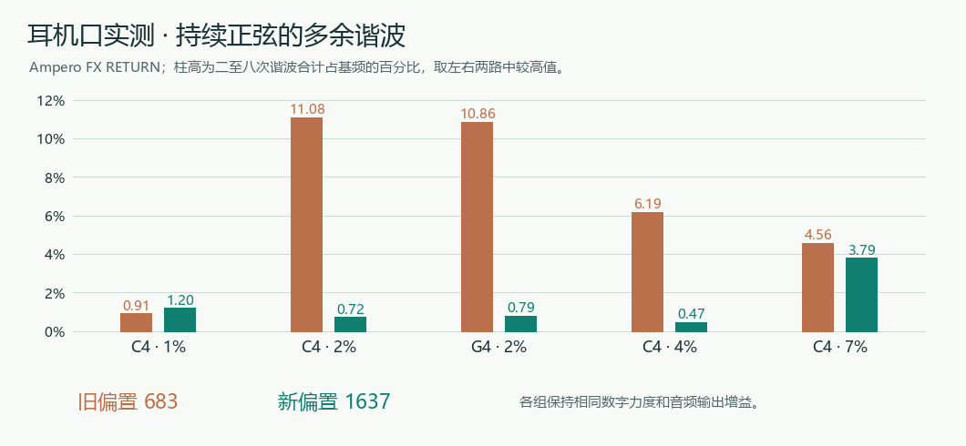
tests/output_trim/results/harmonics.png
