Lonelyrockroll/qiansai/tests/pc_analysis/results/all32/analysis.png

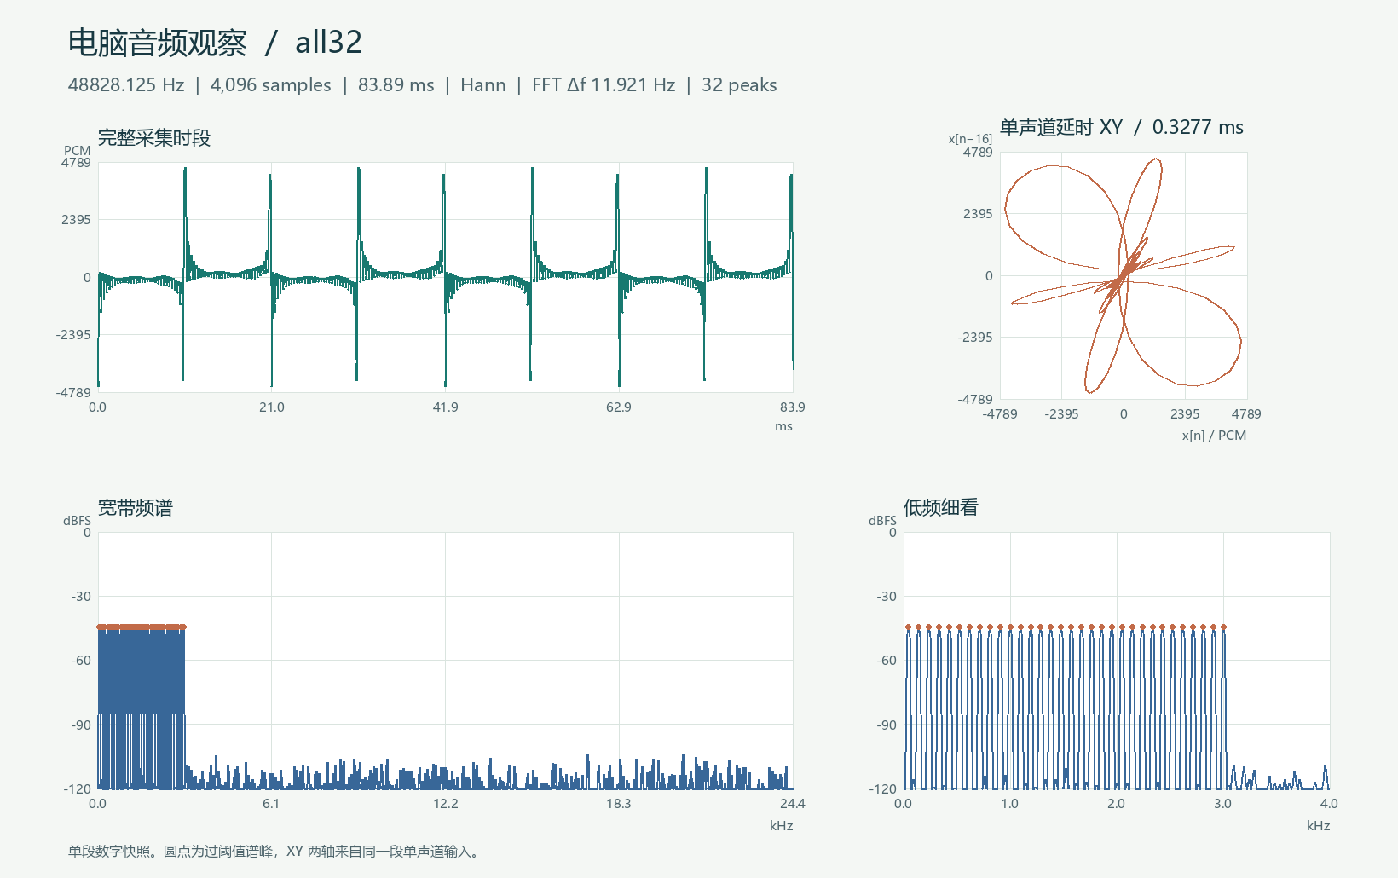
tests/pc_analysis/results/all32/analysis.png
