Lonelyrockroll/qiansai/tests/pc_analysis/results/browser-board-file.png

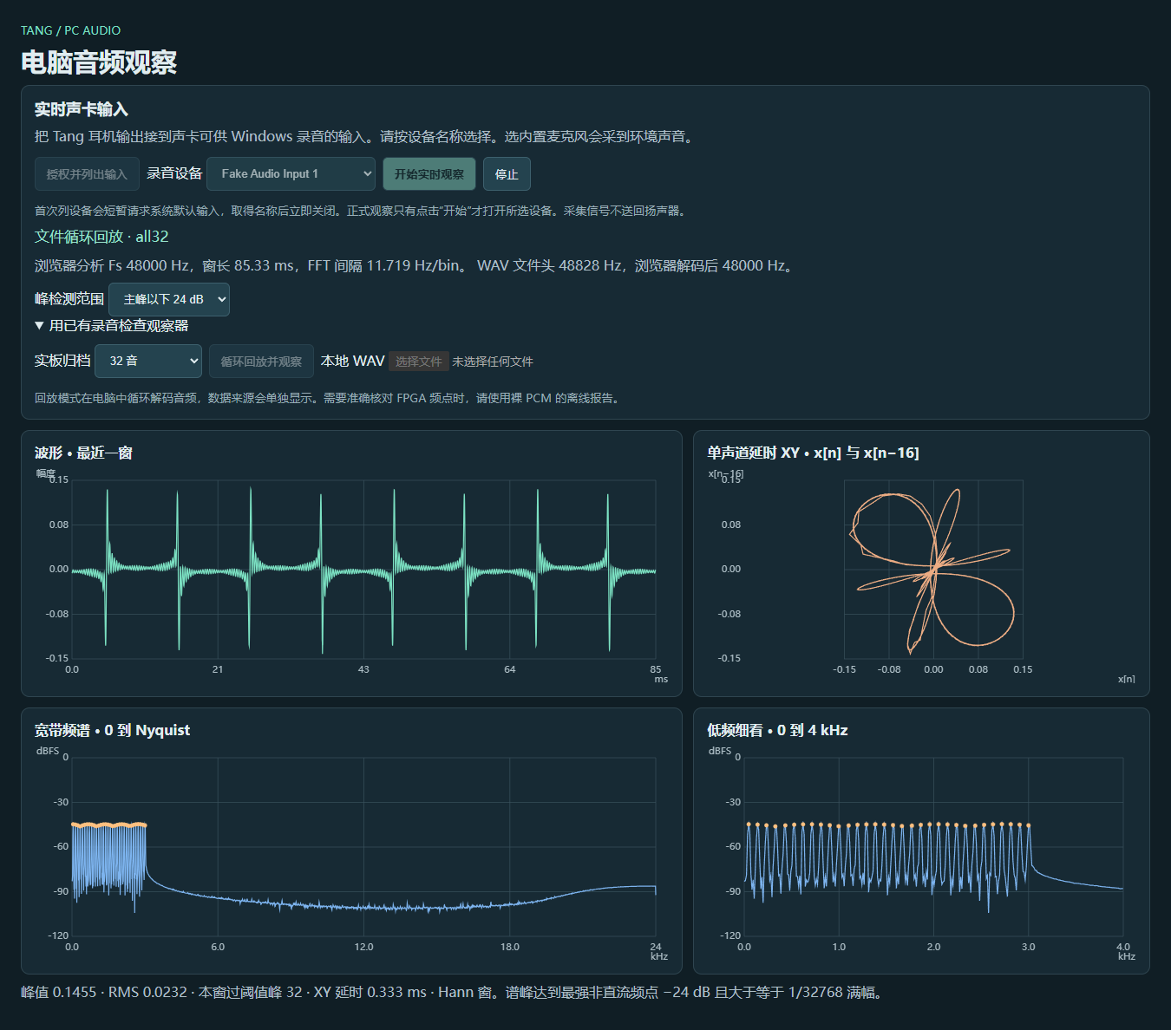
tests/pc_analysis/results/browser-board-file.png
