Lonelyrockroll/qiansai/tests/pc_analysis/results/browser-synthetic-input.png

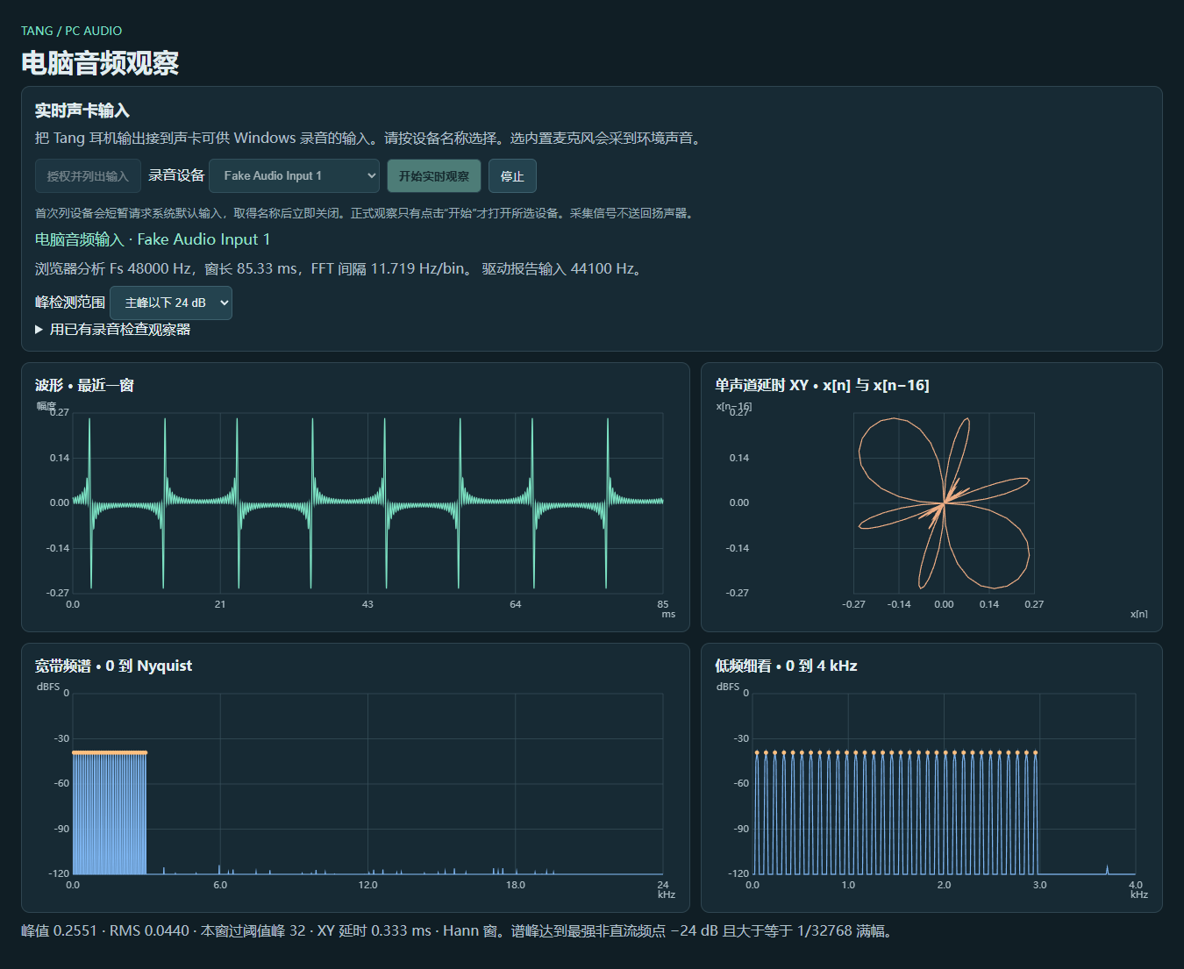
tests/pc_analysis/results/browser-synthetic-input.png
