Lonelyrockroll/qiansai/tests/pc_analysis/results/off16/analysis.png

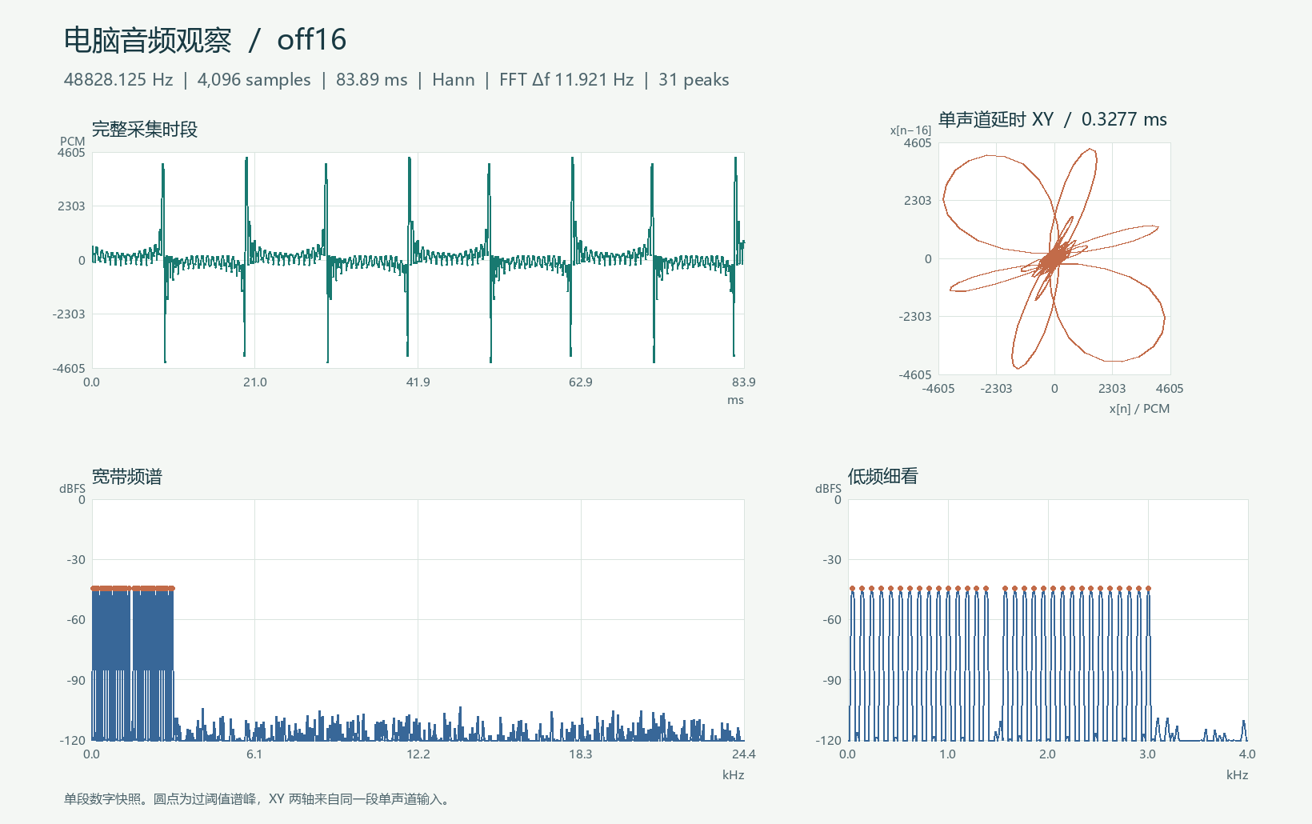
tests/pc_analysis/results/off16/analysis.png
