Lonelyrockroll/qiansai/tests/pc_analysis/results/off17/analysis.png

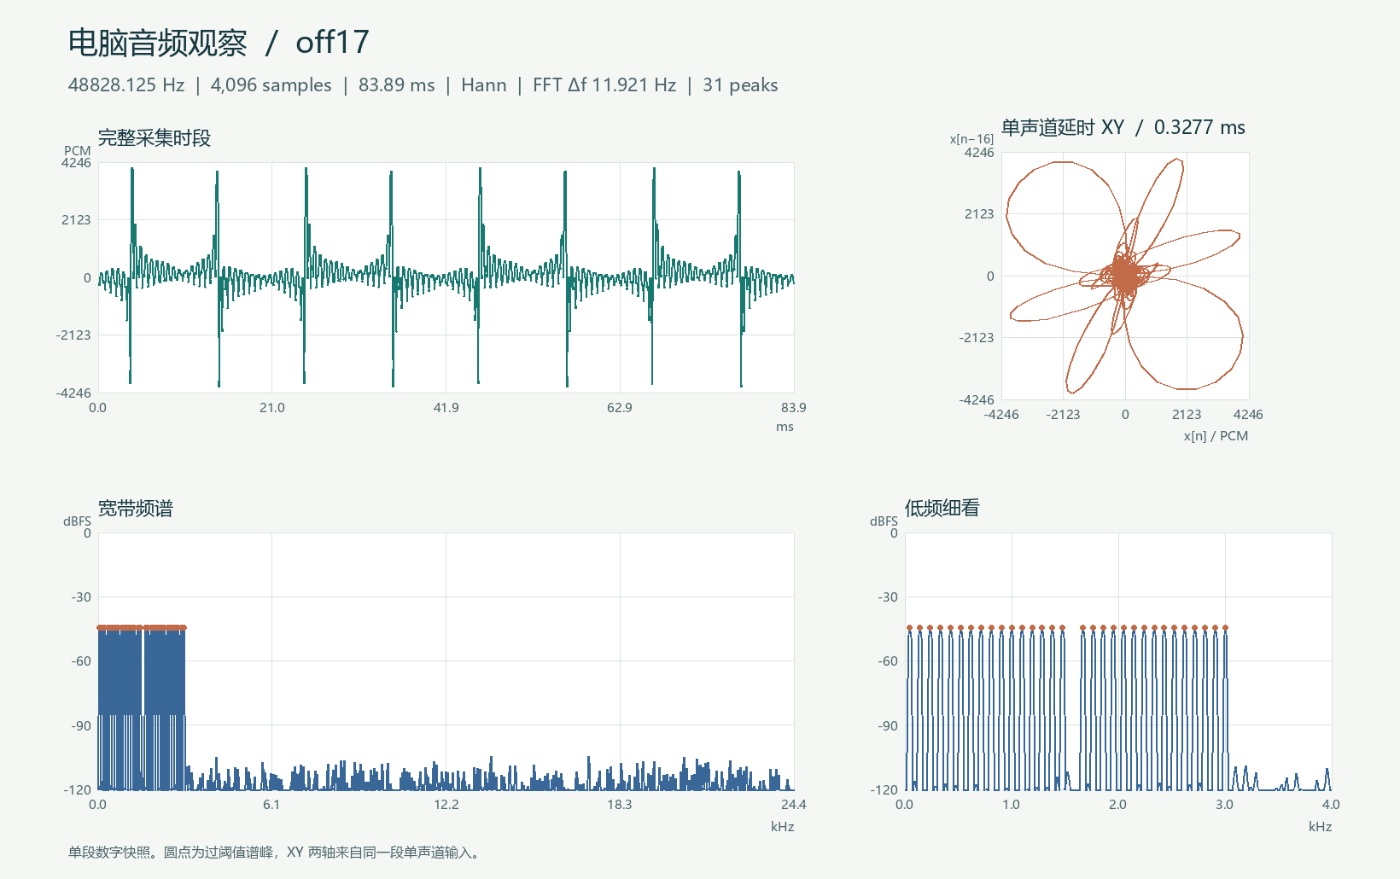
tests/pc_analysis/results/off17/analysis.png
