Lonelyrockroll/qiansai/tests/score_fpga/board_20261102/phone-page-02.png

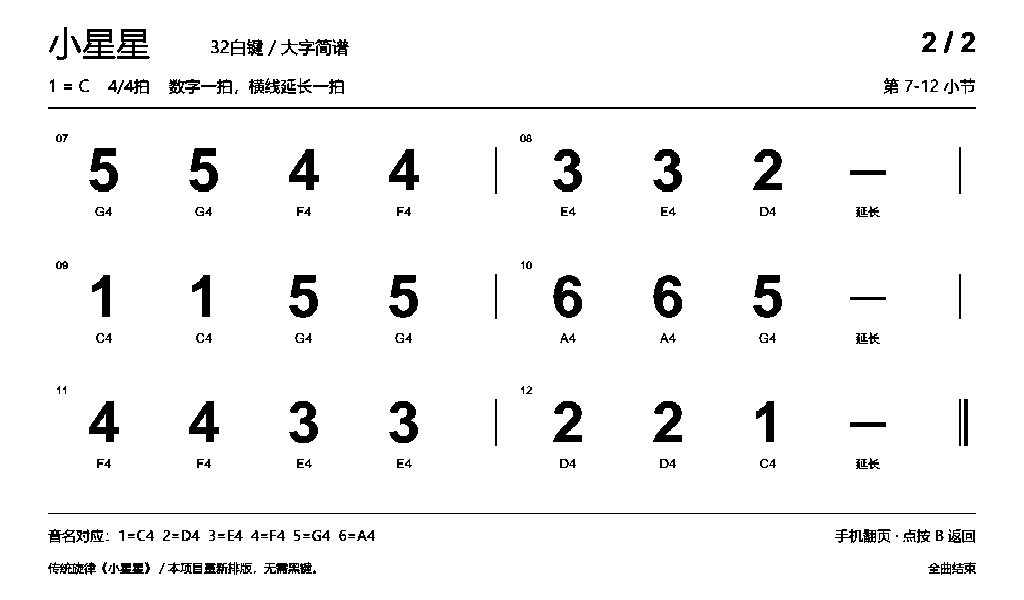
tests/score_fpga/board_20261102/phone-page-02.png
