Lonelyrockroll/qiansai/fpga/piano_modal_tables_compact.v

// Generated analytic modal coefficients; not recorded PCM.
module piano_modal_tables(input wire [2:0] band,input wire [1:0] group,
output wire [73:0] c0,c1,c2,c3);
function [73:0] coeff; input [6:0] address; begin case(address)
7'd0: coeff=74'h04000054085f7e12000;
7'd1: coeff=74'h0800c440f0540a111ec;
7'd2: coeff=74'h0c03102ea844c2114a4;
7'd3: coeff=74'h1007ac19982afa1011f;
7'd4: coeff=74'h140f540efc1ca5f1614;
7'd5: coeff=74'h181ad008c41319f035c;
7'd6: coeff=74'h1c2ae003d8098df070a;
7'd7: coeff=74'h20404003380915ef28f;
7'd8: coeff=74'h245bb001ec0635d1571;
7'd9: coeff=74'h287dec012c044dd007b;
7'd10: coeff=74'h2ca7ac00bc0311cf452;
7'd11: coeff=74'h30d9ac007c024dcf68f;
7'd12: coeff=74'h0400e4127c15023503d;
7'd13: coeff=74'h07ff580e48127e33229;
7'd14: coeff=74'h0c06180a440f22324e1;
7'd15: coeff=74'h10045c05a009763215c;
7'd16: coeff=74'h04000054085f7e11000;
7'd17: coeff=74'h08006840f0540a101ec;
7'd18: coeff=74'h0c01982ea844c1f34a4;
7'd19: coeff=74'h1003fc19982af9f111f;
7'd20: coeff=74'h1407fc0efc1ca5f0614;
7'd21: coeff=74'h180df408c41319ef35c;
7'd22: coeff=74'h1c165403d8098dd270a;
7'd23: coeff=74'h20217803380915d028f;
7'd24: coeff=74'h242fcc01ec0635cf571;
7'd25: coeff=74'h2841ac012c044dcf07b;
7'd26: coeff=74'h2c578400bc0311ce452;
7'd27: coeff=74'h3071ac007c024db068f;
7'd28: coeff=74'h0400e4127c15023303d;
7'd29: coeff=74'h07fefc0e48127e32229;
7'd30: coeff=74'h0c049c0a440f22324e1;
7'd31: coeff=74'h1000ac05a009763115c;
7'd32: coeff=74'h04000054085f7df3000;
7'd33: coeff=74'h08005040f05409f11ec;
7'd34: coeff=74'h0c013c2ea844c1f04a4;
7'd35: coeff=74'h10031419982af9ef11f;
7'd36: coeff=74'h1406240efc1ca5d2614;
7'd37: coeff=74'h180abc08c41319d035c;
7'd38: coeff=74'h1c113003d8098dcf70a;
7'd39: coeff=74'h2019c403380915cf28f;
7'd40: coeff=74'h2424c801ec0635b3571;
7'd41: coeff=74'h283290012c044db007b;
7'd42: coeff=74'h2c436000bc0311af452;
7'd43: coeff=74'h305788007c024dae68f;
7'd44: coeff=74'h0400e4127c15023203d;
7'd45: coeff=74'h07fee40e48127e31229;
7'd46: coeff=74'h0c04400a440f22154e1;
7'd47: coeff=74'h0fffc005a009761315c;
7'd48: coeff=74'h04000054085f7df0000;
7'd49: coeff=74'h08008c40f05409ef1ec;
7'd50: coeff=74'h0c02342ea844c1d24a4;
7'd51: coeff=74'h10058819982af9d011f;
7'd52: coeff=74'h140b0c0efc1ca5cf614;
7'd53: coeff=74'h18135008c41319ce35c;
7'd54: coeff=74'h1c1ee403d8098db170a;
7'd55: coeff=74'h202e5003380915af28f;
7'd56: coeff=74'h24421c01ec0635ae571;
7'd57: coeff=74'h285ad0012c044dae07b;
7'd58: coeff=74'h2c78fc00bc0311ad452;
7'd59: coeff=74'h309d1c007c024d8f68f;
7'd60: coeff=74'h0400e4127c15021303d;
7'd61: coeff=74'h07ff240e48127e12229;
7'd62: coeff=74'h0c053c0a440f22114e1;
7'd63: coeff=74'h10023405a009761115c;
7'd64: coeff=74'h04000054085f7dd1000;
7'd65: coeff=74'h08013c40f05409d01ec;
7'd66: coeff=74'h0c04e82ea844c1cf4a4;
7'd67: coeff=74'h100c4419982af9ce11f;
7'd68: coeff=74'h1418800efc1ca5b0614;
7'd69: coeff=74'h182ad808c41319af35c;
7'd70: coeff=74'h1c447403d8098dae70a;
7'd71: coeff=74'h20668803380915ad28f;
7'd72: coeff=74'h24923c01ec063590571;
7'd73: coeff=74'h28c8b4012c044d8e07b;
7'd74: coeff=74'h2d0b1000bc03118d452;
7'd75: coeff=74'h315a68007c024d8d68f;
7'd76: coeff=74'h0400e4127c15021103d;
7'd77: coeff=74'h07ffd00e48127e10229;
7'd78: coeff=74'h0c07f00a440f21f24e1;
7'd79: coeff=74'h1008f005a00975f115c;
7'd80: coeff=74'h04000054085f7dce000;
7'd81: coeff=74'h08031040f05409b11ec;
7'd82: coeff=74'h0c0c402ea844c1af4a4;
7'd83: coeff=74'h101e9419982af9ae11f;
7'd84: coeff=74'h143d040efc1ca5ad614;
7'd85: coeff=74'h186a7c08c413199035c;
7'd86: coeff=74'h1ca9d803d8098d8e70a;
7'd87: coeff=74'h20fddc033809158d28f;
7'd88: coeff=74'h25693001ec06358c571;
7'd89: coeff=74'h29ee70012c044d7107b;
7'd90: coeff=74'h2e901000bc03116e452;
7'd91: coeff=74'h33506c007c024d6d68f;
7'd92: coeff=74'h0400e4127c1501f103d;
7'd93: coeff=74'h0801a40e48127df0229;
7'd94: coeff=74'h0c0f480a440f21ef4e1;
7'd95: coeff=74'h101b3c05a00975d315c;
default:coeff=74'd0;endcase end endfunction
assign c0=coeff({band,group,2'd0});assign c1=coeff({band,group,2'd1});
assign c2=coeff({band,group,2'd2});assign c3=coeff({band,group,2'd3});endmodule

module piano_sine4(input wire clk,input wire [11:0] a0,a1,a2,a3,
output wire signed [15:0] y0,y1,y2,y3);
reg signed [15:0] lut[0:1023];initial begin
lut[0]=16'h0000;
lut[1]=16'h0032;
lut[2]=16'h0065;
lut[3]=16'h0097;
lut[4]=16'h00c9;
lut[5]=16'h00fb;
lut[6]=16'h012e;
lut[7]=16'h0160;
lut[8]=16'h0192;
lut[9]=16'h01c4;
lut[10]=16'h01f7;
lut[11]=16'h0229;
lut[12]=16'h025b;
lut[13]=16'h028d;
lut[14]=16'h02c0;
lut[15]=16'h02f2;
lut[16]=16'h0324;
lut[17]=16'h0356;
lut[18]=16'h0389;
lut[19]=16'h03bb;
lut[20]=16'h03ed;
lut[21]=16'h041f;
lut[22]=16'h0452;
lut[23]=16'h0484;
lut[24]=16'h04b6;
lut[25]=16'h04e8;
lut[26]=16'h051b;
lut[27]=16'h054d;
lut[28]=16'h057f;
lut[29]=16'h05b1;
lut[30]=16'h05e3;
lut[31]=16'h0616;
lut[32]=16'h0648;
lut[33]=16'h067a;
lut[34]=16'h06ac;
lut[35]=16'h06de;
lut[36]=16'h0711;
lut[37]=16'h0743;
lut[38]=16'h0775;
lut[39]=16'h07a7;
lut[40]=16'h07d9;
lut[41]=16'h080b;
lut[42]=16'h083e;
lut[43]=16'h0870;
lut[44]=16'h08a2;
lut[45]=16'h08d4;
lut[46]=16'h0906;
lut[47]=16'h0938;
lut[48]=16'h096a;
lut[49]=16'h099d;
lut[50]=16'h09cf;
lut[51]=16'h0a01;
lut[52]=16'h0a33;
lut[53]=16'h0a65;
lut[54]=16'h0a97;
lut[55]=16'h0ac9;
lut[56]=16'h0afb;
lut[57]=16'h0b2d;
lut[58]=16'h0b5f;
lut[59]=16'h0b92;
lut[60]=16'h0bc4;
lut[61]=16'h0bf6;
lut[62]=16'h0c28;
lut[63]=16'h0c5a;
lut[64]=16'h0c8c;
lut[65]=16'h0cbe;
lut[66]=16'h0cf0;
lut[67]=16'h0d22;
lut[68]=16'h0d54;
lut[69]=16'h0d86;
lut[70]=16'h0db8;
lut[71]=16'h0dea;
lut[72]=16'h0e1c;
lut[73]=16'h0e4e;
lut[74]=16'h0e80;
lut[75]=16'h0eb1;
lut[76]=16'h0ee3;
lut[77]=16'h0f15;
lut[78]=16'h0f47;
lut[79]=16'h0f79;
lut[80]=16'h0fab;
lut[81]=16'h0fdd;
lut[82]=16'h100f;
lut[83]=16'h1041;
lut[84]=16'h1072;
lut[85]=16'h10a4;
lut[86]=16'h10d6;
lut[87]=16'h1108;
lut[88]=16'h113a;
lut[89]=16'h116c;
lut[90]=16'h119d;
lut[91]=16'h11cf;
lut[92]=16'h1201;
lut[93]=16'h1233;
lut[94]=16'h1264;
lut[95]=16'h1296;
lut[96]=16'h12c8;
lut[97]=16'h12fa;
lut[98]=16'h132b;
lut[99]=16'h135d;
lut[100]=16'h138f;
lut[101]=16'h13c0;
lut[102]=16'h13f2;
lut[103]=16'h1424;
lut[104]=16'h1455;
lut[105]=16'h1487;
lut[106]=16'h14b9;
lut[107]=16'h14ea;
lut[108]=16'h151c;
lut[109]=16'h154d;
lut[110]=16'h157f;
lut[111]=16'h15b0;
lut[112]=16'h15e2;
lut[113]=16'h1613;
lut[114]=16'h1645;
lut[115]=16'h1676;
lut[116]=16'h16a8;
lut[117]=16'h16d9;
lut[118]=16'h170b;
lut[119]=16'h173c;
lut[120]=16'h176e;
lut[121]=16'h179f;
lut[122]=16'h17d0;
lut[123]=16'h1802;
lut[124]=16'h1833;
lut[125]=16'h1865;
lut[126]=16'h1896;
lut[127]=16'h18c7;
lut[128]=16'h18f9;
lut[129]=16'h192a;
lut[130]=16'h195b;
lut[131]=16'h198c;
lut[132]=16'h19be;
lut[133]=16'h19ef;
lut[134]=16'h1a20;
lut[135]=16'h1a51;
lut[136]=16'h1a82;
lut[137]=16'h1ab4;
lut[138]=16'h1ae5;
lut[139]=16'h1b16;
lut[140]=16'h1b47;
lut[141]=16'h1b78;
lut[142]=16'h1ba9;
lut[143]=16'h1bda;
lut[144]=16'h1c0b;
lut[145]=16'h1c3c;
lut[146]=16'h1c6d;
lut[147]=16'h1c9e;
lut[148]=16'h1ccf;
lut[149]=16'h1d00;
lut[150]=16'h1d31;
lut[151]=16'h1d62;
lut[152]=16'h1d93;
lut[153]=16'h1dc4;
lut[154]=16'h1df5;
lut[155]=16'h1e26;
lut[156]=16'h1e57;
lut[157]=16'h1e87;
lut[158]=16'h1eb8;
lut[159]=16'h1ee9;
lut[160]=16'h1f1a;
lut[161]=16'h1f4a;
lut[162]=16'h1f7b;
lut[163]=16'h1fac;
lut[164]=16'h1fdd;
lut[165]=16'h200d;
lut[166]=16'h203e;
lut[167]=16'h206f;
lut[168]=16'h209f;
lut[169]=16'h20d0;
lut[170]=16'h2100;
lut[171]=16'h2131;
lut[172]=16'h2161;
lut[173]=16'h2192;
lut[174]=16'h21c2;
lut[175]=16'h21f3;
lut[176]=16'h2223;
lut[177]=16'h2254;
lut[178]=16'h2284;
lut[179]=16'h22b5;
lut[180]=16'h22e5;
lut[181]=16'h2315;
lut[182]=16'h2346;
lut[183]=16'h2376;
lut[184]=16'h23a6;
lut[185]=16'h23d7;
lut[186]=16'h2407;
lut[187]=16'h2437;
lut[188]=16'h2467;
lut[189]=16'h2497;
lut[190]=16'h24c8;
lut[191]=16'h24f8;
lut[192]=16'h2528;
lut[193]=16'h2558;
lut[194]=16'h2588;
lut[195]=16'h25b8;
lut[196]=16'h25e8;
lut[197]=16'h2618;
lut[198]=16'h2648;
lut[199]=16'h2678;
lut[200]=16'h26a8;
lut[201]=16'h26d8;
lut[202]=16'h2708;
lut[203]=16'h2737;
lut[204]=16'h2767;
lut[205]=16'h2797;
lut[206]=16'h27c7;
lut[207]=16'h27f7;
lut[208]=16'h2826;
lut[209]=16'h2856;
lut[210]=16'h2886;
lut[211]=16'h28b5;
lut[212]=16'h28e5;
lut[213]=16'h2915;
lut[214]=16'h2944;
lut[215]=16'h2974;
lut[216]=16'h29a3;
lut[217]=16'h29d3;
lut[218]=16'h2a02;
lut[219]=16'h2a32;
lut[220]=16'h2a61;
lut[221]=16'h2a91;
lut[222]=16'h2ac0;
lut[223]=16'h2af0;
lut[224]=16'h2b1f;
lut[225]=16'h2b4e;
lut[226]=16'h2b7d;
lut[227]=16'h2bad;
lut[228]=16'h2bdc;
lut[229]=16'h2c0b;
lut[230]=16'h2c3a;
lut[231]=16'h2c6a;
lut[232]=16'h2c99;
lut[233]=16'h2cc8;
lut[234]=16'h2cf7;
lut[235]=16'h2d26;
lut[236]=16'h2d55;
lut[237]=16'h2d84;
lut[238]=16'h2db3;
lut[239]=16'h2de2;
lut[240]=16'h2e11;
lut[241]=16'h2e40;
lut[242]=16'h2e6e;
lut[243]=16'h2e9d;
lut[244]=16'h2ecc;
lut[245]=16'h2efb;
lut[246]=16'h2f2a;
lut[247]=16'h2f58;
lut[248]=16'h2f87;
lut[249]=16'h2fb6;
lut[250]=16'h2fe4;
lut[251]=16'h3013;
lut[252]=16'h3041;
lut[253]=16'h3070;
lut[254]=16'h309e;
lut[255]=16'h30cd;
lut[256]=16'h30fb;
lut[257]=16'h312a;
lut[258]=16'h3158;
lut[259]=16'h3187;
lut[260]=16'h31b5;
lut[261]=16'h31e3;
lut[262]=16'h3211;
lut[263]=16'h3240;
lut[264]=16'h326e;
lut[265]=16'h329c;
lut[266]=16'h32ca;
lut[267]=16'h32f8;
lut[268]=16'h3326;
lut[269]=16'h3355;
lut[270]=16'h3383;
lut[271]=16'h33b1;
lut[272]=16'h33df;
lut[273]=16'h340c;
lut[274]=16'h343a;
lut[275]=16'h3468;
lut[276]=16'h3496;
lut[277]=16'h34c4;
lut[278]=16'h34f2;
lut[279]=16'h351f;
lut[280]=16'h354d;
lut[281]=16'h357b;
lut[282]=16'h35a8;
lut[283]=16'h35d6;
lut[284]=16'h3604;
lut[285]=16'h3631;
lut[286]=16'h365f;
lut[287]=16'h368c;
lut[288]=16'h36ba;
lut[289]=16'h36e7;
lut[290]=16'h3715;
lut[291]=16'h3742;
lut[292]=16'h376f;
lut[293]=16'h379c;
lut[294]=16'h37ca;
lut[295]=16'h37f7;
lut[296]=16'h3824;
lut[297]=16'h3851;
lut[298]=16'h387e;
lut[299]=16'h38ab;
lut[300]=16'h38d9;
lut[301]=16'h3906;
lut[302]=16'h3933;
lut[303]=16'h3960;
lut[304]=16'h398c;
lut[305]=16'h39b9;
lut[306]=16'h39e6;
lut[307]=16'h3a13;
lut[308]=16'h3a40;
lut[309]=16'h3a6c;
lut[310]=16'h3a99;
lut[311]=16'h3ac6;
lut[312]=16'h3af2;
lut[313]=16'h3b1f;
lut[314]=16'h3b4c;
lut[315]=16'h3b78;
lut[316]=16'h3ba5;
lut[317]=16'h3bd1;
lut[318]=16'h3bfe;
lut[319]=16'h3c2a;
lut[320]=16'h3c56;
lut[321]=16'h3c83;
lut[322]=16'h3caf;
lut[323]=16'h3cdb;
lut[324]=16'h3d07;
lut[325]=16'h3d33;
lut[326]=16'h3d60;
lut[327]=16'h3d8c;
lut[328]=16'h3db8;
lut[329]=16'h3de4;
lut[330]=16'h3e10;
lut[331]=16'h3e3c;
lut[332]=16'h3e68;
lut[333]=16'h3e93;
lut[334]=16'h3ebf;
lut[335]=16'h3eeb;
lut[336]=16'h3f17;
lut[337]=16'h3f43;
lut[338]=16'h3f6e;
lut[339]=16'h3f9a;
lut[340]=16'h3fc5;
lut[341]=16'h3ff1;
lut[342]=16'h401d;
lut[343]=16'h4048;
lut[344]=16'h4073;
lut[345]=16'h409f;
lut[346]=16'h40ca;
lut[347]=16'h40f6;
lut[348]=16'h4121;
lut[349]=16'h414c;
lut[350]=16'h4177;
lut[351]=16'h41a2;
lut[352]=16'h41ce;
lut[353]=16'h41f9;
lut[354]=16'h4224;
lut[355]=16'h424f;
lut[356]=16'h427a;
lut[357]=16'h42a5;
lut[358]=16'h42d0;
lut[359]=16'h42fa;
lut[360]=16'h4325;
lut[361]=16'h4350;
lut[362]=16'h437b;
lut[363]=16'h43a5;
lut[364]=16'h43d0;
lut[365]=16'h43fb;
lut[366]=16'h4425;
lut[367]=16'h4450;
lut[368]=16'h447a;
lut[369]=16'h44a5;
lut[370]=16'h44cf;
lut[371]=16'h44f9;
lut[372]=16'h4524;
lut[373]=16'h454e;
lut[374]=16'h4578;
lut[375]=16'h45a3;
lut[376]=16'h45cd;
lut[377]=16'h45f7;
lut[378]=16'h4621;
lut[379]=16'h464b;
lut[380]=16'h4675;
lut[381]=16'h469f;
lut[382]=16'h46c9;
lut[383]=16'h46f3;
lut[384]=16'h471c;
lut[385]=16'h4746;
lut[386]=16'h4770;
lut[387]=16'h479a;
lut[388]=16'h47c3;
lut[389]=16'h47ed;
lut[390]=16'h4816;
lut[391]=16'h4840;
lut[392]=16'h4869;
lut[393]=16'h4893;
lut[394]=16'h48bc;
lut[395]=16'h48e5;
lut[396]=16'h490f;
lut[397]=16'h4938;
lut[398]=16'h4961;
lut[399]=16'h498a;
lut[400]=16'h49b4;
lut[401]=16'h49dd;
lut[402]=16'h4a06;
lut[403]=16'h4a2f;
lut[404]=16'h4a58;
lut[405]=16'h4a80;
lut[406]=16'h4aa9;
lut[407]=16'h4ad2;
lut[408]=16'h4afb;
lut[409]=16'h4b24;
lut[410]=16'h4b4c;
lut[411]=16'h4b75;
lut[412]=16'h4b9d;
lut[413]=16'h4bc6;
lut[414]=16'h4bee;
lut[415]=16'h4c17;
lut[416]=16'h4c3f;
lut[417]=16'h4c68;
lut[418]=16'h4c90;
lut[419]=16'h4cb8;
lut[420]=16'h4ce0;
lut[421]=16'h4d09;
lut[422]=16'h4d31;
lut[423]=16'h4d59;
lut[424]=16'h4d81;
lut[425]=16'h4da9;
lut[426]=16'h4dd1;
lut[427]=16'h4df9;
lut[428]=16'h4e20;
lut[429]=16'h4e48;
lut[430]=16'h4e70;
lut[431]=16'h4e98;
lut[432]=16'h4ebf;
lut[433]=16'h4ee7;
lut[434]=16'h4f0e;
lut[435]=16'h4f36;
lut[436]=16'h4f5d;
lut[437]=16'h4f85;
lut[438]=16'h4fac;
lut[439]=16'h4fd4;
lut[440]=16'h4ffb;
lut[441]=16'h5022;
lut[442]=16'h5049;
lut[443]=16'h5070;
lut[444]=16'h5097;
lut[445]=16'h50be;
lut[446]=16'h50e5;
lut[447]=16'h510c;
lut[448]=16'h5133;
lut[449]=16'h515a;
lut[450]=16'h5181;
lut[451]=16'h51a8;
lut[452]=16'h51ce;
lut[453]=16'h51f5;
lut[454]=16'h521b;
lut[455]=16'h5242;
lut[456]=16'h5268;
lut[457]=16'h528f;
lut[458]=16'h52b5;
lut[459]=16'h52dc;
lut[460]=16'h5302;
lut[461]=16'h5328;
lut[462]=16'h534e;
lut[463]=16'h5374;
lut[464]=16'h539b;
lut[465]=16'h53c1;
lut[466]=16'h53e7;
lut[467]=16'h540c;
lut[468]=16'h5432;
lut[469]=16'h5458;
lut[470]=16'h547e;
lut[471]=16'h54a4;
lut[472]=16'h54c9;
lut[473]=16'h54ef;
lut[474]=16'h5515;
lut[475]=16'h553a;
lut[476]=16'h5560;
lut[477]=16'h5585;
lut[478]=16'h55aa;
lut[479]=16'h55d0;
lut[480]=16'h55f5;
lut[481]=16'h561a;
lut[482]=16'h563f;
lut[483]=16'h5664;
lut[484]=16'h568a;
lut[485]=16'h56af;
lut[486]=16'h56d3;
lut[487]=16'h56f8;
lut[488]=16'h571d;
lut[489]=16'h5742;
lut[490]=16'h5767;
lut[491]=16'h578b;
lut[492]=16'h57b0;
lut[493]=16'h57d5;
lut[494]=16'h57f9;
lut[495]=16'h581e;
lut[496]=16'h5842;
lut[497]=16'h5867;
lut[498]=16'h588b;
lut[499]=16'h58af;
lut[500]=16'h58d3;
lut[501]=16'h58f8;
lut[502]=16'h591c;
lut[503]=16'h5940;
lut[504]=16'h5964;
lut[505]=16'h5988;
lut[506]=16'h59ac;
lut[507]=16'h59cf;
lut[508]=16'h59f3;
lut[509]=16'h5a17;
lut[510]=16'h5a3b;
lut[511]=16'h5a5e;
lut[512]=16'h5a82;
lut[513]=16'h5aa5;
lut[514]=16'h5ac9;
lut[515]=16'h5aec;
lut[516]=16'h5b0f;
lut[517]=16'h5b33;
lut[518]=16'h5b56;
lut[519]=16'h5b79;
lut[520]=16'h5b9c;
lut[521]=16'h5bbf;
lut[522]=16'h5be2;
lut[523]=16'h5c05;
lut[524]=16'h5c28;
lut[525]=16'h5c4b;
lut[526]=16'h5c6e;
lut[527]=16'h5c91;
lut[528]=16'h5cb3;
lut[529]=16'h5cd6;
lut[530]=16'h5cf9;
lut[531]=16'h5d1b;
lut[532]=16'h5d3e;
lut[533]=16'h5d60;
lut[534]=16'h5d82;
lut[535]=16'h5da5;
lut[536]=16'h5dc7;
lut[537]=16'h5de9;
lut[538]=16'h5e0b;
lut[539]=16'h5e2d;
lut[540]=16'h5e4f;
lut[541]=16'h5e71;
lut[542]=16'h5e93;
lut[543]=16'h5eb5;
lut[544]=16'h5ed7;
lut[545]=16'h5ef8;
lut[546]=16'h5f1a;
lut[547]=16'h5f3c;
lut[548]=16'h5f5d;
lut[549]=16'h5f7f;
lut[550]=16'h5fa0;
lut[551]=16'h5fc2;
lut[552]=16'h5fe3;
lut[553]=16'h6004;
lut[554]=16'h6025;
lut[555]=16'h6047;
lut[556]=16'h6068;
lut[557]=16'h6089;
lut[558]=16'h60aa;
lut[559]=16'h60cb;
lut[560]=16'h60eb;
lut[561]=16'h610c;
lut[562]=16'h612d;
lut[563]=16'h614e;
lut[564]=16'h616e;
lut[565]=16'h618f;
lut[566]=16'h61af;
lut[567]=16'h61d0;
lut[568]=16'h61f0;
lut[569]=16'h6211;
lut[570]=16'h6231;
lut[571]=16'h6251;
lut[572]=16'h6271;
lut[573]=16'h6291;
lut[574]=16'h62b1;
lut[575]=16'h62d1;
lut[576]=16'h62f1;
lut[577]=16'h6311;
lut[578]=16'h6331;
lut[579]=16'h6351;
lut[580]=16'h6370;
lut[581]=16'h6390;
lut[582]=16'h63af;
lut[583]=16'h63cf;
lut[584]=16'h63ee;
lut[585]=16'h640e;
lut[586]=16'h642d;
lut[587]=16'h644c;
lut[588]=16'h646c;
lut[589]=16'h648b;
lut[590]=16'h64aa;
lut[591]=16'h64c9;
lut[592]=16'h64e8;
lut[593]=16'h6507;
lut[594]=16'h6525;
lut[595]=16'h6544;
lut[596]=16'h6563;
lut[597]=16'h6582;
lut[598]=16'h65a0;
lut[599]=16'h65bf;
lut[600]=16'h65dd;
lut[601]=16'h65fc;
lut[602]=16'h661a;
lut[603]=16'h6638;
lut[604]=16'h6656;
lut[605]=16'h6675;
lut[606]=16'h6693;
lut[607]=16'h66b1;
lut[608]=16'h66cf;
lut[609]=16'h66ed;
lut[610]=16'h670a;
lut[611]=16'h6728;
lut[612]=16'h6746;
lut[613]=16'h6764;
lut[614]=16'h6781;
lut[615]=16'h679f;
lut[616]=16'h67bc;
lut[617]=16'h67da;
lut[618]=16'h67f7;
lut[619]=16'h6814;
lut[620]=16'h6832;
lut[621]=16'h684f;
lut[622]=16'h686c;
lut[623]=16'h6889;
lut[624]=16'h68a6;
lut[625]=16'h68c3;
lut[626]=16'h68e0;
lut[627]=16'h68fc;
lut[628]=16'h6919;
lut[629]=16'h6936;
lut[630]=16'h6952;
lut[631]=16'h696f;
lut[632]=16'h698b;
lut[633]=16'h69a8;
lut[634]=16'h69c4;
lut[635]=16'h69e0;
lut[636]=16'h69fd;
lut[637]=16'h6a19;
lut[638]=16'h6a35;
lut[639]=16'h6a51;
lut[640]=16'h6a6d;
lut[641]=16'h6a89;
lut[642]=16'h6aa4;
lut[643]=16'h6ac0;
lut[644]=16'h6adc;
lut[645]=16'h6af8;
lut[646]=16'h6b13;
lut[647]=16'h6b2f;
lut[648]=16'h6b4a;
lut[649]=16'h6b65;
lut[650]=16'h6b81;
lut[651]=16'h6b9c;
lut[652]=16'h6bb7;
lut[653]=16'h6bd2;
lut[654]=16'h6bed;
lut[655]=16'h6c08;
lut[656]=16'h6c23;
lut[657]=16'h6c3e;
lut[658]=16'h6c59;
lut[659]=16'h6c74;
lut[660]=16'h6c8e;
lut[661]=16'h6ca9;
lut[662]=16'h6cc3;
lut[663]=16'h6cde;
lut[664]=16'h6cf8;
lut[665]=16'h6d13;
lut[666]=16'h6d2d;
lut[667]=16'h6d47;
lut[668]=16'h6d61;
lut[669]=16'h6d7b;
lut[670]=16'h6d95;
lut[671]=16'h6daf;
lut[672]=16'h6dc9;
lut[673]=16'h6de3;
lut[674]=16'h6dfd;
lut[675]=16'h6e16;
lut[676]=16'h6e30;
lut[677]=16'h6e4a;
lut[678]=16'h6e63;
lut[679]=16'h6e7c;
lut[680]=16'h6e96;
lut[681]=16'h6eaf;
lut[682]=16'h6ec8;
lut[683]=16'h6ee1;
lut[684]=16'h6efb;
lut[685]=16'h6f14;
lut[686]=16'h6f2c;
lut[687]=16'h6f45;
lut[688]=16'h6f5e;
lut[689]=16'h6f77;
lut[690]=16'h6f90;
lut[691]=16'h6fa8;
lut[692]=16'h6fc1;
lut[693]=16'h6fd9;
lut[694]=16'h6ff2;
lut[695]=16'h700a;
lut[696]=16'h7022;
lut[697]=16'h703a;
lut[698]=16'h7053;
lut[699]=16'h706b;
lut[700]=16'h7083;
lut[701]=16'h709b;
lut[702]=16'h70b2;
lut[703]=16'h70ca;
lut[704]=16'h70e2;
lut[705]=16'h70fa;
lut[706]=16'h7111;
lut[707]=16'h7129;
lut[708]=16'h7140;
lut[709]=16'h7158;
lut[710]=16'h716f;
lut[711]=16'h7186;
lut[712]=16'h719d;
lut[713]=16'h71b4;
lut[714]=16'h71cb;
lut[715]=16'h71e2;
lut[716]=16'h71f9;
lut[717]=16'h7210;
lut[718]=16'h7227;
lut[719]=16'h723e;
lut[720]=16'h7254;
lut[721]=16'h726b;
lut[722]=16'h7281;
lut[723]=16'h7298;
lut[724]=16'h72ae;
lut[725]=16'h72c4;
lut[726]=16'h72db;
lut[727]=16'h72f1;
lut[728]=16'h7307;
lut[729]=16'h731d;
lut[730]=16'h7333;
lut[731]=16'h7349;
lut[732]=16'h735e;
lut[733]=16'h7374;
lut[734]=16'h738a;
lut[735]=16'h739f;
lut[736]=16'h73b5;
lut[737]=16'h73ca;
lut[738]=16'h73e0;
lut[739]=16'h73f5;
lut[740]=16'h740a;
lut[741]=16'h7420;
lut[742]=16'h7435;
lut[743]=16'h744a;
lut[744]=16'h745f;
lut[745]=16'h7474;
lut[746]=16'h7488;
lut[747]=16'h749d;
lut[748]=16'h74b2;
lut[749]=16'h74c6;
lut[750]=16'h74db;
lut[751]=16'h74f0;
lut[752]=16'h7504;
lut[753]=16'h7518;
lut[754]=16'h752d;
lut[755]=16'h7541;
lut[756]=16'h7555;
lut[757]=16'h7569;
lut[758]=16'h757d;
lut[759]=16'h7591;
lut[760]=16'h75a5;
lut[761]=16'h75b8;
lut[762]=16'h75cc;
lut[763]=16'h75e0;
lut[764]=16'h75f3;
lut[765]=16'h7607;
lut[766]=16'h761a;
lut[767]=16'h762d;
lut[768]=16'h7641;
lut[769]=16'h7654;
lut[770]=16'h7667;
lut[771]=16'h767a;
lut[772]=16'h768d;
lut[773]=16'h76a0;
lut[774]=16'h76b3;
lut[775]=16'h76c6;
lut[776]=16'h76d8;
lut[777]=16'h76eb;
lut[778]=16'h76fe;
lut[779]=16'h7710;
lut[780]=16'h7722;
lut[781]=16'h7735;
lut[782]=16'h7747;
lut[783]=16'h7759;
lut[784]=16'h776b;
lut[785]=16'h777d;
lut[786]=16'h778f;
lut[787]=16'h77a1;
lut[788]=16'h77b3;
lut[789]=16'h77c5;
lut[790]=16'h77d7;
lut[791]=16'h77e8;
lut[792]=16'h77fa;
lut[793]=16'h780b;
lut[794]=16'h781d;
lut[795]=16'h782e;
lut[796]=16'h783f;
lut[797]=16'h7850;
lut[798]=16'h7862;
lut[799]=16'h7873;
lut[800]=16'h7884;
lut[801]=16'h7894;
lut[802]=16'h78a5;
lut[803]=16'h78b6;
lut[804]=16'h78c7;
lut[805]=16'h78d7;
lut[806]=16'h78e8;
lut[807]=16'h78f8;
lut[808]=16'h7909;
lut[809]=16'h7919;
lut[810]=16'h7929;
lut[811]=16'h7939;
lut[812]=16'h794a;
lut[813]=16'h795a;
lut[814]=16'h796a;
lut[815]=16'h7979;
lut[816]=16'h7989;
lut[817]=16'h7999;
lut[818]=16'h79a9;
lut[819]=16'h79b8;
lut[820]=16'h79c8;
lut[821]=16'h79d7;
lut[822]=16'h79e6;
lut[823]=16'h79f6;
lut[824]=16'h7a05;
lut[825]=16'h7a14;
lut[826]=16'h7a23;
lut[827]=16'h7a32;
lut[828]=16'h7a41;
lut[829]=16'h7a50;
lut[830]=16'h7a5f;
lut[831]=16'h7a6d;
lut[832]=16'h7a7c;
lut[833]=16'h7a8b;
lut[834]=16'h7a99;
lut[835]=16'h7aa8;
lut[836]=16'h7ab6;
lut[837]=16'h7ac4;
lut[838]=16'h7ad2;
lut[839]=16'h7ae0;
lut[840]=16'h7aee;
lut[841]=16'h7afc;
lut[842]=16'h7b0a;
lut[843]=16'h7b18;
lut[844]=16'h7b26;
lut[845]=16'h7b33;
lut[846]=16'h7b41;
lut[847]=16'h7b4f;
lut[848]=16'h7b5c;
lut[849]=16'h7b69;
lut[850]=16'h7b77;
lut[851]=16'h7b84;
lut[852]=16'h7b91;
lut[853]=16'h7b9e;
lut[854]=16'h7bab;
lut[855]=16'h7bb8;
lut[856]=16'h7bc5;
lut[857]=16'h7bd2;
lut[858]=16'h7bde;
lut[859]=16'h7beb;
lut[860]=16'h7bf8;
lut[861]=16'h7c04;
lut[862]=16'h7c10;
lut[863]=16'h7c1d;
lut[864]=16'h7c29;
lut[865]=16'h7c35;
lut[866]=16'h7c41;
lut[867]=16'h7c4d;
lut[868]=16'h7c59;
lut[869]=16'h7c65;
lut[870]=16'h7c71;
lut[871]=16'h7c7d;
lut[872]=16'h7c88;
lut[873]=16'h7c94;
lut[874]=16'h7c9f;
lut[875]=16'h7cab;
lut[876]=16'h7cb6;
lut[877]=16'h7cc1;
lut[878]=16'h7ccd;
lut[879]=16'h7cd8;
lut[880]=16'h7ce3;
lut[881]=16'h7cee;
lut[882]=16'h7cf9;
lut[883]=16'h7d04;
lut[884]=16'h7d0e;
lut[885]=16'h7d19;
lut[886]=16'h7d24;
lut[887]=16'h7d2e;
lut[888]=16'h7d39;
lut[889]=16'h7d43;
lut[890]=16'h7d4d;
lut[891]=16'h7d57;
lut[892]=16'h7d62;
lut[893]=16'h7d6c;
lut[894]=16'h7d76;
lut[895]=16'h7d80;
lut[896]=16'h7d89;
lut[897]=16'h7d93;
lut[898]=16'h7d9d;
lut[899]=16'h7da6;
lut[900]=16'h7db0;
lut[901]=16'h7db9;
lut[902]=16'h7dc3;
lut[903]=16'h7dcc;
lut[904]=16'h7dd5;
lut[905]=16'h7ddf;
lut[906]=16'h7de8;
lut[907]=16'h7df1;
lut[908]=16'h7dfa;
lut[909]=16'h7e02;
lut[910]=16'h7e0b;
lut[911]=16'h7e14;
lut[912]=16'h7e1d;
lut[913]=16'h7e25;
lut[914]=16'h7e2e;
lut[915]=16'h7e36;
lut[916]=16'h7e3e;
lut[917]=16'h7e47;
lut[918]=16'h7e4f;
lut[919]=16'h7e57;
lut[920]=16'h7e5f;
lut[921]=16'h7e67;
lut[922]=16'h7e6f;
lut[923]=16'h7e77;
lut[924]=16'h7e7e;
lut[925]=16'h7e86;
lut[926]=16'h7e8d;
lut[927]=16'h7e95;
lut[928]=16'h7e9c;
lut[929]=16'h7ea4;
lut[930]=16'h7eab;
lut[931]=16'h7eb2;
lut[932]=16'h7eb9;
lut[933]=16'h7ec0;
lut[934]=16'h7ec7;
lut[935]=16'h7ece;
lut[936]=16'h7ed5;
lut[937]=16'h7edc;
lut[938]=16'h7ee2;
lut[939]=16'h7ee9;
lut[940]=16'h7eef;
lut[941]=16'h7ef6;
lut[942]=16'h7efc;
lut[943]=16'h7f02;
lut[944]=16'h7f09;
lut[945]=16'h7f0f;
lut[946]=16'h7f15;
lut[947]=16'h7f1b;
lut[948]=16'h7f21;
lut[949]=16'h7f26;
lut[950]=16'h7f2c;
lut[951]=16'h7f32;
lut[952]=16'h7f37;
lut[953]=16'h7f3d;
lut[954]=16'h7f42;
lut[955]=16'h7f48;
lut[956]=16'h7f4d;
lut[957]=16'h7f52;
lut[958]=16'h7f57;
lut[959]=16'h7f5c;
lut[960]=16'h7f61;
lut[961]=16'h7f66;
lut[962]=16'h7f6b;
lut[963]=16'h7f70;
lut[964]=16'h7f74;
lut[965]=16'h7f79;
lut[966]=16'h7f7d;
lut[967]=16'h7f82;
lut[968]=16'h7f86;
lut[969]=16'h7f8a;
lut[970]=16'h7f8f;
lut[971]=16'h7f93;
lut[972]=16'h7f97;
lut[973]=16'h7f9b;
lut[974]=16'h7f9f;
lut[975]=16'h7fa2;
lut[976]=16'h7fa6;
lut[977]=16'h7faa;
lut[978]=16'h7fad;
lut[979]=16'h7fb1;
lut[980]=16'h7fb4;
lut[981]=16'h7fb8;
lut[982]=16'h7fbb;
lut[983]=16'h7fbe;
lut[984]=16'h7fc1;
lut[985]=16'h7fc4;
lut[986]=16'h7fc7;
lut[987]=16'h7fca;
lut[988]=16'h7fcd;
lut[989]=16'h7fd0;
lut[990]=16'h7fd2;
lut[991]=16'h7fd5;
lut[992]=16'h7fd8;
lut[993]=16'h7fda;
lut[994]=16'h7fdc;
lut[995]=16'h7fdf;
lut[996]=16'h7fe1;
lut[997]=16'h7fe3;
lut[998]=16'h7fe5;
lut[999]=16'h7fe7;
lut[1000]=16'h7fe9;
lut[1001]=16'h7feb;
lut[1002]=16'h7fec;
lut[1003]=16'h7fee;
lut[1004]=16'h7ff0;
lut[1005]=16'h7ff1;
lut[1006]=16'h7ff3;
lut[1007]=16'h7ff4;
lut[1008]=16'h7ff5;
lut[1009]=16'h7ff6;
lut[1010]=16'h7ff7;
lut[1011]=16'h7ff8;
lut[1012]=16'h7ff9;
lut[1013]=16'h7ffa;
lut[1014]=16'h7ffb;
lut[1015]=16'h7ffc;
lut[1016]=16'h7ffd;
lut[1017]=16'h7ffd;
lut[1018]=16'h7ffe;
lut[1019]=16'h7ffe;
lut[1020]=16'h7ffe;
lut[1021]=16'h7fff;
lut[1022]=16'h7fff;
lut[1023]=16'h7fff;
end
wire [9:0] index0=a0[10]?-a0[9:0]:a0[9:0];
reg signed [15:0] value0;reg sign0,peak0;
always @(posedge clk)begin value0<=lut[index0];sign0<=a0[11];peak0<=a0[10] && a0[9:0]==0;end
wire signed [15:0] mag0=peak0?16'sd32767:value0;
assign y0=sign0?-mag0:mag0;
wire [9:0] index1=a1[10]?-a1[9:0]:a1[9:0];
reg signed [15:0] value1;reg sign1,peak1;
always @(posedge clk)begin value1<=lut[index1];sign1<=a1[11];peak1<=a1[10] && a1[9:0]==0;end
wire signed [15:0] mag1=peak1?16'sd32767:value1;
assign y1=sign1?-mag1:mag1;
wire [9:0] index2=a2[10]?-a2[9:0]:a2[9:0];
reg signed [15:0] value2;reg sign2,peak2;
always @(posedge clk)begin value2<=lut[index2];sign2<=a2[11];peak2<=a2[10] && a2[9:0]==0;end
wire signed [15:0] mag2=peak2?16'sd32767:value2;
assign y2=sign2?-mag2:mag2;
wire [9:0] index3=a3[10]?-a3[9:0]:a3[9:0];
reg signed [15:0] value3;reg sign3,peak3;
always @(posedge clk)begin value3<=lut[index3];sign3<=a3[11];peak3<=a3[10] && a3[9:0]==0;end
wire signed [15:0] mag3=peak3?16'sd32767:value3;
assign y3=sign3?-mag3:mag3;
endmodule
