Lonelyrockroll/qiansai/fpga/piano_rom.v

`timescale 1ns/1ps
module piano_rom(input wire clk,input wire [9:0] addr,detune_addr,
output reg signed [15:0] body,detune,strike);
reg signed [15:0] body_mem[0:1023];
reg signed [15:0] strike_mem[0:1023];
initial begin
body_mem[0]=16'h0000;
body_mem[1]=16'h0282;
body_mem[2]=16'h0504;
body_mem[3]=16'h0785;
body_mem[4]=16'h0a06;
body_mem[5]=16'h0c85;
body_mem[6]=16'h0f03;
body_mem[7]=16'h117e;
body_mem[8]=16'h13f8;
body_mem[9]=16'h166f;
body_mem[10]=16'h18e4;
body_mem[11]=16'h1b55;
body_mem[12]=16'h1dc3;
body_mem[13]=16'h202d;
body_mem[14]=16'h2294;
body_mem[15]=16'h24f6;
body_mem[16]=16'h2754;
body_mem[17]=16'h29ad;
body_mem[18]=16'h2c01;
body_mem[19]=16'h2e50;
body_mem[20]=16'h3099;
body_mem[21]=16'h32dd;
body_mem[22]=16'h351a;
body_mem[23]=16'h3752;
body_mem[24]=16'h3982;
body_mem[25]=16'h3bad;
body_mem[26]=16'h3dd0;
body_mem[27]=16'h3fec;
body_mem[28]=16'h4201;
body_mem[29]=16'h440e;
body_mem[30]=16'h4614;
body_mem[31]=16'h4811;
body_mem[32]=16'h4a07;
body_mem[33]=16'h4bf4;
body_mem[34]=16'h4dd9;
body_mem[35]=16'h4fb6;
body_mem[36]=16'h518a;
body_mem[37]=16'h5355;
body_mem[38]=16'h5517;
body_mem[39]=16'h56d0;
body_mem[40]=16'h5880;
body_mem[41]=16'h5a27;
body_mem[42]=16'h5bc5;
body_mem[43]=16'h5d59;
body_mem[44]=16'h5ee4;
body_mem[45]=16'h6065;
body_mem[46]=16'h61dd;
body_mem[47]=16'h634b;
body_mem[48]=16'h64b0;
body_mem[49]=16'h660b;
body_mem[50]=16'h675c;
body_mem[51]=16'h68a4;
body_mem[52]=16'h69e2;
body_mem[53]=16'h6b16;
body_mem[54]=16'h6c41;
body_mem[55]=16'h6d62;
body_mem[56]=16'h6e7a;
body_mem[57]=16'h6f88;
body_mem[58]=16'h708c;
body_mem[59]=16'h7187;
body_mem[60]=16'h7279;
body_mem[61]=16'h7362;
body_mem[62]=16'h7441;
body_mem[63]=16'h7517;
body_mem[64]=16'h75e4;
body_mem[65]=16'h76a8;
body_mem[66]=16'h7763;
body_mem[67]=16'h7816;
body_mem[68]=16'h78c0;
body_mem[69]=16'h7961;
body_mem[70]=16'h79fa;
body_mem[71]=16'h7a8b;
body_mem[72]=16'h7b13;
body_mem[73]=16'h7b94;
body_mem[74]=16'h7c0d;
body_mem[75]=16'h7c7e;
body_mem[76]=16'h7ce7;
body_mem[77]=16'h7d49;
body_mem[78]=16'h7da4;
body_mem[79]=16'h7df8;
body_mem[80]=16'h7e45;
body_mem[81]=16'h7e8b;
body_mem[82]=16'h7eca;
body_mem[83]=16'h7f03;
body_mem[84]=16'h7f36;
body_mem[85]=16'h7f62;
body_mem[86]=16'h7f89;
body_mem[87]=16'h7faa;
body_mem[88]=16'h7fc5;
body_mem[89]=16'h7fdb;
body_mem[90]=16'h7feb;
body_mem[91]=16'h7ff7;
body_mem[92]=16'h7ffd;
body_mem[93]=16'h7fff;
body_mem[94]=16'h7ffc;
body_mem[95]=16'h7ff5;
body_mem[96]=16'h7fe9;
body_mem[97]=16'h7fda;
body_mem[98]=16'h7fc6;
body_mem[99]=16'h7faf;
body_mem[100]=16'h7f94;
body_mem[101]=16'h7f75;
body_mem[102]=16'h7f53;
body_mem[103]=16'h7f2e;
body_mem[104]=16'h7f06;
body_mem[105]=16'h7edb;
body_mem[106]=16'h7eae;
body_mem[107]=16'h7e7d;
body_mem[108]=16'h7e4b;
body_mem[109]=16'h7e16;
body_mem[110]=16'h7dde;
body_mem[111]=16'h7da5;
body_mem[112]=16'h7d6a;
body_mem[113]=16'h7d2d;
body_mem[114]=16'h7cee;
body_mem[115]=16'h7cad;
body_mem[116]=16'h7c6b;
body_mem[117]=16'h7c28;
body_mem[118]=16'h7be3;
body_mem[119]=16'h7b9d;
body_mem[120]=16'h7b55;
body_mem[121]=16'h7b0d;
body_mem[122]=16'h7ac4;
body_mem[123]=16'h7a7a;
body_mem[124]=16'h7a2f;
body_mem[125]=16'h79e3;
body_mem[126]=16'h7997;
body_mem[127]=16'h7949;
body_mem[128]=16'h78fc;
body_mem[129]=16'h78ad;
body_mem[130]=16'h785f;
body_mem[131]=16'h7810;
body_mem[132]=16'h77c0;
body_mem[133]=16'h7770;
body_mem[134]=16'h7720;
body_mem[135]=16'h76cf;
body_mem[136]=16'h767e;
body_mem[137]=16'h762d;
body_mem[138]=16'h75dc;
body_mem[139]=16'h758a;
body_mem[140]=16'h7539;
body_mem[141]=16'h74e7;
body_mem[142]=16'h7494;
body_mem[143]=16'h7442;
body_mem[144]=16'h73f0;
body_mem[145]=16'h739d;
body_mem[146]=16'h734a;
body_mem[147]=16'h72f7;
body_mem[148]=16'h72a4;
body_mem[149]=16'h7251;
body_mem[150]=16'h71fe;
body_mem[151]=16'h71aa;
body_mem[152]=16'h7156;
body_mem[153]=16'h7102;
body_mem[154]=16'h70ae;
body_mem[155]=16'h7059;
body_mem[156]=16'h7005;
body_mem[157]=16'h6faf;
body_mem[158]=16'h6f5a;
body_mem[159]=16'h6f04;
body_mem[160]=16'h6eae;
body_mem[161]=16'h6e58;
body_mem[162]=16'h6e01;
body_mem[163]=16'h6daa;
body_mem[164]=16'h6d53;
body_mem[165]=16'h6cfb;
body_mem[166]=16'h6ca3;
body_mem[167]=16'h6c4a;
body_mem[168]=16'h6bf0;
body_mem[169]=16'h6b97;
body_mem[170]=16'h6b3c;
body_mem[171]=16'h6ae2;
body_mem[172]=16'h6a86;
body_mem[173]=16'h6a2a;
body_mem[174]=16'h69ce;
body_mem[175]=16'h6971;
body_mem[176]=16'h6913;
body_mem[177]=16'h68b5;
body_mem[178]=16'h6856;
body_mem[179]=16'h67f7;
body_mem[180]=16'h6797;
body_mem[181]=16'h6736;
body_mem[182]=16'h66d5;
body_mem[183]=16'h6672;
body_mem[184]=16'h6610;
body_mem[185]=16'h65ad;
body_mem[186]=16'h6549;
body_mem[187]=16'h64e4;
body_mem[188]=16'h647f;
body_mem[189]=16'h6419;
body_mem[190]=16'h63b2;
body_mem[191]=16'h634b;
body_mem[192]=16'h62e4;
body_mem[193]=16'h627b;
body_mem[194]=16'h6212;
body_mem[195]=16'h61a9;
body_mem[196]=16'h613f;
body_mem[197]=16'h60d4;
body_mem[198]=16'h6069;
body_mem[199]=16'h5ffd;
body_mem[200]=16'h5f91;
body_mem[201]=16'h5f24;
body_mem[202]=16'h5eb7;
body_mem[203]=16'h5e49;
body_mem[204]=16'h5ddb;
body_mem[205]=16'h5d6d;
body_mem[206]=16'h5cfe;
body_mem[207]=16'h5c8f;
body_mem[208]=16'h5c1f;
body_mem[209]=16'h5baf;
body_mem[210]=16'h5b3f;
body_mem[211]=16'h5acf;
body_mem[212]=16'h5a5e;
body_mem[213]=16'h59ed;
body_mem[214]=16'h597c;
body_mem[215]=16'h590b;
body_mem[216]=16'h589a;
body_mem[217]=16'h5828;
body_mem[218]=16'h57b7;
body_mem[219]=16'h5745;
body_mem[220]=16'h56d4;
body_mem[221]=16'h5662;
body_mem[222]=16'h55f1;
body_mem[223]=16'h557f;
body_mem[224]=16'h550e;
body_mem[225]=16'h549c;
body_mem[226]=16'h542b;
body_mem[227]=16'h53ba;
body_mem[228]=16'h5349;
body_mem[229]=16'h52d9;
body_mem[230]=16'h5268;
body_mem[231]=16'h51f8;
body_mem[232]=16'h5188;
body_mem[233]=16'h5118;
body_mem[234]=16'h50a9;
body_mem[235]=16'h503a;
body_mem[236]=16'h4fcb;
body_mem[237]=16'h4f5d;
body_mem[238]=16'h4eef;
body_mem[239]=16'h4e81;
body_mem[240]=16'h4e14;
body_mem[241]=16'h4da7;
body_mem[242]=16'h4d3a;
body_mem[243]=16'h4cce;
body_mem[244]=16'h4c62;
body_mem[245]=16'h4bf7;
body_mem[246]=16'h4b8c;
body_mem[247]=16'h4b22;
body_mem[248]=16'h4ab8;
body_mem[249]=16'h4a4f;
body_mem[250]=16'h49e6;
body_mem[251]=16'h497d;
body_mem[252]=16'h4915;
body_mem[253]=16'h48ad;
body_mem[254]=16'h4846;
body_mem[255]=16'h47df;
body_mem[256]=16'h4779;
body_mem[257]=16'h4713;
body_mem[258]=16'h46ae;
body_mem[259]=16'h4649;
body_mem[260]=16'h45e4;
body_mem[261]=16'h4580;
body_mem[262]=16'h451c;
body_mem[263]=16'h44b9;
body_mem[264]=16'h4455;
body_mem[265]=16'h43f3;
body_mem[266]=16'h4390;
body_mem[267]=16'h432e;
body_mem[268]=16'h42cd;
body_mem[269]=16'h426b;
body_mem[270]=16'h420a;
body_mem[271]=16'h41aa;
body_mem[272]=16'h4149;
body_mem[273]=16'h40e9;
body_mem[274]=16'h4089;
body_mem[275]=16'h402a;
body_mem[276]=16'h3fca;
body_mem[277]=16'h3f6b;
body_mem[278]=16'h3f0c;
body_mem[279]=16'h3ead;
body_mem[280]=16'h3e4e;
body_mem[281]=16'h3df0;
body_mem[282]=16'h3d91;
body_mem[283]=16'h3d33;
body_mem[284]=16'h3cd5;
body_mem[285]=16'h3c77;
body_mem[286]=16'h3c19;
body_mem[287]=16'h3bbc;
body_mem[288]=16'h3b5e;
body_mem[289]=16'h3b00;
body_mem[290]=16'h3aa3;
body_mem[291]=16'h3a46;
body_mem[292]=16'h39e8;
body_mem[293]=16'h398b;
body_mem[294]=16'h392e;
body_mem[295]=16'h38d0;
body_mem[296]=16'h3873;
body_mem[297]=16'h3816;
body_mem[298]=16'h37b9;
body_mem[299]=16'h375c;
body_mem[300]=16'h36ff;
body_mem[301]=16'h36a1;
body_mem[302]=16'h3644;
body_mem[303]=16'h35e7;
body_mem[304]=16'h358a;
body_mem[305]=16'h352d;
body_mem[306]=16'h34d1;
body_mem[307]=16'h3474;
body_mem[308]=16'h3417;
body_mem[309]=16'h33ba;
body_mem[310]=16'h335e;
body_mem[311]=16'h3301;
body_mem[312]=16'h32a4;
body_mem[313]=16'h3248;
body_mem[314]=16'h31ec;
body_mem[315]=16'h3190;
body_mem[316]=16'h3133;
body_mem[317]=16'h30d8;
body_mem[318]=16'h307c;
body_mem[319]=16'h3020;
body_mem[320]=16'h2fc5;
body_mem[321]=16'h2f6a;
body_mem[322]=16'h2f0f;
body_mem[323]=16'h2eb4;
body_mem[324]=16'h2e5a;
body_mem[325]=16'h2dff;
body_mem[326]=16'h2da5;
body_mem[327]=16'h2d4c;
body_mem[328]=16'h2cf2;
body_mem[329]=16'h2c99;
body_mem[330]=16'h2c41;
body_mem[331]=16'h2be9;
body_mem[332]=16'h2b91;
body_mem[333]=16'h2b39;
body_mem[334]=16'h2ae2;
body_mem[335]=16'h2a8c;
body_mem[336]=16'h2a36;
body_mem[337]=16'h29e0;
body_mem[338]=16'h298b;
body_mem[339]=16'h2936;
body_mem[340]=16'h28e2;
body_mem[341]=16'h288f;
body_mem[342]=16'h283c;
body_mem[343]=16'h27ea;
body_mem[344]=16'h2798;
body_mem[345]=16'h2747;
body_mem[346]=16'h26f6;
body_mem[347]=16'h26a6;
body_mem[348]=16'h2657;
body_mem[349]=16'h2609;
body_mem[350]=16'h25bb;
body_mem[351]=16'h256e;
body_mem[352]=16'h2521;
body_mem[353]=16'h24d5;
body_mem[354]=16'h248a;
body_mem[355]=16'h2440;
body_mem[356]=16'h23f6;
body_mem[357]=16'h23ad;
body_mem[358]=16'h2365;
body_mem[359]=16'h231e;
body_mem[360]=16'h22d7;
body_mem[361]=16'h2291;
body_mem[362]=16'h224c;
body_mem[363]=16'h2207;
body_mem[364]=16'h21c3;
body_mem[365]=16'h2180;
body_mem[366]=16'h213e;
body_mem[367]=16'h20fc;
body_mem[368]=16'h20bb;
body_mem[369]=16'h207b;
body_mem[370]=16'h203c;
body_mem[371]=16'h1ffd;
body_mem[372]=16'h1fbf;
body_mem[373]=16'h1f81;
body_mem[374]=16'h1f45;
body_mem[375]=16'h1f09;
body_mem[376]=16'h1ecd;
body_mem[377]=16'h1e92;
body_mem[378]=16'h1e58;
body_mem[379]=16'h1e1e;
body_mem[380]=16'h1de5;
body_mem[381]=16'h1dad;
body_mem[382]=16'h1d75;
body_mem[383]=16'h1d3d;
body_mem[384]=16'h1d06;
body_mem[385]=16'h1cd0;
body_mem[386]=16'h1c9a;
body_mem[387]=16'h1c64;
body_mem[388]=16'h1c2f;
body_mem[389]=16'h1bfa;
body_mem[390]=16'h1bc6;
body_mem[391]=16'h1b92;
body_mem[392]=16'h1b5e;
body_mem[393]=16'h1b2b;
body_mem[394]=16'h1af7;
body_mem[395]=16'h1ac5;
body_mem[396]=16'h1a92;
body_mem[397]=16'h1a60;
body_mem[398]=16'h1a2d;
body_mem[399]=16'h19fb;
body_mem[400]=16'h19c9;
body_mem[401]=16'h1998;
body_mem[402]=16'h1966;
body_mem[403]=16'h1934;
body_mem[404]=16'h1903;
body_mem[405]=16'h18d1;
body_mem[406]=16'h18a0;
body_mem[407]=16'h186e;
body_mem[408]=16'h183d;
body_mem[409]=16'h180b;
body_mem[410]=16'h17d9;
body_mem[411]=16'h17a8;
body_mem[412]=16'h1776;
body_mem[413]=16'h1744;
body_mem[414]=16'h1712;
body_mem[415]=16'h16df;
body_mem[416]=16'h16ad;
body_mem[417]=16'h167a;
body_mem[418]=16'h1648;
body_mem[419]=16'h1614;
body_mem[420]=16'h15e1;
body_mem[421]=16'h15ae;
body_mem[422]=16'h157a;
body_mem[423]=16'h1546;
body_mem[424]=16'h1511;
body_mem[425]=16'h14dd;
body_mem[426]=16'h14a8;
body_mem[427]=16'h1472;
body_mem[428]=16'h143d;
body_mem[429]=16'h1407;
body_mem[430]=16'h13d1;
body_mem[431]=16'h139a;
body_mem[432]=16'h1363;
body_mem[433]=16'h132c;
body_mem[434]=16'h12f5;
body_mem[435]=16'h12bd;
body_mem[436]=16'h1285;
body_mem[437]=16'h124c;
body_mem[438]=16'h1213;
body_mem[439]=16'h11da;
body_mem[440]=16'h11a0;
body_mem[441]=16'h1166;
body_mem[442]=16'h112c;
body_mem[443]=16'h10f2;
body_mem[444]=16'h10b7;
body_mem[445]=16'h107c;
body_mem[446]=16'h1040;
body_mem[447]=16'h1005;
body_mem[448]=16'h0fc9;
body_mem[449]=16'h0f8c;
body_mem[450]=16'h0f50;
body_mem[451]=16'h0f13;
body_mem[452]=16'h0ed6;
body_mem[453]=16'h0e99;
body_mem[454]=16'h0e5b;
body_mem[455]=16'h0e1d;
body_mem[456]=16'h0ddf;
body_mem[457]=16'h0da1;
body_mem[458]=16'h0d63;
body_mem[459]=16'h0d24;
body_mem[460]=16'h0ce6;
body_mem[461]=16'h0ca7;
body_mem[462]=16'h0c68;
body_mem[463]=16'h0c28;
body_mem[464]=16'h0be9;
body_mem[465]=16'h0baa;
body_mem[466]=16'h0b6a;
body_mem[467]=16'h0b2a;
body_mem[468]=16'h0aeb;
body_mem[469]=16'h0aab;
body_mem[470]=16'h0a6b;
body_mem[471]=16'h0a2b;
body_mem[472]=16'h09eb;
body_mem[473]=16'h09ab;
body_mem[474]=16'h096b;
body_mem[475]=16'h092b;
body_mem[476]=16'h08eb;
body_mem[477]=16'h08ab;
body_mem[478]=16'h086b;
body_mem[479]=16'h082b;
body_mem[480]=16'h07eb;
body_mem[481]=16'h07ab;
body_mem[482]=16'h076b;
body_mem[483]=16'h072b;
body_mem[484]=16'h06eb;
body_mem[485]=16'h06ab;
body_mem[486]=16'h066b;
body_mem[487]=16'h062b;
body_mem[488]=16'h05ec;
body_mem[489]=16'h05ac;
body_mem[490]=16'h056c;
body_mem[491]=16'h052d;
body_mem[492]=16'h04ed;
body_mem[493]=16'h04ae;
body_mem[494]=16'h046e;
body_mem[495]=16'h042f;
body_mem[496]=16'h03ef;
body_mem[497]=16'h03b0;
body_mem[498]=16'h0371;
body_mem[499]=16'h0332;
body_mem[500]=16'h02f3;
body_mem[501]=16'h02b4;
body_mem[502]=16'h0275;
body_mem[503]=16'h0236;
body_mem[504]=16'h01f7;
body_mem[505]=16'h01b8;
body_mem[506]=16'h0179;
body_mem[507]=16'h013a;
body_mem[508]=16'h00fb;
body_mem[509]=16'h00bc;
body_mem[510]=16'h007e;
body_mem[511]=16'h003f;
body_mem[512]=16'h0000;
body_mem[513]=16'hffc1;
body_mem[514]=16'hff82;
body_mem[515]=16'hff44;
body_mem[516]=16'hff05;
body_mem[517]=16'hfec6;
body_mem[518]=16'hfe87;
body_mem[519]=16'hfe48;
body_mem[520]=16'hfe09;
body_mem[521]=16'hfdca;
body_mem[522]=16'hfd8b;
body_mem[523]=16'hfd4c;
body_mem[524]=16'hfd0d;
body_mem[525]=16'hfcce;
body_mem[526]=16'hfc8f;
body_mem[527]=16'hfc50;
body_mem[528]=16'hfc11;
body_mem[529]=16'hfbd1;
body_mem[530]=16'hfb92;
body_mem[531]=16'hfb52;
body_mem[532]=16'hfb13;
body_mem[533]=16'hfad3;
body_mem[534]=16'hfa94;
body_mem[535]=16'hfa54;
body_mem[536]=16'hfa14;
body_mem[537]=16'hf9d5;
body_mem[538]=16'hf995;
body_mem[539]=16'hf955;
body_mem[540]=16'hf915;
body_mem[541]=16'hf8d5;
body_mem[542]=16'hf895;
body_mem[543]=16'hf855;
body_mem[544]=16'hf815;
body_mem[545]=16'hf7d5;
body_mem[546]=16'hf795;
body_mem[547]=16'hf755;
body_mem[548]=16'hf715;
body_mem[549]=16'hf6d5;
body_mem[550]=16'hf695;
body_mem[551]=16'hf655;
body_mem[552]=16'hf615;
body_mem[553]=16'hf5d5;
body_mem[554]=16'hf595;
body_mem[555]=16'hf555;
body_mem[556]=16'hf515;
body_mem[557]=16'hf4d6;
body_mem[558]=16'hf496;
body_mem[559]=16'hf456;
body_mem[560]=16'hf417;
body_mem[561]=16'hf3d8;
body_mem[562]=16'hf398;
body_mem[563]=16'hf359;
body_mem[564]=16'hf31a;
body_mem[565]=16'hf2dc;
body_mem[566]=16'hf29d;
body_mem[567]=16'hf25f;
body_mem[568]=16'hf221;
body_mem[569]=16'hf1e3;
body_mem[570]=16'hf1a5;
body_mem[571]=16'hf167;
body_mem[572]=16'hf12a;
body_mem[573]=16'hf0ed;
body_mem[574]=16'hf0b0;
body_mem[575]=16'hf074;
body_mem[576]=16'hf037;
body_mem[577]=16'heffb;
body_mem[578]=16'hefc0;
body_mem[579]=16'hef84;
body_mem[580]=16'hef49;
body_mem[581]=16'hef0e;
body_mem[582]=16'heed4;
body_mem[583]=16'hee9a;
body_mem[584]=16'hee60;
body_mem[585]=16'hee26;
body_mem[586]=16'heded;
body_mem[587]=16'hedb4;
body_mem[588]=16'hed7b;
body_mem[589]=16'hed43;
body_mem[590]=16'hed0b;
body_mem[591]=16'hecd4;
body_mem[592]=16'hec9d;
body_mem[593]=16'hec66;
body_mem[594]=16'hec2f;
body_mem[595]=16'hebf9;
body_mem[596]=16'hebc3;
body_mem[597]=16'heb8e;
body_mem[598]=16'heb58;
body_mem[599]=16'heb23;
body_mem[600]=16'heaef;
body_mem[601]=16'heaba;
body_mem[602]=16'hea86;
body_mem[603]=16'hea52;
body_mem[604]=16'hea1f;
body_mem[605]=16'he9ec;
body_mem[606]=16'he9b8;
body_mem[607]=16'he986;
body_mem[608]=16'he953;
body_mem[609]=16'he921;
body_mem[610]=16'he8ee;
body_mem[611]=16'he8bc;
body_mem[612]=16'he88a;
body_mem[613]=16'he858;
body_mem[614]=16'he827;
body_mem[615]=16'he7f5;
body_mem[616]=16'he7c3;
body_mem[617]=16'he792;
body_mem[618]=16'he760;
body_mem[619]=16'he72f;
body_mem[620]=16'he6fd;
body_mem[621]=16'he6cc;
body_mem[622]=16'he69a;
body_mem[623]=16'he668;
body_mem[624]=16'he637;
body_mem[625]=16'he605;
body_mem[626]=16'he5d3;
body_mem[627]=16'he5a0;
body_mem[628]=16'he56e;
body_mem[629]=16'he53b;
body_mem[630]=16'he509;
body_mem[631]=16'he4d5;
body_mem[632]=16'he4a2;
body_mem[633]=16'he46e;
body_mem[634]=16'he43a;
body_mem[635]=16'he406;
body_mem[636]=16'he3d1;
body_mem[637]=16'he39c;
body_mem[638]=16'he366;
body_mem[639]=16'he330;
body_mem[640]=16'he2fa;
body_mem[641]=16'he2c3;
body_mem[642]=16'he28b;
body_mem[643]=16'he253;
body_mem[644]=16'he21b;
body_mem[645]=16'he1e2;
body_mem[646]=16'he1a8;
body_mem[647]=16'he16e;
body_mem[648]=16'he133;
body_mem[649]=16'he0f7;
body_mem[650]=16'he0bb;
body_mem[651]=16'he07f;
body_mem[652]=16'he041;
body_mem[653]=16'he003;
body_mem[654]=16'hdfc4;
body_mem[655]=16'hdf85;
body_mem[656]=16'hdf45;
body_mem[657]=16'hdf04;
body_mem[658]=16'hdec2;
body_mem[659]=16'hde80;
body_mem[660]=16'hde3d;
body_mem[661]=16'hddf9;
body_mem[662]=16'hddb4;
body_mem[663]=16'hdd6f;
body_mem[664]=16'hdd29;
body_mem[665]=16'hdce2;
body_mem[666]=16'hdc9b;
body_mem[667]=16'hdc53;
body_mem[668]=16'hdc0a;
body_mem[669]=16'hdbc0;
body_mem[670]=16'hdb76;
body_mem[671]=16'hdb2b;
body_mem[672]=16'hdadf;
body_mem[673]=16'hda92;
body_mem[674]=16'hda45;
body_mem[675]=16'hd9f7;
body_mem[676]=16'hd9a9;
body_mem[677]=16'hd95a;
body_mem[678]=16'hd90a;
body_mem[679]=16'hd8b9;
body_mem[680]=16'hd868;
body_mem[681]=16'hd816;
body_mem[682]=16'hd7c4;
body_mem[683]=16'hd771;
body_mem[684]=16'hd71e;
body_mem[685]=16'hd6ca;
body_mem[686]=16'hd675;
body_mem[687]=16'hd620;
body_mem[688]=16'hd5ca;
body_mem[689]=16'hd574;
body_mem[690]=16'hd51e;
body_mem[691]=16'hd4c7;
body_mem[692]=16'hd46f;
body_mem[693]=16'hd417;
body_mem[694]=16'hd3bf;
body_mem[695]=16'hd367;
body_mem[696]=16'hd30e;
body_mem[697]=16'hd2b4;
body_mem[698]=16'hd25b;
body_mem[699]=16'hd201;
body_mem[700]=16'hd1a6;
body_mem[701]=16'hd14c;
body_mem[702]=16'hd0f1;
body_mem[703]=16'hd096;
body_mem[704]=16'hd03b;
body_mem[705]=16'hcfe0;
body_mem[706]=16'hcf84;
body_mem[707]=16'hcf28;
body_mem[708]=16'hcecd;
body_mem[709]=16'hce70;
body_mem[710]=16'hce14;
body_mem[711]=16'hcdb8;
body_mem[712]=16'hcd5c;
body_mem[713]=16'hccff;
body_mem[714]=16'hcca2;
body_mem[715]=16'hcc46;
body_mem[716]=16'hcbe9;
body_mem[717]=16'hcb8c;
body_mem[718]=16'hcb2f;
body_mem[719]=16'hcad3;
body_mem[720]=16'hca76;
body_mem[721]=16'hca19;
body_mem[722]=16'hc9bc;
body_mem[723]=16'hc95f;
body_mem[724]=16'hc901;
body_mem[725]=16'hc8a4;
body_mem[726]=16'hc847;
body_mem[727]=16'hc7ea;
body_mem[728]=16'hc78d;
body_mem[729]=16'hc730;
body_mem[730]=16'hc6d2;
body_mem[731]=16'hc675;
body_mem[732]=16'hc618;
body_mem[733]=16'hc5ba;
body_mem[734]=16'hc55d;
body_mem[735]=16'hc500;
body_mem[736]=16'hc4a2;
body_mem[737]=16'hc444;
body_mem[738]=16'hc3e7;
body_mem[739]=16'hc389;
body_mem[740]=16'hc32b;
body_mem[741]=16'hc2cd;
body_mem[742]=16'hc26f;
body_mem[743]=16'hc210;
body_mem[744]=16'hc1b2;
body_mem[745]=16'hc153;
body_mem[746]=16'hc0f4;
body_mem[747]=16'hc095;
body_mem[748]=16'hc036;
body_mem[749]=16'hbfd6;
body_mem[750]=16'hbf77;
body_mem[751]=16'hbf17;
body_mem[752]=16'hbeb7;
body_mem[753]=16'hbe56;
body_mem[754]=16'hbdf6;
body_mem[755]=16'hbd95;
body_mem[756]=16'hbd33;
body_mem[757]=16'hbcd2;
body_mem[758]=16'hbc70;
body_mem[759]=16'hbc0d;
body_mem[760]=16'hbbab;
body_mem[761]=16'hbb47;
body_mem[762]=16'hbae4;
body_mem[763]=16'hba80;
body_mem[764]=16'hba1c;
body_mem[765]=16'hb9b7;
body_mem[766]=16'hb952;
body_mem[767]=16'hb8ed;
body_mem[768]=16'hb887;
body_mem[769]=16'hb821;
body_mem[770]=16'hb7ba;
body_mem[771]=16'hb753;
body_mem[772]=16'hb6eb;
body_mem[773]=16'hb683;
body_mem[774]=16'hb61a;
body_mem[775]=16'hb5b1;
body_mem[776]=16'hb548;
body_mem[777]=16'hb4de;
body_mem[778]=16'hb474;
body_mem[779]=16'hb409;
body_mem[780]=16'hb39e;
body_mem[781]=16'hb332;
body_mem[782]=16'hb2c6;
body_mem[783]=16'hb259;
body_mem[784]=16'hb1ec;
body_mem[785]=16'hb17f;
body_mem[786]=16'hb111;
body_mem[787]=16'hb0a3;
body_mem[788]=16'hb035;
body_mem[789]=16'hafc6;
body_mem[790]=16'haf57;
body_mem[791]=16'haee8;
body_mem[792]=16'hae78;
body_mem[793]=16'hae08;
body_mem[794]=16'had98;
body_mem[795]=16'had27;
body_mem[796]=16'hacb7;
body_mem[797]=16'hac46;
body_mem[798]=16'habd5;
body_mem[799]=16'hab64;
body_mem[800]=16'haaf2;
body_mem[801]=16'haa81;
body_mem[802]=16'haa0f;
body_mem[803]=16'ha99e;
body_mem[804]=16'ha92c;
body_mem[805]=16'ha8bb;
body_mem[806]=16'ha849;
body_mem[807]=16'ha7d8;
body_mem[808]=16'ha766;
body_mem[809]=16'ha6f5;
body_mem[810]=16'ha684;
body_mem[811]=16'ha613;
body_mem[812]=16'ha5a2;
body_mem[813]=16'ha531;
body_mem[814]=16'ha4c1;
body_mem[815]=16'ha451;
body_mem[816]=16'ha3e1;
body_mem[817]=16'ha371;
body_mem[818]=16'ha302;
body_mem[819]=16'ha293;
body_mem[820]=16'ha225;
body_mem[821]=16'ha1b7;
body_mem[822]=16'ha149;
body_mem[823]=16'ha0dc;
body_mem[824]=16'ha06f;
body_mem[825]=16'ha003;
body_mem[826]=16'h9f97;
body_mem[827]=16'h9f2c;
body_mem[828]=16'h9ec1;
body_mem[829]=16'h9e57;
body_mem[830]=16'h9dee;
body_mem[831]=16'h9d85;
body_mem[832]=16'h9d1c;
body_mem[833]=16'h9cb5;
body_mem[834]=16'h9c4e;
body_mem[835]=16'h9be7;
body_mem[836]=16'h9b81;
body_mem[837]=16'h9b1c;
body_mem[838]=16'h9ab7;
body_mem[839]=16'h9a53;
body_mem[840]=16'h99f0;
body_mem[841]=16'h998e;
body_mem[842]=16'h992b;
body_mem[843]=16'h98ca;
body_mem[844]=16'h9869;
body_mem[845]=16'h9809;
body_mem[846]=16'h97aa;
body_mem[847]=16'h974b;
body_mem[848]=16'h96ed;
body_mem[849]=16'h968f;
body_mem[850]=16'h9632;
body_mem[851]=16'h95d6;
body_mem[852]=16'h957a;
body_mem[853]=16'h951e;
body_mem[854]=16'h94c4;
body_mem[855]=16'h9469;
body_mem[856]=16'h9410;
body_mem[857]=16'h93b6;
body_mem[858]=16'h935d;
body_mem[859]=16'h9305;
body_mem[860]=16'h92ad;
body_mem[861]=16'h9256;
body_mem[862]=16'h91ff;
body_mem[863]=16'h91a8;
body_mem[864]=16'h9152;
body_mem[865]=16'h90fc;
body_mem[866]=16'h90a6;
body_mem[867]=16'h9051;
body_mem[868]=16'h8ffb;
body_mem[869]=16'h8fa7;
body_mem[870]=16'h8f52;
body_mem[871]=16'h8efe;
body_mem[872]=16'h8eaa;
body_mem[873]=16'h8e56;
body_mem[874]=16'h8e02;
body_mem[875]=16'h8daf;
body_mem[876]=16'h8d5c;
body_mem[877]=16'h8d09;
body_mem[878]=16'h8cb6;
body_mem[879]=16'h8c63;
body_mem[880]=16'h8c10;
body_mem[881]=16'h8bbe;
body_mem[882]=16'h8b6c;
body_mem[883]=16'h8b19;
body_mem[884]=16'h8ac7;
body_mem[885]=16'h8a76;
body_mem[886]=16'h8a24;
body_mem[887]=16'h89d3;
body_mem[888]=16'h8982;
body_mem[889]=16'h8931;
body_mem[890]=16'h88e0;
body_mem[891]=16'h8890;
body_mem[892]=16'h8840;
body_mem[893]=16'h87f0;
body_mem[894]=16'h87a1;
body_mem[895]=16'h8753;
body_mem[896]=16'h8704;
body_mem[897]=16'h86b7;
body_mem[898]=16'h8669;
body_mem[899]=16'h861d;
body_mem[900]=16'h85d1;
body_mem[901]=16'h8586;
body_mem[902]=16'h853c;
body_mem[903]=16'h84f3;
body_mem[904]=16'h84ab;
body_mem[905]=16'h8463;
body_mem[906]=16'h841d;
body_mem[907]=16'h83d8;
body_mem[908]=16'h8395;
body_mem[909]=16'h8353;
body_mem[910]=16'h8312;
body_mem[911]=16'h82d3;
body_mem[912]=16'h8296;
body_mem[913]=16'h825b;
body_mem[914]=16'h8222;
body_mem[915]=16'h81ea;
body_mem[916]=16'h81b5;
body_mem[917]=16'h8183;
body_mem[918]=16'h8152;
body_mem[919]=16'h8125;
body_mem[920]=16'h80fa;
body_mem[921]=16'h80d2;
body_mem[922]=16'h80ad;
body_mem[923]=16'h808b;
body_mem[924]=16'h806c;
body_mem[925]=16'h8051;
body_mem[926]=16'h803a;
body_mem[927]=16'h8026;
body_mem[928]=16'h8017;
body_mem[929]=16'h800b;
body_mem[930]=16'h8004;
body_mem[931]=16'h8001;
body_mem[932]=16'h8003;
body_mem[933]=16'h8009;
body_mem[934]=16'h8015;
body_mem[935]=16'h8025;
body_mem[936]=16'h803b;
body_mem[937]=16'h8056;
body_mem[938]=16'h8077;
body_mem[939]=16'h809e;
body_mem[940]=16'h80ca;
body_mem[941]=16'h80fd;
body_mem[942]=16'h8136;
body_mem[943]=16'h8175;
body_mem[944]=16'h81bb;
body_mem[945]=16'h8208;
body_mem[946]=16'h825c;
body_mem[947]=16'h82b7;
body_mem[948]=16'h8319;
body_mem[949]=16'h8382;
body_mem[950]=16'h83f3;
body_mem[951]=16'h846c;
body_mem[952]=16'h84ed;
body_mem[953]=16'h8575;
body_mem[954]=16'h8606;
body_mem[955]=16'h869f;
body_mem[956]=16'h8740;
body_mem[957]=16'h87ea;
body_mem[958]=16'h889d;
body_mem[959]=16'h8958;
body_mem[960]=16'h8a1c;
body_mem[961]=16'h8ae9;
body_mem[962]=16'h8bbf;
body_mem[963]=16'h8c9e;
body_mem[964]=16'h8d87;
body_mem[965]=16'h8e79;
body_mem[966]=16'h8f74;
body_mem[967]=16'h9078;
body_mem[968]=16'h9186;
body_mem[969]=16'h929e;
body_mem[970]=16'h93bf;
body_mem[971]=16'h94ea;
body_mem[972]=16'h961e;
body_mem[973]=16'h975c;
body_mem[974]=16'h98a4;
body_mem[975]=16'h99f5;
body_mem[976]=16'h9b50;
body_mem[977]=16'h9cb5;
body_mem[978]=16'h9e23;
body_mem[979]=16'h9f9b;
body_mem[980]=16'ha11c;
body_mem[981]=16'ha2a7;
body_mem[982]=16'ha43b;
body_mem[983]=16'ha5d9;
body_mem[984]=16'ha780;
body_mem[985]=16'ha930;
body_mem[986]=16'haae9;
body_mem[987]=16'hacab;
body_mem[988]=16'hae76;
body_mem[989]=16'hb04a;
body_mem[990]=16'hb227;
body_mem[991]=16'hb40c;
body_mem[992]=16'hb5f9;
body_mem[993]=16'hb7ef;
body_mem[994]=16'hb9ec;
body_mem[995]=16'hbbf2;
body_mem[996]=16'hbdff;
body_mem[997]=16'hc014;
body_mem[998]=16'hc230;
body_mem[999]=16'hc453;
body_mem[1000]=16'hc67e;
body_mem[1001]=16'hc8ae;
body_mem[1002]=16'hcae6;
body_mem[1003]=16'hcd23;
body_mem[1004]=16'hcf67;
body_mem[1005]=16'hd1b0;
body_mem[1006]=16'hd3ff;
body_mem[1007]=16'hd653;
body_mem[1008]=16'hd8ac;
body_mem[1009]=16'hdb0a;
body_mem[1010]=16'hdd6c;
body_mem[1011]=16'hdfd3;
body_mem[1012]=16'he23d;
body_mem[1013]=16'he4ab;
body_mem[1014]=16'he71c;
body_mem[1015]=16'he991;
body_mem[1016]=16'hec08;
body_mem[1017]=16'hee82;
body_mem[1018]=16'hf0fd;
body_mem[1019]=16'hf37b;
body_mem[1020]=16'hf5fa;
body_mem[1021]=16'hf87b;
body_mem[1022]=16'hfafc;
body_mem[1023]=16'hfd7e;
strike_mem[0]=16'h0000;
strike_mem[1]=16'h03b5;
strike_mem[2]=16'h076a;
strike_mem[3]=16'h0b1d;
strike_mem[4]=16'h0ecd;
strike_mem[5]=16'h127a;
strike_mem[6]=16'h1623;
strike_mem[7]=16'h19c6;
strike_mem[8]=16'h1d64;
strike_mem[9]=16'h20fa;
strike_mem[10]=16'h248a;
strike_mem[11]=16'h2810;
strike_mem[12]=16'h2b8e;
strike_mem[13]=16'h2f02;
strike_mem[14]=16'h326b;
strike_mem[15]=16'h35c8;
strike_mem[16]=16'h3919;
strike_mem[17]=16'h3c5e;
strike_mem[18]=16'h3f94;
strike_mem[19]=16'h42bc;
strike_mem[20]=16'h45d6;
strike_mem[21]=16'h48df;
strike_mem[22]=16'h4bd8;
strike_mem[23]=16'h4ec1;
strike_mem[24]=16'h5198;
strike_mem[25]=16'h545d;
strike_mem[26]=16'h570f;
strike_mem[27]=16'h59ae;
strike_mem[28]=16'h5c3a;
strike_mem[29]=16'h5eb1;
strike_mem[30]=16'h6114;
strike_mem[31]=16'h6362;
strike_mem[32]=16'h659b;
strike_mem[33]=16'h67be;
strike_mem[34]=16'h69cc;
strike_mem[35]=16'h6bc2;
strike_mem[36]=16'h6da3;
strike_mem[37]=16'h6f6c;
strike_mem[38]=16'h711f;
strike_mem[39]=16'h72ba;
strike_mem[40]=16'h743e;
strike_mem[41]=16'h75ab;
strike_mem[42]=16'h7700;
strike_mem[43]=16'h783d;
strike_mem[44]=16'h7963;
strike_mem[45]=16'h7a70;
strike_mem[46]=16'h7b67;
strike_mem[47]=16'h7c45;
strike_mem[48]=16'h7d0c;
strike_mem[49]=16'h7dbb;
strike_mem[50]=16'h7e53;
strike_mem[51]=16'h7ed3;
strike_mem[52]=16'h7f3c;
strike_mem[53]=16'h7f8f;
strike_mem[54]=16'h7fcb;
strike_mem[55]=16'h7ff0;
strike_mem[56]=16'h7fff;
strike_mem[57]=16'h7ff8;
strike_mem[58]=16'h7fdc;
strike_mem[59]=16'h7faa;
strike_mem[60]=16'h7f64;
strike_mem[61]=16'h7f09;
strike_mem[62]=16'h7e9a;
strike_mem[63]=16'h7e17;
strike_mem[64]=16'h7d81;
strike_mem[65]=16'h7cd9;
strike_mem[66]=16'h7c1e;
strike_mem[67]=16'h7b51;
strike_mem[68]=16'h7a72;
strike_mem[69]=16'h7983;
strike_mem[70]=16'h7884;
strike_mem[71]=16'h7775;
strike_mem[72]=16'h7656;
strike_mem[73]=16'h7529;
strike_mem[74]=16'h73ee;
strike_mem[75]=16'h72a5;
strike_mem[76]=16'h7150;
strike_mem[77]=16'h6fee;
strike_mem[78]=16'h6e80;
strike_mem[79]=16'h6d07;
strike_mem[80]=16'h6b83;
strike_mem[81]=16'h69f6;
strike_mem[82]=16'h685f;
strike_mem[83]=16'h66c0;
strike_mem[84]=16'h6518;
strike_mem[85]=16'h6369;
strike_mem[86]=16'h61b2;
strike_mem[87]=16'h5ff6;
strike_mem[88]=16'h5e33;
strike_mem[89]=16'h5c6c;
strike_mem[90]=16'h5a9f;
strike_mem[91]=16'h58cf;
strike_mem[92]=16'h56fc;
strike_mem[93]=16'h5525;
strike_mem[94]=16'h534c;
strike_mem[95]=16'h5172;
strike_mem[96]=16'h4f96;
strike_mem[97]=16'h4db9;
strike_mem[98]=16'h4bdc;
strike_mem[99]=16'h49ff;
strike_mem[100]=16'h4823;
strike_mem[101]=16'h4649;
strike_mem[102]=16'h4470;
strike_mem[103]=16'h4299;
strike_mem[104]=16'h40c4;
strike_mem[105]=16'h3ef3;
strike_mem[106]=16'h3d25;
strike_mem[107]=16'h3b5b;
strike_mem[108]=16'h3994;
strike_mem[109]=16'h37d3;
strike_mem[110]=16'h3616;
strike_mem[111]=16'h345e;
strike_mem[112]=16'h32ab;
strike_mem[113]=16'h30fe;
strike_mem[114]=16'h2f58;
strike_mem[115]=16'h2db7;
strike_mem[116]=16'h2c1d;
strike_mem[117]=16'h2a89;
strike_mem[118]=16'h28fc;
strike_mem[119]=16'h2777;
strike_mem[120]=16'h25f8;
strike_mem[121]=16'h2481;
strike_mem[122]=16'h2311;
strike_mem[123]=16'h21a9;
strike_mem[124]=16'h2049;
strike_mem[125]=16'h1ef0;
strike_mem[126]=16'h1d9f;
strike_mem[127]=16'h1c56;
strike_mem[128]=16'h1b15;
strike_mem[129]=16'h19db;
strike_mem[130]=16'h18aa;
strike_mem[131]=16'h1780;
strike_mem[132]=16'h165f;
strike_mem[133]=16'h1545;
strike_mem[134]=16'h1433;
strike_mem[135]=16'h1329;
strike_mem[136]=16'h1226;
strike_mem[137]=16'h112b;
strike_mem[138]=16'h1037;
strike_mem[139]=16'h0f4b;
strike_mem[140]=16'h0e66;
strike_mem[141]=16'h0d88;
strike_mem[142]=16'h0cb1;
strike_mem[143]=16'h0be1;
strike_mem[144]=16'h0b17;
strike_mem[145]=16'h0a54;
strike_mem[146]=16'h0998;
strike_mem[147]=16'h08e1;
strike_mem[148]=16'h0831;
strike_mem[149]=16'h0786;
strike_mem[150]=16'h06e1;
strike_mem[151]=16'h0641;
strike_mem[152]=16'h05a6;
strike_mem[153]=16'h0511;
strike_mem[154]=16'h0480;
strike_mem[155]=16'h03f4;
strike_mem[156]=16'h036d;
strike_mem[157]=16'h02ea;
strike_mem[158]=16'h026a;
strike_mem[159]=16'h01ef;
strike_mem[160]=16'h0177;
strike_mem[161]=16'h0102;
strike_mem[162]=16'h0091;
strike_mem[163]=16'h0023;
strike_mem[164]=16'hffb8;
strike_mem[165]=16'hff4f;
strike_mem[166]=16'hfee9;
strike_mem[167]=16'hfe85;
strike_mem[168]=16'hfe23;
strike_mem[169]=16'hfdc3;
strike_mem[170]=16'hfd65;
strike_mem[171]=16'hfd09;
strike_mem[172]=16'hfcae;
strike_mem[173]=16'hfc54;
strike_mem[174]=16'hfbfc;
strike_mem[175]=16'hfba5;
strike_mem[176]=16'hfb4e;
strike_mem[177]=16'hfaf8;
strike_mem[178]=16'hfaa3;
strike_mem[179]=16'hfa4f;
strike_mem[180]=16'hf9fb;
strike_mem[181]=16'hf9a7;
strike_mem[182]=16'hf954;
strike_mem[183]=16'hf901;
strike_mem[184]=16'hf8ae;
strike_mem[185]=16'hf85b;
strike_mem[186]=16'hf809;
strike_mem[187]=16'hf7b6;
strike_mem[188]=16'hf763;
strike_mem[189]=16'hf710;
strike_mem[190]=16'hf6bd;
strike_mem[191]=16'hf66a;
strike_mem[192]=16'hf616;
strike_mem[193]=16'hf5c3;
strike_mem[194]=16'hf56f;
strike_mem[195]=16'hf51b;
strike_mem[196]=16'hf4c8;
strike_mem[197]=16'hf474;
strike_mem[198]=16'hf420;
strike_mem[199]=16'hf3cb;
strike_mem[200]=16'hf377;
strike_mem[201]=16'hf323;
strike_mem[202]=16'hf2cf;
strike_mem[203]=16'hf27c;
strike_mem[204]=16'hf228;
strike_mem[205]=16'hf1d5;
strike_mem[206]=16'hf182;
strike_mem[207]=16'hf12f;
strike_mem[208]=16'hf0dd;
strike_mem[209]=16'hf08c;
strike_mem[210]=16'hf03b;
strike_mem[211]=16'hefeb;
strike_mem[212]=16'hef9b;
strike_mem[213]=16'hef4d;
strike_mem[214]=16'heeff;
strike_mem[215]=16'heeb3;
strike_mem[216]=16'hee68;
strike_mem[217]=16'hee1e;
strike_mem[218]=16'hedd5;
strike_mem[219]=16'hed8e;
strike_mem[220]=16'hed48;
strike_mem[221]=16'hed04;
strike_mem[222]=16'hecc1;
strike_mem[223]=16'hec80;
strike_mem[224]=16'hec41;
strike_mem[225]=16'hec04;
strike_mem[226]=16'hebc9;
strike_mem[227]=16'heb90;
strike_mem[228]=16'heb5a;
strike_mem[229]=16'heb25;
strike_mem[230]=16'heaf3;
strike_mem[231]=16'heac3;
strike_mem[232]=16'hea95;
strike_mem[233]=16'hea6a;
strike_mem[234]=16'hea42;
strike_mem[235]=16'hea1c;
strike_mem[236]=16'he9f9;
strike_mem[237]=16'he9d8;
strike_mem[238]=16'he9ba;
strike_mem[239]=16'he99f;
strike_mem[240]=16'he986;
strike_mem[241]=16'he971;
strike_mem[242]=16'he95e;
strike_mem[243]=16'he94e;
strike_mem[244]=16'he940;
strike_mem[245]=16'he936;
strike_mem[246]=16'he92e;
strike_mem[247]=16'he929;
strike_mem[248]=16'he927;
strike_mem[249]=16'he928;
strike_mem[250]=16'he92b;
strike_mem[251]=16'he932;
strike_mem[252]=16'he93b;
strike_mem[253]=16'he946;
strike_mem[254]=16'he954;
strike_mem[255]=16'he965;
strike_mem[256]=16'he979;
strike_mem[257]=16'he98f;
strike_mem[258]=16'he9a7;
strike_mem[259]=16'he9c2;
strike_mem[260]=16'he9df;
strike_mem[261]=16'he9fe;
strike_mem[262]=16'hea1f;
strike_mem[263]=16'hea43;
strike_mem[264]=16'hea69;
strike_mem[265]=16'hea90;
strike_mem[266]=16'heaba;
strike_mem[267]=16'heae5;
strike_mem[268]=16'heb12;
strike_mem[269]=16'heb41;
strike_mem[270]=16'heb71;
strike_mem[271]=16'heba3;
strike_mem[272]=16'hebd6;
strike_mem[273]=16'hec0a;
strike_mem[274]=16'hec40;
strike_mem[275]=16'hec77;
strike_mem[276]=16'hecae;
strike_mem[277]=16'hece7;
strike_mem[278]=16'hed21;
strike_mem[279]=16'hed5b;
strike_mem[280]=16'hed96;
strike_mem[281]=16'hedd1;
strike_mem[282]=16'hee0d;
strike_mem[283]=16'hee4a;
strike_mem[284]=16'hee87;
strike_mem[285]=16'heec4;
strike_mem[286]=16'hef01;
strike_mem[287]=16'hef3e;
strike_mem[288]=16'hef7b;
strike_mem[289]=16'hefb9;
strike_mem[290]=16'heff6;
strike_mem[291]=16'hf032;
strike_mem[292]=16'hf06f;
strike_mem[293]=16'hf0ab;
strike_mem[294]=16'hf0e7;
strike_mem[295]=16'hf123;
strike_mem[296]=16'hf15e;
strike_mem[297]=16'hf198;
strike_mem[298]=16'hf1d2;
strike_mem[299]=16'hf20b;
strike_mem[300]=16'hf244;
strike_mem[301]=16'hf27c;
strike_mem[302]=16'hf2b3;
strike_mem[303]=16'hf2e9;
strike_mem[304]=16'hf31f;
strike_mem[305]=16'hf354;
strike_mem[306]=16'hf388;
strike_mem[307]=16'hf3bb;
strike_mem[308]=16'hf3ed;
strike_mem[309]=16'hf41f;
strike_mem[310]=16'hf44f;
strike_mem[311]=16'hf47f;
strike_mem[312]=16'hf4ae;
strike_mem[313]=16'hf4dc;
strike_mem[314]=16'hf50a;
strike_mem[315]=16'hf536;
strike_mem[316]=16'hf562;
strike_mem[317]=16'hf58d;
strike_mem[318]=16'hf5b7;
strike_mem[319]=16'hf5e1;
strike_mem[320]=16'hf609;
strike_mem[321]=16'hf632;
strike_mem[322]=16'hf659;
strike_mem[323]=16'hf680;
strike_mem[324]=16'hf6a7;
strike_mem[325]=16'hf6cd;
strike_mem[326]=16'hf6f2;
strike_mem[327]=16'hf717;
strike_mem[328]=16'hf73c;
strike_mem[329]=16'hf760;
strike_mem[330]=16'hf784;
strike_mem[331]=16'hf7a8;
strike_mem[332]=16'hf7cc;
strike_mem[333]=16'hf7ef;
strike_mem[334]=16'hf813;
strike_mem[335]=16'hf836;
strike_mem[336]=16'hf859;
strike_mem[337]=16'hf87c;
strike_mem[338]=16'hf8a0;
strike_mem[339]=16'hf8c3;
strike_mem[340]=16'hf8e7;
strike_mem[341]=16'hf90b;
strike_mem[342]=16'hf92f;
strike_mem[343]=16'hf954;
strike_mem[344]=16'hf978;
strike_mem[345]=16'hf99e;
strike_mem[346]=16'hf9c3;
strike_mem[347]=16'hf9e9;
strike_mem[348]=16'hfa10;
strike_mem[349]=16'hfa37;
strike_mem[350]=16'hfa5e;
strike_mem[351]=16'hfa86;
strike_mem[352]=16'hfaaf;
strike_mem[353]=16'hfad8;
strike_mem[354]=16'hfb02;
strike_mem[355]=16'hfb2c;
strike_mem[356]=16'hfb57;
strike_mem[357]=16'hfb83;
strike_mem[358]=16'hfbaf;
strike_mem[359]=16'hfbdc;
strike_mem[360]=16'hfc09;
strike_mem[361]=16'hfc37;
strike_mem[362]=16'hfc66;
strike_mem[363]=16'hfc95;
strike_mem[364]=16'hfcc5;
strike_mem[365]=16'hfcf6;
strike_mem[366]=16'hfd27;
strike_mem[367]=16'hfd58;
strike_mem[368]=16'hfd8a;
strike_mem[369]=16'hfdbd;
strike_mem[370]=16'hfdef;
strike_mem[371]=16'hfe23;
strike_mem[372]=16'hfe56;
strike_mem[373]=16'hfe8a;
strike_mem[374]=16'hfebf;
strike_mem[375]=16'hfef3;
strike_mem[376]=16'hff28;
strike_mem[377]=16'hff5c;
strike_mem[378]=16'hff91;
strike_mem[379]=16'hffc6;
strike_mem[380]=16'hfffb;
strike_mem[381]=16'h002f;
strike_mem[382]=16'h0064;
strike_mem[383]=16'h0098;
strike_mem[384]=16'h00cc;
strike_mem[385]=16'h0100;
strike_mem[386]=16'h0133;
strike_mem[387]=16'h0166;
strike_mem[388]=16'h0198;
strike_mem[389]=16'h01ca;
strike_mem[390]=16'h01fb;
strike_mem[391]=16'h022b;
strike_mem[392]=16'h025a;
strike_mem[393]=16'h0289;
strike_mem[394]=16'h02b7;
strike_mem[395]=16'h02e3;
strike_mem[396]=16'h030f;
strike_mem[397]=16'h0339;
strike_mem[398]=16'h0363;
strike_mem[399]=16'h038b;
strike_mem[400]=16'h03b2;
strike_mem[401]=16'h03d7;
strike_mem[402]=16'h03fb;
strike_mem[403]=16'h041e;
strike_mem[404]=16'h043f;
strike_mem[405]=16'h045e;
strike_mem[406]=16'h047c;
strike_mem[407]=16'h0499;
strike_mem[408]=16'h04b4;
strike_mem[409]=16'h04cd;
strike_mem[410]=16'h04e4;
strike_mem[411]=16'h04f9;
strike_mem[412]=16'h050d;
strike_mem[413]=16'h051f;
strike_mem[414]=16'h052f;
strike_mem[415]=16'h053d;
strike_mem[416]=16'h054a;
strike_mem[417]=16'h0554;
strike_mem[418]=16'h055d;
strike_mem[419]=16'h0564;
strike_mem[420]=16'h0569;
strike_mem[421]=16'h056c;
strike_mem[422]=16'h056d;
strike_mem[423]=16'h056c;
strike_mem[424]=16'h056a;
strike_mem[425]=16'h0566;
strike_mem[426]=16'h0560;
strike_mem[427]=16'h0558;
strike_mem[428]=16'h054e;
strike_mem[429]=16'h0543;
strike_mem[430]=16'h0536;
strike_mem[431]=16'h0528;
strike_mem[432]=16'h0517;
strike_mem[433]=16'h0506;
strike_mem[434]=16'h04f3;
strike_mem[435]=16'h04de;
strike_mem[436]=16'h04c8;
strike_mem[437]=16'h04b1;
strike_mem[438]=16'h0498;
strike_mem[439]=16'h047f;
strike_mem[440]=16'h0464;
strike_mem[441]=16'h0448;
strike_mem[442]=16'h042b;
strike_mem[443]=16'h040d;
strike_mem[444]=16'h03ef;
strike_mem[445]=16'h03cf;
strike_mem[446]=16'h03af;
strike_mem[447]=16'h038e;
strike_mem[448]=16'h036d;
strike_mem[449]=16'h034b;
strike_mem[450]=16'h0329;
strike_mem[451]=16'h0306;
strike_mem[452]=16'h02e3;
strike_mem[453]=16'h02c0;
strike_mem[454]=16'h029d;
strike_mem[455]=16'h027a;
strike_mem[456]=16'h0257;
strike_mem[457]=16'h0234;
strike_mem[458]=16'h0212;
strike_mem[459]=16'h01ef;
strike_mem[460]=16'h01cd;
strike_mem[461]=16'h01ab;
strike_mem[462]=16'h018a;
strike_mem[463]=16'h0169;
strike_mem[464]=16'h0149;
strike_mem[465]=16'h012a;
strike_mem[466]=16'h010b;
strike_mem[467]=16'h00ed;
strike_mem[468]=16'h00d0;
strike_mem[469]=16'h00b4;
strike_mem[470]=16'h0099;
strike_mem[471]=16'h007f;
strike_mem[472]=16'h0066;
strike_mem[473]=16'h004d;
strike_mem[474]=16'h0036;
strike_mem[475]=16'h0021;
strike_mem[476]=16'h000c;
strike_mem[477]=16'hfff8;
strike_mem[478]=16'hffe6;
strike_mem[479]=16'hffd5;
strike_mem[480]=16'hffc5;
strike_mem[481]=16'hffb7;
strike_mem[482]=16'hffa9;
strike_mem[483]=16'hff9d;
strike_mem[484]=16'hff93;
strike_mem[485]=16'hff89;
strike_mem[486]=16'hff81;
strike_mem[487]=16'hff7a;
strike_mem[488]=16'hff74;
strike_mem[489]=16'hff70;
strike_mem[490]=16'hff6c;
strike_mem[491]=16'hff6a;
strike_mem[492]=16'hff69;
strike_mem[493]=16'hff69;
strike_mem[494]=16'hff6a;
strike_mem[495]=16'hff6c;
strike_mem[496]=16'hff70;
strike_mem[497]=16'hff74;
strike_mem[498]=16'hff79;
strike_mem[499]=16'hff7f;
strike_mem[500]=16'hff85;
strike_mem[501]=16'hff8d;
strike_mem[502]=16'hff95;
strike_mem[503]=16'hff9e;
strike_mem[504]=16'hffa7;
strike_mem[505]=16'hffb1;
strike_mem[506]=16'hffbc;
strike_mem[507]=16'hffc6;
strike_mem[508]=16'hffd2;
strike_mem[509]=16'hffdd;
strike_mem[510]=16'hffe8;
strike_mem[511]=16'hfff4;
strike_mem[512]=16'h0000;
strike_mem[513]=16'h000c;
strike_mem[514]=16'h0018;
strike_mem[515]=16'h0023;
strike_mem[516]=16'h002e;
strike_mem[517]=16'h003a;
strike_mem[518]=16'h0044;
strike_mem[519]=16'h004f;
strike_mem[520]=16'h0059;
strike_mem[521]=16'h0062;
strike_mem[522]=16'h006b;
strike_mem[523]=16'h0073;
strike_mem[524]=16'h007b;
strike_mem[525]=16'h0081;
strike_mem[526]=16'h0087;
strike_mem[527]=16'h008c;
strike_mem[528]=16'h0090;
strike_mem[529]=16'h0094;
strike_mem[530]=16'h0096;
strike_mem[531]=16'h0097;
strike_mem[532]=16'h0097;
strike_mem[533]=16'h0096;
strike_mem[534]=16'h0094;
strike_mem[535]=16'h0090;
strike_mem[536]=16'h008c;
strike_mem[537]=16'h0086;
strike_mem[538]=16'h007f;
strike_mem[539]=16'h0077;
strike_mem[540]=16'h006d;
strike_mem[541]=16'h0063;
strike_mem[542]=16'h0057;
strike_mem[543]=16'h0049;
strike_mem[544]=16'h003b;
strike_mem[545]=16'h002b;
strike_mem[546]=16'h001a;
strike_mem[547]=16'h0008;
strike_mem[548]=16'hfff4;
strike_mem[549]=16'hffdf;
strike_mem[550]=16'hffca;
strike_mem[551]=16'hffb3;
strike_mem[552]=16'hff9a;
strike_mem[553]=16'hff81;
strike_mem[554]=16'hff67;
strike_mem[555]=16'hff4c;
strike_mem[556]=16'hff30;
strike_mem[557]=16'hff13;
strike_mem[558]=16'hfef5;
strike_mem[559]=16'hfed6;
strike_mem[560]=16'hfeb7;
strike_mem[561]=16'hfe97;
strike_mem[562]=16'hfe76;
strike_mem[563]=16'hfe55;
strike_mem[564]=16'hfe33;
strike_mem[565]=16'hfe11;
strike_mem[566]=16'hfdee;
strike_mem[567]=16'hfdcc;
strike_mem[568]=16'hfda9;
strike_mem[569]=16'hfd86;
strike_mem[570]=16'hfd63;
strike_mem[571]=16'hfd40;
strike_mem[572]=16'hfd1d;
strike_mem[573]=16'hfcfa;
strike_mem[574]=16'hfcd7;
strike_mem[575]=16'hfcb5;
strike_mem[576]=16'hfc93;
strike_mem[577]=16'hfc72;
strike_mem[578]=16'hfc51;
strike_mem[579]=16'hfc31;
strike_mem[580]=16'hfc11;
strike_mem[581]=16'hfbf3;
strike_mem[582]=16'hfbd5;
strike_mem[583]=16'hfbb8;
strike_mem[584]=16'hfb9c;
strike_mem[585]=16'hfb81;
strike_mem[586]=16'hfb68;
strike_mem[587]=16'hfb4f;
strike_mem[588]=16'hfb38;
strike_mem[589]=16'hfb22;
strike_mem[590]=16'hfb0d;
strike_mem[591]=16'hfafa;
strike_mem[592]=16'hfae9;
strike_mem[593]=16'hfad8;
strike_mem[594]=16'hfaca;
strike_mem[595]=16'hfabd;
strike_mem[596]=16'hfab2;
strike_mem[597]=16'hfaa8;
strike_mem[598]=16'hfaa0;
strike_mem[599]=16'hfa9a;
strike_mem[600]=16'hfa96;
strike_mem[601]=16'hfa94;
strike_mem[602]=16'hfa93;
strike_mem[603]=16'hfa94;
strike_mem[604]=16'hfa97;
strike_mem[605]=16'hfa9c;
strike_mem[606]=16'hfaa3;
strike_mem[607]=16'hfaac;
strike_mem[608]=16'hfab6;
strike_mem[609]=16'hfac3;
strike_mem[610]=16'hfad1;
strike_mem[611]=16'hfae1;
strike_mem[612]=16'hfaf3;
strike_mem[613]=16'hfb07;
strike_mem[614]=16'hfb1c;
strike_mem[615]=16'hfb33;
strike_mem[616]=16'hfb4c;
strike_mem[617]=16'hfb67;
strike_mem[618]=16'hfb84;
strike_mem[619]=16'hfba2;
strike_mem[620]=16'hfbc1;
strike_mem[621]=16'hfbe2;
strike_mem[622]=16'hfc05;
strike_mem[623]=16'hfc29;
strike_mem[624]=16'hfc4e;
strike_mem[625]=16'hfc75;
strike_mem[626]=16'hfc9d;
strike_mem[627]=16'hfcc7;
strike_mem[628]=16'hfcf1;
strike_mem[629]=16'hfd1d;
strike_mem[630]=16'hfd49;
strike_mem[631]=16'hfd77;
strike_mem[632]=16'hfda6;
strike_mem[633]=16'hfdd5;
strike_mem[634]=16'hfe05;
strike_mem[635]=16'hfe36;
strike_mem[636]=16'hfe68;
strike_mem[637]=16'hfe9a;
strike_mem[638]=16'hfecd;
strike_mem[639]=16'hff00;
strike_mem[640]=16'hff34;
strike_mem[641]=16'hff68;
strike_mem[642]=16'hff9c;
strike_mem[643]=16'hffd1;
strike_mem[644]=16'h0005;
strike_mem[645]=16'h003a;
strike_mem[646]=16'h006f;
strike_mem[647]=16'h00a4;
strike_mem[648]=16'h00d8;
strike_mem[649]=16'h010d;
strike_mem[650]=16'h0141;
strike_mem[651]=16'h0176;
strike_mem[652]=16'h01aa;
strike_mem[653]=16'h01dd;
strike_mem[654]=16'h0211;
strike_mem[655]=16'h0243;
strike_mem[656]=16'h0276;
strike_mem[657]=16'h02a8;
strike_mem[658]=16'h02d9;
strike_mem[659]=16'h030a;
strike_mem[660]=16'h033b;
strike_mem[661]=16'h036b;
strike_mem[662]=16'h039a;
strike_mem[663]=16'h03c9;
strike_mem[664]=16'h03f7;
strike_mem[665]=16'h0424;
strike_mem[666]=16'h0451;
strike_mem[667]=16'h047d;
strike_mem[668]=16'h04a9;
strike_mem[669]=16'h04d4;
strike_mem[670]=16'h04fe;
strike_mem[671]=16'h0528;
strike_mem[672]=16'h0551;
strike_mem[673]=16'h057a;
strike_mem[674]=16'h05a2;
strike_mem[675]=16'h05c9;
strike_mem[676]=16'h05f0;
strike_mem[677]=16'h0617;
strike_mem[678]=16'h063d;
strike_mem[679]=16'h0662;
strike_mem[680]=16'h0688;
strike_mem[681]=16'h06ac;
strike_mem[682]=16'h06d1;
strike_mem[683]=16'h06f5;
strike_mem[684]=16'h0719;
strike_mem[685]=16'h073d;
strike_mem[686]=16'h0760;
strike_mem[687]=16'h0784;
strike_mem[688]=16'h07a7;
strike_mem[689]=16'h07ca;
strike_mem[690]=16'h07ed;
strike_mem[691]=16'h0811;
strike_mem[692]=16'h0834;
strike_mem[693]=16'h0858;
strike_mem[694]=16'h087c;
strike_mem[695]=16'h08a0;
strike_mem[696]=16'h08c4;
strike_mem[697]=16'h08e9;
strike_mem[698]=16'h090e;
strike_mem[699]=16'h0933;
strike_mem[700]=16'h0959;
strike_mem[701]=16'h0980;
strike_mem[702]=16'h09a7;
strike_mem[703]=16'h09ce;
strike_mem[704]=16'h09f7;
strike_mem[705]=16'h0a1f;
strike_mem[706]=16'h0a49;
strike_mem[707]=16'h0a73;
strike_mem[708]=16'h0a9e;
strike_mem[709]=16'h0aca;
strike_mem[710]=16'h0af6;
strike_mem[711]=16'h0b24;
strike_mem[712]=16'h0b52;
strike_mem[713]=16'h0b81;
strike_mem[714]=16'h0bb1;
strike_mem[715]=16'h0be1;
strike_mem[716]=16'h0c13;
strike_mem[717]=16'h0c45;
strike_mem[718]=16'h0c78;
strike_mem[719]=16'h0cac;
strike_mem[720]=16'h0ce1;
strike_mem[721]=16'h0d17;
strike_mem[722]=16'h0d4d;
strike_mem[723]=16'h0d84;
strike_mem[724]=16'h0dbc;
strike_mem[725]=16'h0df5;
strike_mem[726]=16'h0e2e;
strike_mem[727]=16'h0e68;
strike_mem[728]=16'h0ea2;
strike_mem[729]=16'h0edd;
strike_mem[730]=16'h0f19;
strike_mem[731]=16'h0f55;
strike_mem[732]=16'h0f91;
strike_mem[733]=16'h0fce;
strike_mem[734]=16'h100a;
strike_mem[735]=16'h1047;
strike_mem[736]=16'h1085;
strike_mem[737]=16'h10c2;
strike_mem[738]=16'h10ff;
strike_mem[739]=16'h113c;
strike_mem[740]=16'h1179;
strike_mem[741]=16'h11b6;
strike_mem[742]=16'h11f3;
strike_mem[743]=16'h122f;
strike_mem[744]=16'h126a;
strike_mem[745]=16'h12a5;
strike_mem[746]=16'h12df;
strike_mem[747]=16'h1319;
strike_mem[748]=16'h1352;
strike_mem[749]=16'h1389;
strike_mem[750]=16'h13c0;
strike_mem[751]=16'h13f6;
strike_mem[752]=16'h142a;
strike_mem[753]=16'h145d;
strike_mem[754]=16'h148f;
strike_mem[755]=16'h14bf;
strike_mem[756]=16'h14ee;
strike_mem[757]=16'h151b;
strike_mem[758]=16'h1546;
strike_mem[759]=16'h1570;
strike_mem[760]=16'h1597;
strike_mem[761]=16'h15bd;
strike_mem[762]=16'h15e1;
strike_mem[763]=16'h1602;
strike_mem[764]=16'h1621;
strike_mem[765]=16'h163e;
strike_mem[766]=16'h1659;
strike_mem[767]=16'h1671;
strike_mem[768]=16'h1687;
strike_mem[769]=16'h169b;
strike_mem[770]=16'h16ac;
strike_mem[771]=16'h16ba;
strike_mem[772]=16'h16c5;
strike_mem[773]=16'h16ce;
strike_mem[774]=16'h16d5;
strike_mem[775]=16'h16d8;
strike_mem[776]=16'h16d9;
strike_mem[777]=16'h16d7;
strike_mem[778]=16'h16d2;
strike_mem[779]=16'h16ca;
strike_mem[780]=16'h16c0;
strike_mem[781]=16'h16b2;
strike_mem[782]=16'h16a2;
strike_mem[783]=16'h168f;
strike_mem[784]=16'h167a;
strike_mem[785]=16'h1661;
strike_mem[786]=16'h1646;
strike_mem[787]=16'h1628;
strike_mem[788]=16'h1607;
strike_mem[789]=16'h15e4;
strike_mem[790]=16'h15be;
strike_mem[791]=16'h1596;
strike_mem[792]=16'h156b;
strike_mem[793]=16'h153d;
strike_mem[794]=16'h150d;
strike_mem[795]=16'h14db;
strike_mem[796]=16'h14a6;
strike_mem[797]=16'h1470;
strike_mem[798]=16'h1437;
strike_mem[799]=16'h13fc;
strike_mem[800]=16'h13bf;
strike_mem[801]=16'h1380;
strike_mem[802]=16'h133f;
strike_mem[803]=16'h12fc;
strike_mem[804]=16'h12b8;
strike_mem[805]=16'h1272;
strike_mem[806]=16'h122b;
strike_mem[807]=16'h11e2;
strike_mem[808]=16'h1198;
strike_mem[809]=16'h114d;
strike_mem[810]=16'h1101;
strike_mem[811]=16'h10b3;
strike_mem[812]=16'h1065;
strike_mem[813]=16'h1015;
strike_mem[814]=16'h0fc5;
strike_mem[815]=16'h0f74;
strike_mem[816]=16'h0f23;
strike_mem[817]=16'h0ed1;
strike_mem[818]=16'h0e7e;
strike_mem[819]=16'h0e2b;
strike_mem[820]=16'h0dd8;
strike_mem[821]=16'h0d84;
strike_mem[822]=16'h0d31;
strike_mem[823]=16'h0cdd;
strike_mem[824]=16'h0c89;
strike_mem[825]=16'h0c35;
strike_mem[826]=16'h0be0;
strike_mem[827]=16'h0b8c;
strike_mem[828]=16'h0b38;
strike_mem[829]=16'h0ae5;
strike_mem[830]=16'h0a91;
strike_mem[831]=16'h0a3d;
strike_mem[832]=16'h09ea;
strike_mem[833]=16'h0996;
strike_mem[834]=16'h0943;
strike_mem[835]=16'h08f0;
strike_mem[836]=16'h089d;
strike_mem[837]=16'h084a;
strike_mem[838]=16'h07f7;
strike_mem[839]=16'h07a5;
strike_mem[840]=16'h0752;
strike_mem[841]=16'h06ff;
strike_mem[842]=16'h06ac;
strike_mem[843]=16'h0659;
strike_mem[844]=16'h0605;
strike_mem[845]=16'h05b1;
strike_mem[846]=16'h055d;
strike_mem[847]=16'h0508;
strike_mem[848]=16'h04b2;
strike_mem[849]=16'h045b;
strike_mem[850]=16'h0404;
strike_mem[851]=16'h03ac;
strike_mem[852]=16'h0352;
strike_mem[853]=16'h02f7;
strike_mem[854]=16'h029b;
strike_mem[855]=16'h023d;
strike_mem[856]=16'h01dd;
strike_mem[857]=16'h017b;
strike_mem[858]=16'h0117;
strike_mem[859]=16'h00b1;
strike_mem[860]=16'h0048;
strike_mem[861]=16'hffdd;
strike_mem[862]=16'hff6f;
strike_mem[863]=16'hfefe;
strike_mem[864]=16'hfe89;
strike_mem[865]=16'hfe11;
strike_mem[866]=16'hfd96;
strike_mem[867]=16'hfd16;
strike_mem[868]=16'hfc93;
strike_mem[869]=16'hfc0c;
strike_mem[870]=16'hfb80;
strike_mem[871]=16'hfaef;
strike_mem[872]=16'hfa5a;
strike_mem[873]=16'hf9bf;
strike_mem[874]=16'hf91f;
strike_mem[875]=16'hf87a;
strike_mem[876]=16'hf7cf;
strike_mem[877]=16'hf71f;
strike_mem[878]=16'hf668;
strike_mem[879]=16'hf5ac;
strike_mem[880]=16'hf4e9;
strike_mem[881]=16'hf41f;
strike_mem[882]=16'hf34f;
strike_mem[883]=16'hf278;
strike_mem[884]=16'hf19a;
strike_mem[885]=16'hf0b5;
strike_mem[886]=16'hefc9;
strike_mem[887]=16'heed5;
strike_mem[888]=16'hedda;
strike_mem[889]=16'hecd7;
strike_mem[890]=16'hebcd;
strike_mem[891]=16'heabb;
strike_mem[892]=16'he9a1;
strike_mem[893]=16'he880;
strike_mem[894]=16'he756;
strike_mem[895]=16'he625;
strike_mem[896]=16'he4eb;
strike_mem[897]=16'he3aa;
strike_mem[898]=16'he261;
strike_mem[899]=16'he110;
strike_mem[900]=16'hdfb7;
strike_mem[901]=16'hde57;
strike_mem[902]=16'hdcef;
strike_mem[903]=16'hdb7f;
strike_mem[904]=16'hda08;
strike_mem[905]=16'hd889;
strike_mem[906]=16'hd704;
strike_mem[907]=16'hd577;
strike_mem[908]=16'hd3e3;
strike_mem[909]=16'hd249;
strike_mem[910]=16'hd0a8;
strike_mem[911]=16'hcf02;
strike_mem[912]=16'hcd55;
strike_mem[913]=16'hcba2;
strike_mem[914]=16'hc9ea;
strike_mem[915]=16'hc82d;
strike_mem[916]=16'hc66c;
strike_mem[917]=16'hc4a5;
strike_mem[918]=16'hc2db;
strike_mem[919]=16'hc10d;
strike_mem[920]=16'hbf3c;
strike_mem[921]=16'hbd67;
strike_mem[922]=16'hbb90;
strike_mem[923]=16'hb9b7;
strike_mem[924]=16'hb7dd;
strike_mem[925]=16'hb601;
strike_mem[926]=16'hb424;
strike_mem[927]=16'hb247;
strike_mem[928]=16'hb06a;
strike_mem[929]=16'hae8e;
strike_mem[930]=16'hacb4;
strike_mem[931]=16'haadb;
strike_mem[932]=16'ha904;
strike_mem[933]=16'ha731;
strike_mem[934]=16'ha561;
strike_mem[935]=16'ha394;
strike_mem[936]=16'ha1cd;
strike_mem[937]=16'ha00a;
strike_mem[938]=16'h9e4e;
strike_mem[939]=16'h9c97;
strike_mem[940]=16'h9ae8;
strike_mem[941]=16'h9940;
strike_mem[942]=16'h97a1;
strike_mem[943]=16'h960a;
strike_mem[944]=16'h947d;
strike_mem[945]=16'h92f9;
strike_mem[946]=16'h9180;
strike_mem[947]=16'h9012;
strike_mem[948]=16'h8eb0;
strike_mem[949]=16'h8d5b;
strike_mem[950]=16'h8c12;
strike_mem[951]=16'h8ad7;
strike_mem[952]=16'h89aa;
strike_mem[953]=16'h888b;
strike_mem[954]=16'h877c;
strike_mem[955]=16'h867d;
strike_mem[956]=16'h858e;
strike_mem[957]=16'h84af;
strike_mem[958]=16'h83e2;
strike_mem[959]=16'h8327;
strike_mem[960]=16'h827f;
strike_mem[961]=16'h81e9;
strike_mem[962]=16'h8166;
strike_mem[963]=16'h80f7;
strike_mem[964]=16'h809c;
strike_mem[965]=16'h8056;
strike_mem[966]=16'h8024;
strike_mem[967]=16'h8008;
strike_mem[968]=16'h8001;
strike_mem[969]=16'h8010;
strike_mem[970]=16'h8035;
strike_mem[971]=16'h8071;
strike_mem[972]=16'h80c4;
strike_mem[973]=16'h812d;
strike_mem[974]=16'h81ad;
strike_mem[975]=16'h8245;
strike_mem[976]=16'h82f4;
strike_mem[977]=16'h83bb;
strike_mem[978]=16'h8499;
strike_mem[979]=16'h8590;
strike_mem[980]=16'h869d;
strike_mem[981]=16'h87c3;
strike_mem[982]=16'h8900;
strike_mem[983]=16'h8a55;
strike_mem[984]=16'h8bc2;
strike_mem[985]=16'h8d46;
strike_mem[986]=16'h8ee1;
strike_mem[987]=16'h9094;
strike_mem[988]=16'h925d;
strike_mem[989]=16'h943e;
strike_mem[990]=16'h9634;
strike_mem[991]=16'h9842;
strike_mem[992]=16'h9a65;
strike_mem[993]=16'h9c9e;
strike_mem[994]=16'h9eec;
strike_mem[995]=16'ha14f;
strike_mem[996]=16'ha3c6;
strike_mem[997]=16'ha652;
strike_mem[998]=16'ha8f1;
strike_mem[999]=16'haba3;
strike_mem[1000]=16'hae68;
strike_mem[1001]=16'hb13f;
strike_mem[1002]=16'hb428;
strike_mem[1003]=16'hb721;
strike_mem[1004]=16'hba2a;
strike_mem[1005]=16'hbd44;
strike_mem[1006]=16'hc06c;
strike_mem[1007]=16'hc3a2;
strike_mem[1008]=16'hc6e7;
strike_mem[1009]=16'hca38;
strike_mem[1010]=16'hcd95;
strike_mem[1011]=16'hd0fe;
strike_mem[1012]=16'hd472;
strike_mem[1013]=16'hd7f0;
strike_mem[1014]=16'hdb76;
strike_mem[1015]=16'hdf06;
strike_mem[1016]=16'he29c;
strike_mem[1017]=16'he63a;
strike_mem[1018]=16'he9dd;
strike_mem[1019]=16'hed86;
strike_mem[1020]=16'hf133;
strike_mem[1021]=16'hf4e3;
strike_mem[1022]=16'hf896;
strike_mem[1023]=16'hfc4b;
end
always @(posedge clk) begin
body<=body_mem[addr];detune<=body_mem[detune_addr];strike<=strike_mem[addr];
end
endmodule
