Lonelyrockroll/qiansai/fpga/bt_console.v

// One printable command per transaction. Ignore line endings and training bytes.
// The host sends its next command after the LF response; an early command is counted.
module bt_console(input wire clk,rst,bt_rx,output wire bt_tx,input wire audio_tick,input wire signed [15:0] pcm,output wire locked,
 output wire [15:0] period,output reg [15:0] commands,dropped,
 output wire request,output reg [7:0] command,input wire accept,input wire settled,
 input wire [6:0] volume,input wire [2:0] timbre,fx,input wire [7:0] lamps,
 input wire layout_safe,input wire [4:0] scan_key,output wire [4:0] pitch_key,
 input wire guide_ui_valid,input wire [3:0] guide_ui_action,
 input wire score_video_visible,capture_busy,capture_ready,
 input wire score_ui_valid,input wire [1:0] score_ui_action,output wire score_ui_ready,
 output wire score_write_enable,output wire [14:0] score_write_address,output wire [15:0] score_write_data,
 output wire score_valid,score_show_requested,score_loading,score_reserved,
 output wire [31:0] score_received_compressed,score_decoded_bytes,
 output wire [15:0] score_page_index,score_page_count,
 output wire guide_valid,guide_playing,guide_loading,guide_demo,
 output wire [15:0] guide_time_cs,guide_duration_cs,
 output wire [9:0] guide_count,guide_index,output wire [1:0] guide_speed,
 output wire [31:0] guide_current,guide_onset,guide_next,output wire [63:0] guide_colors,
 output wire trace_valid,output wire [7:0] trace_data);
 wire received,tx_ready,frame_error;wire [7:0] data;
 reg send;reg [7:0] reply;
 wire stream_send,stream_owned;wire [7:0] stream_byte;
 wire guide_send,guide_owned,guide_receiving;wire [7:0] guide_byte;
 reg [4:0] discard_left;
 reg [23:0] discard_timeout;
 wire binary_start=received && data==8'ha5 && !prefix;
 wire blocked_start=binary_start && discard_left==0 && (stream_owned || state!=IDLE);
 wire discarding=discard_left!=0 || blocked_start;
 reg prefix;
 wire extension=received && prefix;
 bt_link link(.clk(clk),.rst(rst),.rx(bt_rx),.tx(bt_tx),.locked(locked),.period(period),.received(received),
  .data(data),.send(guide_send || stream_send || send),.reply(guide_send?guide_byte:(stream_send?stream_byte:reply)),.ready(tx_ready),.framing_error(frame_error));
 assign trace_valid=send;assign trace_data=reply;
 localparam IDLE=0,REQUEST=1,APPLY=2,SETTLE=3,REPLY=4;
 reg [2:0] state;reg [4:0] index;reg [6:0] v;reg [2:0] t,f;reg [7:0] lights;reg invalid;
 record_stream recorder(.clk(clk),.rst(rst),.audio_tick(audio_tick),.pcm(pcm),.period(period),
  .extension(extension && data!="G" && data!="P" && data!="J" && state==IDLE && !guide_owned && !discarding),.operation(data),.ready(tx_ready && !send && !guide_owned),
  .send(stream_send),.out_byte(stream_byte),.owned(stream_owned));
 guide_transport guide(.clk(clk),.rst(rst),.audio_tick(audio_tick),
  .key_probe(extension && data=="J" && state==IDLE && !guide_owned && !stream_owned && !discarding),
  .layout_safe(layout_safe),.scan_key(scan_key),.pitch_key(pitch_key),
  .score_probe(extension && data=="P" && state==IDLE && !guide_owned && !stream_owned && !discarding),
  .score_video_visible(score_video_visible),.capture_busy(capture_busy),.capture_ready(capture_ready),
  .score_ui_valid(score_ui_valid),.score_ui_action(score_ui_action),.score_ui_ready(score_ui_ready),
  .score_write_enable(score_write_enable),.score_write_address(score_write_address),.score_write_data(score_write_data),
  .score_valid(score_valid),.score_show_requested(score_show_requested),.score_loading(score_loading),.score_reserved(score_reserved),
  .score_received_compressed(score_received_compressed),.score_decoded_bytes(score_decoded_bytes),
  .score_page_index(score_page_index),.score_page_count(score_page_count),
  .rx_valid(received && state==IDLE && !stream_owned && !discarding),.rx_data(data),
  .probe(extension && data=="G" && state==IDLE && !guide_owned && !stream_owned && !discarding),
  .recorder_active(stream_owned),.ui_valid(guide_ui_valid),.ui_action(guide_ui_action),
  .tx_ready(tx_ready && !send && !stream_owned && state==IDLE),.tx_valid(guide_send),.tx_data(guide_byte),
  .owned(guide_owned),.receiving(guide_receiving),
  .guide_valid(guide_valid),.guide_playing(guide_playing),.guide_loading(guide_loading),.guide_demo(guide_demo),
  .guide_time_cs(guide_time_cs),.guide_duration_cs(guide_duration_cs),.guide_count(guide_count),.guide_index(guide_index),
  .guide_speed(guide_speed),.guide_current(guide_current),.guide_onset(guide_onset),.guide_next(guide_next),.guide_colors(guide_colors));
 assign request=state==REQUEST;
 function [7:0] hexchar(input [3:0] n);begin hexchar=n<10?"0"+n:"A"+(n-10);end endfunction
 function [7:0] message(input [4:0] i);
  begin case(i)
   0:message=invalid?"E":"O";1:message=invalid?"R":"K";2,6,9,12,16:message=" ";
   3:message="V";4:message="0"+v/10;5:message="0"+v%10;7:message="T";8:message="0"+t;
   10:message="F";11:message="0"+f;13:message="L";14:message=hexchar(lights[7:4]);15:message=hexchar(lights[3:0]);
   17:message="B";18:message=hexchar(period[15:12]);19:message=hexchar(period[11:8]);
   20:message=hexchar(period[7:4]);21:message=hexchar(period[3:0]);22:message=13;default:message=10;
  endcase end
 endfunction
 always @(posedge clk)begin
  if(rst)begin discard_left<=0;discard_timeout<=0;prefix<=0;state<=IDLE;index<=0;command<=0;commands<=0;dropped<=0;send<=0;reply<=0;invalid<=0;v<=0;t<=0;f<=0;lights<=0;end
  else begin
   send<=0;
   if(discard_left!=0)begin
    if(discard_timeout==0)discard_left<=0;else discard_timeout<=discard_timeout-1'b1;
    if(received)begin discard_left<=discard_left-1'b1;discard_timeout<=24'd12500000;end
   end
   if(blocked_start)begin discard_left<=27;discard_timeout<=24'd12500000;end
   if(frame_error || discarding || guide_owned)prefix<=0;
   else if(received)prefix<=data=="~";
   if(frame_error)dropped<=dropped+1'b1;
   if(received && !prefix && !stream_owned && !guide_owned && !discarding && data!="~" && data!="U" && data!=13 && data!=10 && data!=" ")begin
    if(state!=IDLE)dropped<=dropped+1'b1;
    else begin command<=data;commands<=commands+1'b1;
     case(data)
      "?","L","+","-","T","F","M":begin invalid<=0;state<=REQUEST;end
      default:begin invalid<=1;state<=SETTLE;end
     endcase
    end
   end
   case(state)
    REQUEST:if(accept)state<=APPLY;
    APPLY:state<=SETTLE;
    SETTLE:if(settled)begin v<=volume;t<=timbre;f<=fx;lights<=lamps;index<=0;state<=REPLY;end
    REPLY:if(tx_ready && !send)begin send<=1;reply<=message(index);
     if(index==23)state<=IDLE;else index<=index+1'b1;
    end
   endcase
  end
 end
endmodule
