Lonelyrockroll/qiansai/fpga/chorus_lfo.v

module chorus_lfo(input wire clk,input wire [14:0] addr,output reg signed [15:0] value) /* synthesis syn_romstyle="logic" */;
function signed [7:0] tab(input [6:0] index);begin case(index)
7'd0:tab=8'h00;
7'd1:tab=8'h06;
7'd2:tab=8'h0c;
7'd3:tab=8'h13;
7'd4:tab=8'h19;
7'd5:tab=8'h1f;
7'd6:tab=8'h25;
7'd7:tab=8'h2b;
7'd8:tab=8'h31;
7'd9:tab=8'h36;
7'd10:tab=8'h3c;
7'd11:tab=8'h41;
7'd12:tab=8'h47;
7'd13:tab=8'h4c;
7'd14:tab=8'h51;
7'd15:tab=8'h55;
7'd16:tab=8'h5a;
7'd17:tab=8'h5e;
7'd18:tab=8'h62;
7'd19:tab=8'h66;
7'd20:tab=8'h6a;
7'd21:tab=8'h6d;
7'd22:tab=8'h70;
7'd23:tab=8'h73;
7'd24:tab=8'h75;
7'd25:tab=8'h78;
7'd26:tab=8'h7a;
7'd27:tab=8'h7b;
7'd28:tab=8'h7d;
7'd29:tab=8'h7e;
7'd30:tab=8'h7e;
7'd31:tab=8'h7f;
7'd32:tab=8'h7f;
7'd33:tab=8'h7f;
7'd34:tab=8'h7e;
7'd35:tab=8'h7e;
7'd36:tab=8'h7d;
7'd37:tab=8'h7b;
7'd38:tab=8'h7a;
7'd39:tab=8'h78;
7'd40:tab=8'h75;
7'd41:tab=8'h73;
7'd42:tab=8'h70;
7'd43:tab=8'h6d;
7'd44:tab=8'h6a;
7'd45:tab=8'h66;
7'd46:tab=8'h62;
7'd47:tab=8'h5e;
7'd48:tab=8'h5a;
7'd49:tab=8'h55;
7'd50:tab=8'h51;
7'd51:tab=8'h4c;
7'd52:tab=8'h47;
7'd53:tab=8'h41;
7'd54:tab=8'h3c;
7'd55:tab=8'h36;
7'd56:tab=8'h31;
7'd57:tab=8'h2b;
7'd58:tab=8'h25;
7'd59:tab=8'h1f;
7'd60:tab=8'h19;
7'd61:tab=8'h13;
7'd62:tab=8'h0c;
7'd63:tab=8'h06;
7'd64:tab=8'h00;
7'd65:tab=8'hfa;
7'd66:tab=8'hf4;
7'd67:tab=8'hed;
7'd68:tab=8'he7;
7'd69:tab=8'he1;
7'd70:tab=8'hdb;
7'd71:tab=8'hd5;
7'd72:tab=8'hcf;
7'd73:tab=8'hca;
7'd74:tab=8'hc4;
7'd75:tab=8'hbf;
7'd76:tab=8'hb9;
7'd77:tab=8'hb4;
7'd78:tab=8'haf;
7'd79:tab=8'hab;
7'd80:tab=8'ha6;
7'd81:tab=8'ha2;
7'd82:tab=8'h9e;
7'd83:tab=8'h9a;
7'd84:tab=8'h96;
7'd85:tab=8'h93;
7'd86:tab=8'h90;
7'd87:tab=8'h8d;
7'd88:tab=8'h8b;
7'd89:tab=8'h88;
7'd90:tab=8'h86;
7'd91:tab=8'h85;
7'd92:tab=8'h83;
7'd93:tab=8'h82;
7'd94:tab=8'h82;
7'd95:tab=8'h81;
7'd96:tab=8'h81;
7'd97:tab=8'h81;
7'd98:tab=8'h82;
7'd99:tab=8'h82;
7'd100:tab=8'h83;
7'd101:tab=8'h85;
7'd102:tab=8'h86;
7'd103:tab=8'h88;
7'd104:tab=8'h8b;
7'd105:tab=8'h8d;
7'd106:tab=8'h90;
7'd107:tab=8'h93;
7'd108:tab=8'h96;
7'd109:tab=8'h9a;
7'd110:tab=8'h9e;
7'd111:tab=8'ha2;
7'd112:tab=8'ha6;
7'd113:tab=8'hab;
7'd114:tab=8'haf;
7'd115:tab=8'hb4;
7'd116:tab=8'hb9;
7'd117:tab=8'hbf;
7'd118:tab=8'hc4;
7'd119:tab=8'hca;
7'd120:tab=8'hcf;
7'd121:tab=8'hd5;
7'd122:tab=8'hdb;
7'd123:tab=8'he1;
7'd124:tab=8'he7;
7'd125:tab=8'hed;
7'd126:tab=8'hf4;
7'd127:tab=8'hfa;
default:tab=0;endcase end endfunction
reg signed [7:0] base,next;reg [7:0] fraction;
wire signed [17:0] delta=$signed(next)-$signed(base);
wire signed [17:0] interp=($signed(base)<<<8)+delta*$signed({1'b0,fraction});
always @(posedge clk)begin base<=tab(addr[14:8]);next<=tab(addr[14:8]+7'd1);fraction<=addr[7:0];value<=interp[15:0];end
endmodule
