Lonelyrockroll/qiansai/tests/midi/tb_midi.v

`timescale 1ns/1ps
module tb_midi;
    parameter BIT_CYCLES=32;
    reg clk=0;always #10 clk=~clk;
    reg rst=1,rx=1,enabled=1,session=1,clear=0,clear_counters=0;
    reg stall=0;wire valid,ready,panic_request;wire [122:0] data;
    wire [31:0] bytes,messages,white_keys;
    wire [15:0] frame_errors,overflows,ignored,steals,pedals;
    wire [6:0] last_note,last_velocity;wire [3:0] last_channel;
    wire [5:0] held,sounding;wire [4:0] queued;
    midi_input #(.CLK_HZ(BIT_CYCLES*31250)) dut(
        .clk(clk),.rst(rst),.rx(rx),.enabled(enabled),.session(session),.clear(clear),.clear_counters(clear_counters),
        .timbre(3'd1),.level(16'd16384),.attack(16'd269),.decay(16'd6),.sustain(16'd40000),.release_step(16'd5),
        .event_valid(valid),.event_ready(ready),.event_data(data),.panic_request(panic_request),.rx_high(),
        .byte_count(bytes),.message_count(messages),.framing_errors(frame_errors),.overflows(overflows),
        .ignored_offs(ignored),.steals(steals),.last_note(last_note),.last_velocity(last_velocity),.last_channel(last_channel),
        .pedal_mask(pedals),.held_count(held),.sounding_count(sounding),.queued(queued),.white_keys(white_keys));
    wire router_ready,cfg_valid,cfg_gate,cfg_restart;
    wire [4:0] voice;wire [31:0] step;wire [2:0] wave;
    wire [15:0] level,attack,decay,sustain,release_step;
    wire [31:0] held_mask;reg [31:0] active=0;
    assign ready=router_ready && !stall;
    performance_router router(.clk(clk),.rst(rst),.clear(clear || panic_request),.cancel(1'b0),
        .event_valid(valid && !stall),.event_ready(router_ready),.event_data(data),.event_source(3'd0),
        .drum_valid(),.drum_ready(1'b1),.drum_pad(),.cfg_valid(cfg_valid),.cfg_ready(!stall),
        .cfg_voice(voice),.cfg_gate(cfg_gate),.cfg_restart(cfg_restart),.cfg_step(step),.cfg_wave(wave),
        .cfg_level(level),.cfg_attack(attack),.cfg_decay(decay),.cfg_sustain(sustain),.cfg_release(release_step),
        .voice_active_mask(active),.held_mask(held_mask),.held_count(),.live_held_count(),
        .events_applied(),.notes_applied(),.steals(),.ignored_offs());
    integer checks=0,ons=0,offs=0,kills=0,restarts=0,faults=0;
    integer last_level=0;reg [31:0] steps[0:31];
    always @(posedge clk)begin
        if(rst || clear || panic_request)active<=0;
        else if(cfg_valid && !stall)begin
            if(cfg_gate)begin
                ons=ons+1;active[voice]<=1;steps[voice]<=step;last_level=level;
                if(cfg_restart)restarts=restarts+1;
                if(wave>4)$fatal(1,"reserved waveform escaped the router");
            end else begin
                offs=offs+1;
                if(level==0)begin kills=kills+1;active[voice]<=0;end
                else if(wave!=1 || release_step!=5 || attack!=269)$fatal(1,"release profile lost");
            end
        end
        if(panic_request)faults=faults+1;
    end
    task check(input condition,input [639:0] message);
        begin checks=checks+1;if(!condition)$fatal(1,"%0s",message);end
    endtask
    task clocks(input integer n);begin repeat(n)@(negedge clk);end endtask
    task send_byte(input [7:0] value);
        integer bit_number;
        begin
            @(negedge clk);#3;rx=0;clocks(BIT_CYCLES);
            for(bit_number=0;bit_number<8;bit_number=bit_number+1)begin rx=value[bit_number];clocks(BIT_CYCLES);end
            rx=1;clocks(BIT_CYCLES);
        end
    endtask
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
