Lonelyrockroll/qiansai/(commit log)

2026-11-01 Add the verified Tang Mega 60K synthesizer and keyboard hardware project
    [c4_peaks.csv, c4_spectra.csv]
2026-11-01 Add expressive pitch gestures and held-turn volume to the J18 keypad
2026-11-01 Calibrate PT8211 output bias against measured sustain distortion
2026-11-01 Clarify SRAM power-cycle procedure for screen guidance
2026-11-02 Add offline spectrum acceptance and measure physical key onset
    Add a board-local 32/31 tone test, gated I2S onset timing, calibrated key velocity, Android score downloads and key mapping, and an optional PC audio analyzer. Preserve the routed key scanner regression and real SRAM measurements alongside the competition audit.
    [fft.csv, measurements.csv, peaks.csv, spectrum.csv, synthetic_fall.csv, synthetic_rise.csv]
2026-11-02 Show measured key latency and synchronized scope captures
    Compare calibrated FPGA I2S timestamps, oscilloscope pulse widths, and two-channel analog onset measurements. The local display preserves raw evidence and keeps Ampero audio-only recordings separate.
2026-11-02 Distinguish Hall-to-speaker electrical onset from headphone measurements
2026-11-02 Explain the U1 header hookup for a fixed Hall channel
2026-11-02 Record calibrated fixed-key to speaker onset from paired scope channels
2026-11-02 Strengthen reverb delay and chorus and unify their presets
    [audio_effects.v, baseline_reference.py, board_check.py, generate_phrase.py, listen.py, phrase.v]
2026-11-02 Prepare the current verified project for GitHub
2026-11-03 Correct BMV wiring and record standalone MIDI validation
